dkhorn/organ/docs/CXSOMzauSu_CasavantOp3091R1983TrinitybytheCoveNaplesFL03.jpg

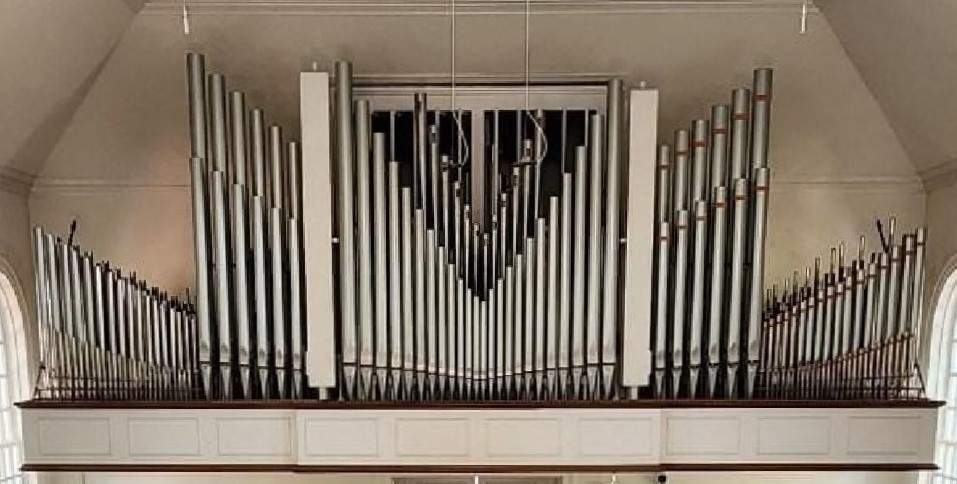
docs/CXSOMzauSu_CasavantOp3091R1983TrinitybytheCoveNaplesFL03.jpg
