dkhorn/organ/docs/TrinityCasevantPlan.png

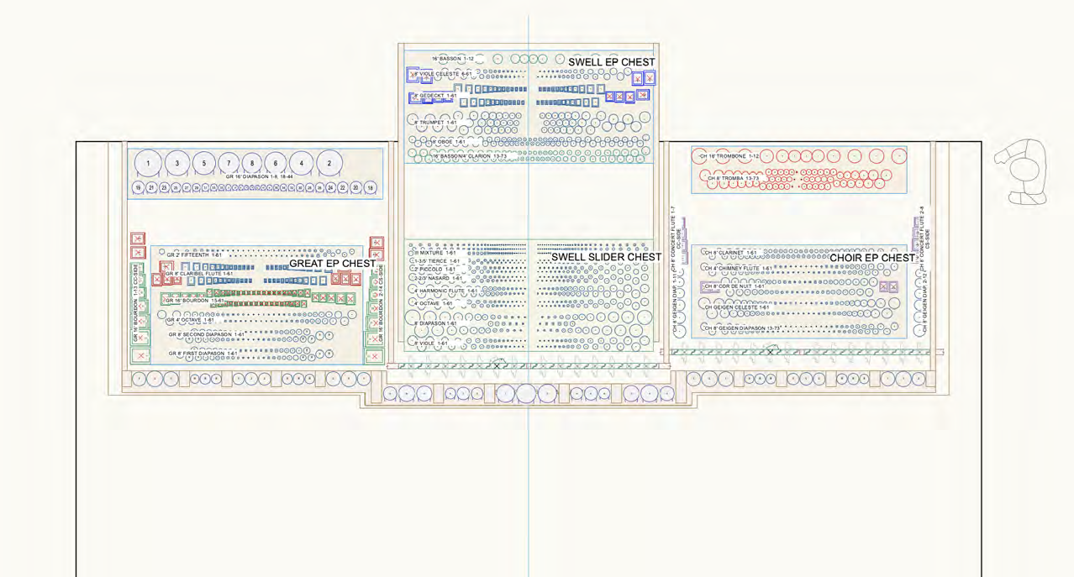
docs/TrinityCasevantPlan.png
