dkhorn/organ/docs/casavant_stoplist.md

```
Naples, Florida

Trinity-by-the-Cove Episcopal Church

Casavant Frères Ltée., Opus 3091, 1971
Casavant Frères Ltée., Opus 3091-R, 1983 - Tonal expansion
Thomas Helms, Jr., 2007 - Tonal Revision
```

## GRAND ORGUE
- 16    Bourdon
- 8     Montre
- 8     Flute à Cheminée
- 8     Viole de Gambe 8   (Réc.)  --
- 4     Prestant
- 4     Flute conique      (Réc.)  --
- 2     Petite Flute
- II    Cornet
- III   Mixture
-       Cloches

##      POSITIV
- 8     Bourdon
- 8     Viole de Gambe 8   (Réc.)  --
- 8     Voix céleste       (Réc.)  --
- 8     Flute douce        (Réc.)  --
- 4     Flute à Fuseau
- 4     Viole 4            (Réc.)  --
- 4     Flute douce 4      (Réc.)  --
- 2 2/3 Nasard 
- 2     Doublette
- 8     Cromorne
-       Tremblant

##     RÉCIT (Expressif/Swell)
- 16    Flute douce
- 8     Flute ouverte
- 8     Viole de Gambe
- 8     Voix céleste
- 8     Flute douce
- 4     Prestant
- 4     Flute conique
- 4     Viole 
- 4     Flute douce
- II    Quarte
- 16    Basson
- 8     Trompette
- 8     Hautbois
- 4     Petit Clairon
- 8     Voix humaine
-       Tremblant
-       Clochettes

##      PÉDALE
- 32    Basse acoustique           --  Soubasse
- 16    Soubasse
- 16    Bourdon            (G.O.)  --
- 16 & 8 Flutes douces     (Réc.)  --
- 8     Octave Basse
- 8     Viole              (Réc.)  --
- 8     Bourdon            (G.O.)  --
- 5 1/3 Quinte         (Soubasse)
- 4     Octave
- 4     Bourdon            (G.O.)  --
- 16    Bombarde
- 16    Basson             (Réc.)  --
- 8     Trompette          (Réc.)  --
- 8     Hautbois           (Réc.)  --
- 4     Hautbois           (Réc.)  --

      NOTES
The organ console The organ has a full complement of unison,
sub and super couplers; Positiv-Grand Orgue manual transfer;
five pistons for each division; twelve general combination
pistons; fifty memories; and transposer.

[Submitted by James R. Stettner  2023-05-01.]
