dkhorn/organ/docs/video_scripts/01_pipe_organ_intro_script.md

# Video Script Draft

## Title: So I Started Building a Pipe Organ…

---

## 0:00 — Cold Open (On Camera)

**Visuals**

- You sitting in the workshop
- large pipes and windchests visible behind you
- gesture toward the pile

**Dialogue (on camera)**

This pile of parts behind me is a pipe organ.

Or at least… part of one. Eventually.

---

## 0:10 — Montage / Voiceover

**Visuals**

- piles of pipes
- windchests
- console
- large pipes leaning on walls

**Voiceover**

But to explain how we got here… we need to go back a little.

---

## 0:15 — I Build Instruments (On Camera + Montage)

**On Camera**

I'm a musician… but I'm also an engineering‑minded tinkerer.

And for as long as I can remember I've liked building instruments.

**Cut to Montage**

- harp
- dulcimer
- whistles
- ukulele

**Voiceover**

Over the years I've made a few small ones — a harp, a dulcimer, some whistles… and most of a ukulele.

But like many engineering projects… things have a tendency to escalate.

---

## 0:50 — Why Pipe Organs (Voiceover)

**Visuals**

- pipe organs
- keyboards
- large pipe façades
- interior shots

I've played a lot of different instruments. But ever since I first encountered one in high school, the pipe organ has been my *dream* instrument.

Musically, nothing else really compares. A large organ can feel like having an entire orchestra under your hands.

To be clear, I'm not talking about this [very brief snippet of very boring organ music], but this: [very brief snippet of huge organ blast].

But what fascinated me just as much was the engineering. An organ isn't just an instrument — it's a huge machine with thousands of precision‑made moving parts.

For centuries they were among the most complicated mechanical systems people knew how to build.

And having one around to tinker with would be a sort of meta‑hobby — something that could involve woodworking, mechanics, electronics, and eventually music.

---

## 2:05 — The First Idea

So when I finished my last big project and looked at the clean workshop, I thought:

Why not finally build that pipe organ you've always wanted?

From scratch.

How hard could it be?

---

## — How a Pipe Organ Works (Quick Explanation)

**Visuals**

- keyboard being pressed
- valve / windchest diagram or footage
- air entering pipe
- pipes of different shapes
- stop knob being pulled

**Voiceover**

The basic idea is simple.

Each pipe plays one note when air flows through it.

Press a key… a valve opens… and air goes into the pipe.  Press a different key, air goes into a different pipe.

Long pipes make low notes. Short pipes make high notes.

Pipes with similar tone are grouped together into a *rank*. A keyboard needs about 61 pipes for a single rank.

The organist turns ranks on and off using *stops*, often combining many ranks at once.

Large organs may have dozens of ranks speaking together — which is what creates that huge symphonic sound.

---

## - DIY?

Pretty straightforward. They managed to build organs in the 16th century — surely I could figure it out in the 21st with modern tools and materials, right?

Well… after looking at a few DIY organ projects that others have completed, I realized that unless I invested in a lot of specialized equipment, I was going to be pretty limited in what I could realistically build.

And the result would probably be a lot of work… and a fairly feeble instrument.  It turns out that I really don't like DIY pipe organs

---

## 2:25 — A Better Plan

So instead of starting from nothing, I started looking for an instrument I could adopt as a starting point.

Here's where things got interesting. The "used organ" market is a strange place. Large organs are often very integrated with the building they're installed into, and it can be quite costly to extract them and rebuild them somewhere else.

As a result, while a good small studio or chapel organ might run tens of thousands of dollars, you can sometimes find much larger organs listed as basically *free to a good home*.

So why on earth should I start from scratch?

---

## 2:35 — Enter Paul Kruger (On Camera + Voiceover)

**On Camera**

That's when I met Paul Kruger.

**Voiceover / Visuals**

- photos of the Wicks organs
- pipes
- windchests

Paul is a lifelong organ enthusiast who had collected the remains of several similar small-to-medium-sized pipe organs, all built around 1940 by the same company - Wicks.

He had intended to restore these organs in one way or another, but currently had them in basically a "pile of parts" state.  He was ready to let it all go to someone who would attempt to continue his work.  This sounded like the perfect match for what I wanted to do - I figured I could learn a lot from picking up where he left off, and should be able to get a decent small organ out of it.

---

## 3:10 — The Arrival

**Visuals**

- unloading pipes
- workshop chaos

Which is how a truckload of organ parts ended up in my shop.

---

## 3:40 — The Work Begins - Termites

**Visuals**

- termite‑damaged boards
- cleaning parts
- inspecting wood
- photos of the big oven

Before everything was even off the truck, I hit the first surprise: termites.

Some console parts had been stored in rough conditions and picked up some very unwelcome guests. A few pieces were beyond saving and never made it into the shop — but I wanted to rescue as much as possible.

So I built a very large, very improvised oven — about eight feet long — using a space heater, fans, temperature probes, and a thermostat.

Every piece of wood went through it: slowly up to about 135°F internally, then held there for 12 hours.

After that, I didn’t see a single live termite. To be safe, everything also got treated with a borax-based wood insecticide.

The bugs were gone… but the damage remained. Most parts are salvageable with restoration; some will become templates for new ones.

---

## 4:10 — Pipe Sorting

**Visuals**

- measuring pipes
- laying pipes out
- organizing ranks

At the same time, I needed to figure out what I actually had.

Pipe organs are organized into rows called **ranks** — each one a full set of pipes covering the keyboard.

Each rank has dozens of pipes, and every pipe has a specific place.

So this meant sorting through hundreds of pipes from several different instruments… and putting them back into order.

---

## 4:20 — Electronics Work

**Visuals**

- solenoids
- old wiring
- CAD / PCB design
- electronics bench

In parallel, I started designing the organ’s new “central nervous system.”

The original organs used decades-old electrical systems.

Rather than restore all of that directly, the plan is to replace it with a modern control system — new wiring, new drivers, and eventually custom circuit boards.

So while the wood and pipes were being sorted… the electronics were being reinvented.

---

## 5:20 — The Tonal Plan

With the pipes identified, woodwork stabilized, and a path for modern electronics, I could finally step back and ask: what instrument am I actually building?

The collection had good foundations — about seven ranks — but it leaned heavily toward quieter, more expressive stops.

To get closer to a convincing organ, I needed a stronger principal chorus, real open 8′ tone, and some reeds.

---

## 5:45 — Filling the Gaps

So I started looking.

Very quickly I connected with another organ enthusiast in Naples, Jonathan Birner. His church had just remodeled and had a couple of orphaned ranks available.

They’re small but important: a four‑rank **mixture** and a 2′ **fifteenth** — exactly what I needed to build out the top of the principal chorus.

---

## 6:10 — Still Missing Voices

Even with those additions, the core was still incomplete.

I was missing the backbone of the sound:

Real **8′ principals**… and **reeds**.

---

## 6:35 — The Suggestion

A few weeks later, Jonathan sent me a message:

“Have you seen this listing? Looks like it has what you need.”

It was another church in Naples preparing to demolish and rebuild. A new organ was already planned, and the existing one needed to be removed — free to anyone willing to extract it.

It had exactly the ranks I needed to push my project into a respectable medium‑sized instrument.

---

## 7:20 — The Catch

There was one line in the listing:

“Preference will go to someone willing to take the entire instrument.”

---

## 7:35 — The Decision (On Camera recommended)

I assumed that made it impractical — someone would surely take the whole thing before I could cherry‑pick a few ranks.

Then I mentioned it off-hand to my wife, Ashley.

Her response was immediate:

“Just get the whole thing. Why not?”

I didn’t really have a good answer.  I probably should have.  But I didn't.

---

## 7:50 — Escalation

So I went down to take a look.

It’s a large organ, originally built in the 1970s and expanded in the 80's by French organ buliders Casavant — three manuals, pedal, about 23 ranks, and something like 1,800 pipes.

It had suffered from hurricane damage. The console was completely lost, and there’s some water intrusion in parts of the windchests.

But overall… it’s in remarkably good condition — honestly better than some of the Wicks components I’ve already been restoring. And the pipework is excellent.

So… why not.

I committed to rescuing the entire instrument over the next several months.

And instead of adding a few ranks to my earlier design, I'm pivoting to make the Casavant the core of the instrument, with my previous small organ thoughtfully integrated.

So at the end of this, if all goes well, instead of a completely improvised small organ with a fully-jumbled provenance, I will have "Casevant, Opus 3091, 1971; Expanded 1983; Expanded and relocated 2026" [text on screen]

---

## 8:10 — Series Teaser

In the coming videos we’ll go into some detail about things that I've already been working on, and hopefully cover new developments as they happen.:

- planning the Casavant extraction
- designing the new instrument
- restoring windchests
- building the control system
- sorting and voicing pipes
- and eventually assembling it all into a working organ

---

## 8:40 — Closing (On Camera)

So I started building a pipe organ.

Let’s see where this goes.

So I started building a pipe organ.

Let's see where this goes.
