dkhorn/organ/docs/TrinityOrganChecklist.docx

ACCESS & EXTRACTION PATH

☐ Exterior loading area documented (photos)

☐ Truck access confirmed (clearance, backing space)

☐ Path from organ to exit photographed

☐ Narrowest doorway width measured

☐ Lowest ceiling clearance measured

☐ Stair count + widths measured

☐ Tight corners / obstacles documented

☐ On-site staging area identified

OVERALL ORGAN LAYOUT

☐ Full frontal overview photo

☐ Side overview photo(s)

☐ Chamber/back overview photo

☐ Division locations identified (GO / POS / REC / PED)

☐ Quick layout sketch drawn

☐ Swell box location identified

☐ Blower location identified

PIPEWORK – INVENTORY & MASS

☐ All visible façade ranks photographed

☐ Largest flue pipe length estimated

☐ Largest flue pipe diameter estimated

☐ Confirmed no pipes > 8′ physical

☐ 8′ open bass ranks identified (count)

☐ 16′ stopped ranks identified (count)

☐ Reed resonators photographed (bass end)

☐ Wood bass pipes photographed (if present)

☐ Rank labels / markings photographed

CHESTS & ACTION

☐ Chest type identified (slider / unit / EP / other)

☐ Number of chests per division counted

☐ Chest dimensions measured (L × D × H)

☐ Pallet / slider condition visually checked

☐ Magnet/solenoid condition photographed

☐ Any visible water damage documented

☐ Chest mounting method observed (bolted / screwed / fixed)

REEDS

☐ 16′ reeds inspected (rust / condition)

☐ 8′ reeds inspected (rust / condition)

☐ Reed resonator material noted (zinc / spotted metal / other)

☐ Boots / blocks condition checked

☐ Reed tuning wires intact

WIND SYSTEM

☐ Regulators/reservoirs counted

☐ Regulator dimensions measured

☐ Pressure markings photographed

☐ Separate wind pressures identified (if any)

☐ Wind trunk routing photographed

☐ Trunk attachment method noted

ELECTRICAL

☐ Existing wiring harnesses photographed

☐ Connectors identified

☐ Relay panels located (if present)

☐ Junction boxes documented

☐ Any labeling system photographed

CONDITION SURVEY

☐ Dents in metal pipes noted

☐ Corrosion on metal pipes noted

☐ Wood pipe cracks / delamination checked

☐ Tuning slides present and functional

☐ Evidence of mold / severe humidity damage checked

☐ Structural case stability assessed

EXTRACTION PLANNING NOTES

☐ Sequence of pipe removal considered

☐ Rackboard removal method observed

☐ Chest removal constraints identified

☐ Estimated manpower required noted

☐ Estimated truck size required noted

☐ Special tools required noted

QUESTIONS ETC

☐ Documentation?

☐ Timing – don’t want to sit too long without climate control

GRAND ORGUE

16 Bourdon

8 Montre

8 Flute à Cheminée

4 Prestant

2 Petite Flute

II Cornet

III Mixture

POSITIV

8 Bourdon

4 Flute à Fuseau

2 2/3 Nasard

2 Doublette

8 Cromorne

PÉDALE

16 Soubasse

8 Octave Basse

4 Octave

16 Bombarde

RÉCIT (Expressif)

16 Flute douce

8 Flute ouverte

8 Viole de Gambe

8 Voix céleste

8 Flute douce

4 Prestant

4 Flute conique

4 Viole

4 Flute douce

II Quarte

16 Basson

8 Trompette

8 Hautbois

4 Petit Clairon

8 Voix humaine

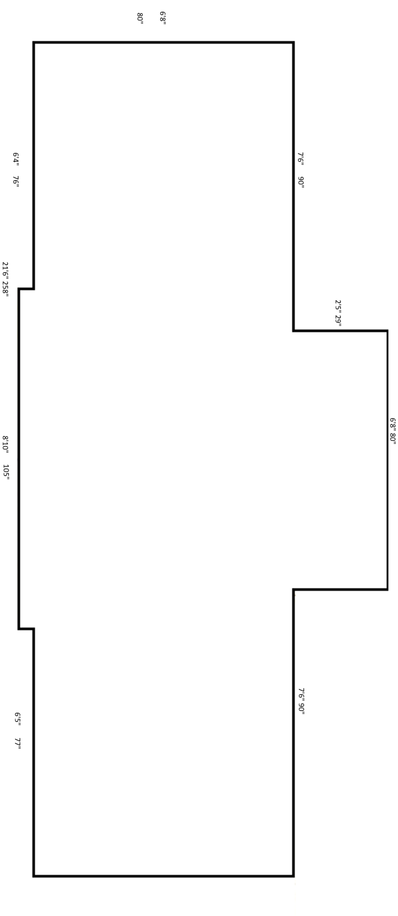
[picture p3: figure]
