dkhorn/organ/docs/ranklist.md

# Ranks - by windchest

## Casavant Great Slider
These are not individually addressable and cannot be borrowed other than via coupling
- 8' Flute a Cheminee - 61 notes - (Chimney Flute - 4' physical length)
- 4' Prestant - 61 notes
- 4' Petite Flute - 61 notes
- Cornet II - 61 notes (122 pipes)
- Mixture IV - 61 notes (244 pipes)

## Casavant Great Facade
These are all individually addressable and can be borrowed, unified, etc
- 16' Bourdon (metal, stopped, 8' physical length) - 61 notes
- 8' Montre (metal, open, 8' physical length) - 61 notes

## Casavant Positiv Slider
These are not individually adressable and cannot be borrowed other than via coupling
- 8' Bourdon (metal, stopped, 4' physical length) - 61 notes
- 4' Flute a Fuseau - 61 notes
- 2 2/3' Nasard - 61 notes
- 2' Doublette - 61 notes
- 8' Cromorne (reed - half-length, 4' physical length) - 61 notes

## Casavant Pedal facade
Individually addressable, can be borrowed, unified, etc
- 16' Soubasse (wood, 8' physical length) - 32 notes
- 8' Octave Basse (metal principal-type) - 44 notes - (also used as a "4' Octave" stop)
- 16' Bombarde (reed, metal, 8' physical length) - 32 notes

## Casavant Swell Slider
Not individually addressable
- 8' flute ourverte (metal, open, 8' length) - 61 notes
- 4' Prestant (metal, open,  4' length) - 61 notes
- Mixture II - 61 notes (122 pipes)

## Casavant Swell Unit
All individually addressable, borrowable, etc
- 8' trumpet (reed, metal, 8' length) - 61 notes - also used as 4' clarion stop
- 16' Bassoon/ 8' Oboe (reed, metal, half-length resonators (longest is 8')) - 73 notes
- 8' Viole de Gambe (flute, metal, open, 8' length) - 61 notes - also used as 4' Viole stop
- 8' Fl. Douce (flute, metal, conical, 8' length) - 73 notes - also used as 16' and 4' stops
- 8' Celeste (flute, metal, open, Tenor C (longest pipe is 4')) - 49 notes

## Casavant Swell extensions
All individually addressable, borrowable, etc
- 4' Flute conique - 61 notes
- 8' Vox Humana - 61 notes

## Wicks Unit chest
All individually addressable, borrowable, etc
- 8' Stopped Flute (wood, stopped, physical length 4') - 85 notes - can be unified 8', 4', or 2', or mutations
- 4' Salicional - (metal, open) 61 notes
- 4' Celeste - (metal, open) 49 notes (no top octave)

## Wicks/Other principal chorus chest
All individually addressable - but the mixture pipes are combined per note into a single valve
- 4' Open Diapason (Metal, open, Wicks)- 61 notes
- 2' fifteenth (Metal, open, not Wicks) - 61 notes
- Mixture IV (Metal, open, not Wicks) - 61 notes (244 pipes)

## Wicks Gedeckt
individually addressable
- 16' Gedeckt (Stopped flute, physical length 8', bass octave on extension chest) - 97 notes - can be unified 16', 8', 4', 2, or mutations

## Ancient Bourdon
- 16' large-scale bourdon (wood, stopped, 8' physical length) - 32 notes (pedal)

# Divisions
Here's how the above windchests will be physically arranged by division

Great/Pedal (unenclosed):
- Casavant Great Slider
- Casavant Great Facade
- Casavant Pedal facade
- Ancient Bourdon

Positiv (unenclosed):
- Casavant Positiv Slider
- Wicks/Other principal chorus chest

Swell/Recit (enclosed, with operable shades):
- Casavant Swell Slider
- Casavant Swell Unit
- Casavant Swell Extensions
- Wicks Gedeckt

Echo/Choir:
- Wicks Unit chest

# StopList
Great
- 16 Montre (8' Montre)
- 16 Bourdon
- 8 Montre
- 8 Bourdon (16' Bourdon)
- 8 Flûte à Cheminée
- 4 Prestant
- 4 Petite Flûte
- 2 Fifteenth (Positiv)
- Cornet II
- Mixture IV
- 8 Trompette (Swell)
- 8 Oboe (Swell)
- 4 Clarion (Swell)

Positiv
- 8 Montre (Great)
- 8 Bourdon
- 4 Principal
- 4 Flûte à Fuseau
- 2 2/3 Nasard
- 2 Fifteenth
- 2 Doublette
- Mixture IV
- 8 Cromorne

Recit/Swell (Enclosed)
- 16 Gedeckt
- 8 Viole de Gambe
- 8 Voix Céleste
- 8 Flûte Douce
- 8 Gedeckt (16' Gedeckt)
- 2 2/3 Nazard (8' Fl Douce)
- 1 3/5 Tierce (8' Fl Douce)
- 4 Viole
- 4 Flûte Conique
- 4 Flute Douce (8' Fl Douce)
- 4 Gedeckt (16' Gedeckt)
- 2 Gedeckt (16' Gedeckt)
- 2 Flute Douce (8' Fl Douce)
- Plein Jeu II
- 16 Bassoon
- 8 Vox Humana
- 8 Trompette
- 8 Hautbois (16' Bassoon)
- 4 Clarion (4' Trompette)

Choir/Echo
- 8 Stopped Flute
- 8 Salicional (4' Sal)
- 8 Celeste (4' Cel)
- 2 2/3 Nazard (8' Stopped Fl)
- 1 3/5 Tierce (8' Stopped Fl)
- 4 Stopped Flute (8' Stopped Fl)
- 4 Salicional
- 4 Celeste
- 2 Stopped Flute (8' Stopped Fl)

Pedal
- 32 Resultant (Soubasse + Quinte)
- 16 Soubasse
- 16 Bourdon
- 16 Gedeckt (Swell)
- 5 1/3 Quinte (Soubasse)
- 8 Octave
- 8 Bourdon (Great)
- 8 Gedeckt (Swell)
- 4 Choralbass (Octave)
- 4 Gedeckt (Swell)
- 16 Bombarde
- 16 Bassoon (Swell)
- 8 Trompette (Swell)
- 8 Hautbois (Swell)
- Mixture IV (Pos)
