dkhorn/organ/docs/stoplist_wicks_hybrid.md

# Hybrid Pipe Organ – Stoplist v3.2
**3 Manuals + Pedal**

This revision incorporates:
- M5 (1′ Violin / Flachflute) moved into the Swell box as a high string color
- Choir division made entirely borrowed / digital (“playground manual”)
- No borrowing out of tremmed ranks
- W2 physically split into unenclosed (A) and Swell (B) chests
- W1 extended downward to form a true open 8′ flute rank

Legend  
(P) = real pipes  
(D) = digital  
(E) = extension / unification  
(B) = borrowed  

---

## GREAT (Manual I)
_Unenclosed_

| Stop | Pitch | Source |
|-----|---|---|
| Principal | 8′ | M1 (P) |
| Octave | 4′ | M1 (P) |
| Fifteenth | 2′ | M1 (E)(P) |
| Principal | 16′ | M1 (E)(P) |
| Mixture | IV–V | (D) |
| Trumpet | 8′ | (D) |
| Clarion | 4′ | (D) |
| Flute | 8′ | W1 (P) |
| Flute | 4′ | W1 (P) |
| Bourdon | 16′ | W2-A (B)(P) |
| Bourdon | 8′ | W2-A (B)(E)(P) |

---

## SWELL (Manual II)
_Enclosed · Tremulant_

| Stop | Pitch | Source |
|-----|---|---|
| Salicional | 8′ | M4 (P) |
| Voix Celeste | 8′ | M3 (P, sharp) |
| Salicional | 4′ | M4 (E)(P) |
| Dulciana | 8′ | M2 (E)(P) |
| Gedackt | 8′ | W2-B (P) |
| Flute | 4′ | W2-B (E)(P) |
| **High String / Piccolo** | **2′** | **M5 (E)(P)** |
| Fifteenth | 2′ | (D) |
| Mixture | III | (D) |
| Oboe | 8′ | (D) |
| Trumpet | 8′ | (D) |
| Tremulant | — | — |

Notes:
- M5 resides physically in the Swell box and is affected by expression and tremulant.
- W2-B is a dedicated Swell-only chest (no borrowing out).

---

## CHOIR / SOLO (Manual III)
_Playground Manual — borrowed & digital only_

| Stop | Pitch | Source |
|-----|---|---|
| Lieblich Gedackt | 8′ | W2-A (B)(E)(P) |
| Flute | 4′ | W2-A (B)(E)(P) |
| Piccolo | 2′ | M5 (B)(E)(P, non-tremmed) |
| Nazard | 2 2⁄3′ | (D) |
| Tierce | 1 3⁄5′ | (D) |
| Larigot | 1 1⁄3′ | (D) |
| Cymbale | III | (D) |
| Clarinet | 8′ | (D) |
| Vox Humana | 8′ | (D) |
| Tremulant | — | (D only) |

Notes:
- No pipes live physically in the Choir.
- Borrowed ranks are non-tremmed and level-scaled digitally.
- Choir trem affects digital voices only.

---

## PEDAL
_Unenclosed · Hybrid_

| Stop | Pitch | Source |
|-----|---|---|
| Bourdon | 16′ | W2-A (P) |
| Tibia Bass | 16′ | W3 (P) |
| Subbass (free reed) | 16′ | R1 (P) |
| Bourdon | 8′ | W2-A (E)(P) |
| Flute | 4′ | W2-A (E)(P) |
| Open Flute | 8′ | W1 (B)(P) |
| Principal | 8′ | M1 (B)(E)(P) |
| Mixture | IV | (D) |
| Trombone | 16′ | (D) |
| Trumpet | 8′ | (D) |
| Resultant | 32′ | (D) |

---

## COUPLERS
- Swell → Great  
- Choir → Great  
- Swell → Choir  
- Great → Pedal  
- Swell → Pedal  
- Choir → Pedal  
- Sub / Super couplers as musically appropriate  

---

## PHYSICAL SUMMARY (v3.2)

### Swell Box (expressive, tremmed)
- M4 — Salicional (61 pipes)
- M3 — Voix Celeste (49 pipes)
- M5 — High string / Piccolo (49 pipes - dedicated chest)
- W2 — Swell Gedackt / Flute (85 pipes)
- Digital Swell reeds & mixture (Speakers)
- Single tremulant

### Unenclosed
- M1 — Principal chorus (61 pipes)
- W1 — Open flute 8′ / 4′ (85 pipes + 12 to-be-constructed on floor)
- W2-B — Bourdon family low (12 on floor)
- W3 — Tibia bass (24 large pipes)
- R1 — Free-reed subbass (no pipes, just a box)
- Digital pedal foundations

### Choir
- No physical pipes
- Borrowed and digital only

---

## DESIGN PRINCIPLES ENFORCED
- No borrowing out of tremmed ranks
- No rank serves contradictory wind behaviors
- Manual 16′ ≠ Pedal 16′
- Digital ranks fill brilliance and extreme ranges, not foundations
