dkhorn/organ/docs/IrjlOnneqD_CasavantOp3091R1983TrinitybytheCoveNaplesFL02.jpg

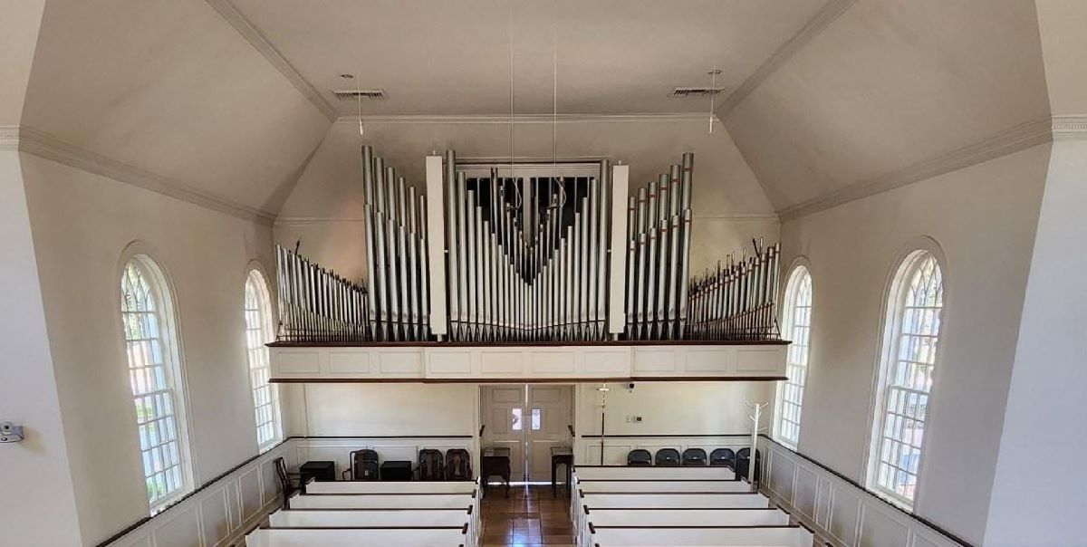
docs/IrjlOnneqD_CasavantOp3091R1983TrinitybytheCoveNaplesFL02.jpg
