dkhorn/organ/docs/TrinityCasevantElevation.png

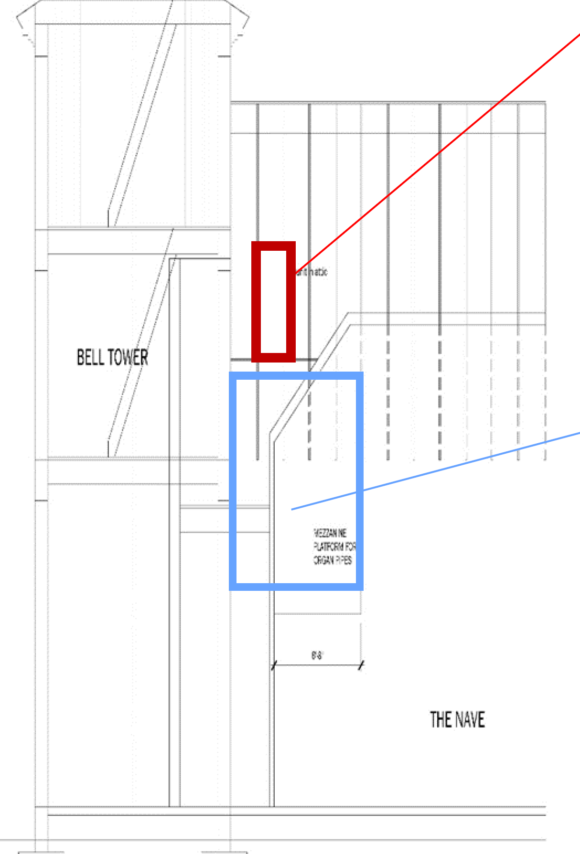
docs/TrinityCasevantElevation.png
