dkhorn/organ/docs/TrinityCasevantPlan_Blank.png

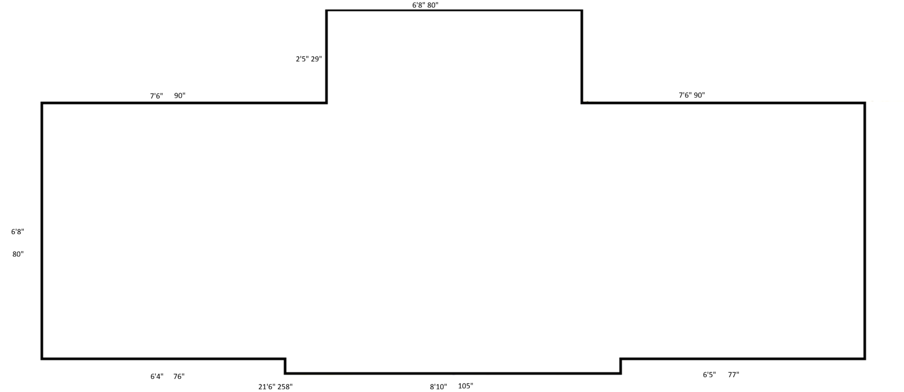
docs/TrinityCasevantPlan_Blank.png
