dkhorn/organ/docs/inventory.md

# Pipe Organ Project — Physical Inventory

_Last updated: 2025-12-22_

This document records **all physical components currently in possession**, without assuming future purchases.  
Descriptions are factual; condition notes are included where relevant.

---

## 1. Consoles & Control Furniture

### C1 — Black Console
- Manufacturer: Wicks
- Model: Fuga Deluxe
- Opus: **1471**
- Condition: structurally intact
- Notes:
  - Opus number “1471” written in multiple internal locations

### C2 — Walnut Console
- Manufacturer: Wicks
- Opus: **2107**
- Condition: intact
- Notes:
  - Brass dedication plaque present (Wilhite home installation)

### C3 — Salvaged Console Components
- Manufacturer: Wicks
- Opus: **2472**
- Salvaged components:
  - Manual stack (2 manuals)
  - Stopboard
  - Pedalboard
- Condition:
  - Original casework destroyed (termite damage)
  - Salvaged components serviceable

---

## 2. Wind Supply Components

### WND-1 — Main Blower
- Output pressure measured:
  - ~4″ w.g. nominal
  - ~5″ w.g. with increased regulator weight
- Status: operational

### WND-2 — Standalone Regulator
- Connections: 6″ OD inlet / outlet
- Status: intact

### WND-3 — Wind Distribution Box
- Input: 8″
- Outputs: 7 × ~4″
- Status: intact

---

## 3. Complete Windchests

### CH-1 — Large Black Wicks Unit Chest
- Dimensions: 59.75″ W × 19″ D × 9″ H
- Pipe seat markings:
  - A1–A32
  - B1–17
  - C1–25
  - D1–25
  - E1–11
  - F1–16
  - G1–30
  - H1–31
  - R1–4, L1–4
- Wind connections:
  - Bottom: 4″ and 6″ flanges
  - Top: centered 2″ flange
- Electrical:
  - 50-pin connectors
  - All solenoids present but rusted
- Condition:
  - Chest leaky but salvageable
  - Soundboard and rack in good condition
  - Solenoids require rebuild

### CH-2 — Hobes Sound Unit Chest
- Dimensions: 18″ L × 12″ D × 11″ H
- Material: blonde wood
- Electrical:
  - Solenoids present
  - 50-pin connector
- Status: intact

### CH-3 — 12-Note Bass Windchest (Stopped Wood Flutes)
- Function: lowest octave (8′ physical / 16′ pitch)
- Compass: 12 notes
- Valve type: electric-pneumatic
- Dimensions:
  - Chest: 69″ L × 9″ D × 4.5″ H
  - Rack: 69″ W × 60″ H
- Condition:
  - Slight leakage
  - Fully functional

---

## 4. Rack Boards

### RK-1 — Black Rack Board
- Width: 59.75″
- Depth: 16″
- Matches: CH-1
- Status: good

---

## 5. Loose Soundboards

### SB-1 — Small Irregular Soundboard
- Dimensions: 52″ × 9″ × 1.25″
- Channels: 24
- Hole sizes: ~3/8″–3/4″
- Layout: irregular
- Electrical:
  - 24 solenoids present
  - Wiring intact (nail terminals)
- Wind port: 4.25″
- Condition:
  - Solenoids rough
  - No matching rack

### SB-2 — Large Wicks-Style Soundboard
- Dimensions: 84″ × 10″ × 1″
- Channels: 85
- Hole sizes: ~3/4″ to ~1/4″
- Construction:
  - Largest 12 backed by +1″ thickness
- Electrical:
  - 24 solenoids present
- Condition:
  - Structurally sound
  - Action incomplete

### SB-3 — Termite-Damaged Soundboard
- Dimensions: 84″ × 10″ × 1″
- Channels: ~128 (30 + 31 + 33 + 34)
- Electrical:
  - ~45 solenoids present
- Condition:
  - Severe internal termite damage
  - Template/reference only

### SB-4 — Unit-Chest Soundboard (Single Rank)
- Dimensions: 65″ × 7″ × 1″
- Channels: 61
- Hole sizes: ~3/4″ to ~1/8″
- Electrical:
  - All solenoids present
  - Free-moving
  - Pads degraded
- Markings:
  - “rank3”

### SB-5 — Unit-Chest Soundboard (Double Rank)
- Dimensions: 65″ × 12.75″ × 1″
- Channels:
  - Rank A: 61
  - Rank B: 85
- Construction:
  - Largest 6 holes backed by +1″ thickness
- Electrical:
  - Solenoids present
  - ~30% require rework
  - Pads degraded

---

## 6. Pipes (High-Level Summary)

### Metal Ranks
- M1 — Open Diapason, 4′ (61 pipes)
- M2 — Dulciana, 4′ (49 pipes)
- M3 — Salicional, 4′ (49 pipes)
- M4 — Salicional, 4′ (61 pipes)
- M5 — Violin / Flachflute, 1′ (49 pipes)

### Wood Ranks
- W1 — Stopped Flute, 4′ physical  (8' pitch)
  (7 octaves: 61 wood + 24 metal treble, mitred basses)
- W2 — Stopped Flute, 8′ physical  (16' pitch)
  (8 octaves: 73 wood + 24 metal treble)
- W3 — Wide-scale "tibia"-ish Stopped Flute, 8′ physical  (16' pitch) 
  (bass only - 2 octaves: 24 wood pipes) 
### Reed
- R1 - Wicks free-reed subbass box 16' (1 octave, 12 notes)
---

## 7. Solenoids & Small Parts

- Reisner solenoids:
  - 140 blue, 90 Ω
  - 30 tan, 90 Ω
  - 260 tan, 75 Ω
  - 8 gray, 90 Ω
- Peterson solenoids:
  - 7 × 90 Ω
  - 2 × 60 Ω
  - 2 × 50 Ω
- Miscellaneous:
  - 1 Franz Heissler solenoid (12 V, 28 Ω)
  - 6 medium unmarked solenoids (~30 Ω)
- Felt:
  - ~100 × 22 mm
  - ~100 × 18 mm
  - ~100 × 16 mm

---

## 8. Notes

- Inventory reflects all parts currently owned.
- Future changes should be appended rather than rewritten.
