dkhorn/organ/kicad/OrganLEDArray/assembly/OrganLEDArrayBOM.xlsx

Comment | Designator | Footprint | JLCPCB Part #（optional）
green LED | D1,D2,D3,D4,D5,D6,D7,D8,D9,D10,D11,D12,D13,D14,D15,D16,D17,D18,D19,D20,D21,D22,D23,D24 | LED_0603_1608Metric
6.8k | R1,R2,R3,R4,R5,R6,R7,R8,R9,R10,R11,R12,R13,R14,R15,R16,R17,R18,R19,R20,R21,R22,R23,R24 | R_0603_1608Metric
0.1u | C1 | C_0603_1608Metric
