dkhorn/organ/3dmodels/keyparts/PedalKeyswitchShims-Body.stl

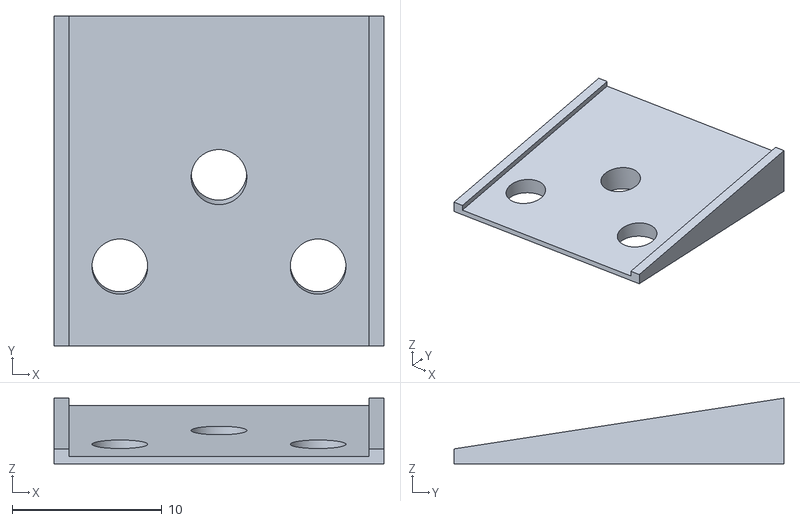
[picture p7: CAD file, 2026-04-03]
3dmodels/keyparts/PedalKeyswitchShims-Body.stl
22.0 x 22.0 x 4.39
