dkhorn/organ/3dmodels/pipes/StoppedFluteWoodBase.FCStd

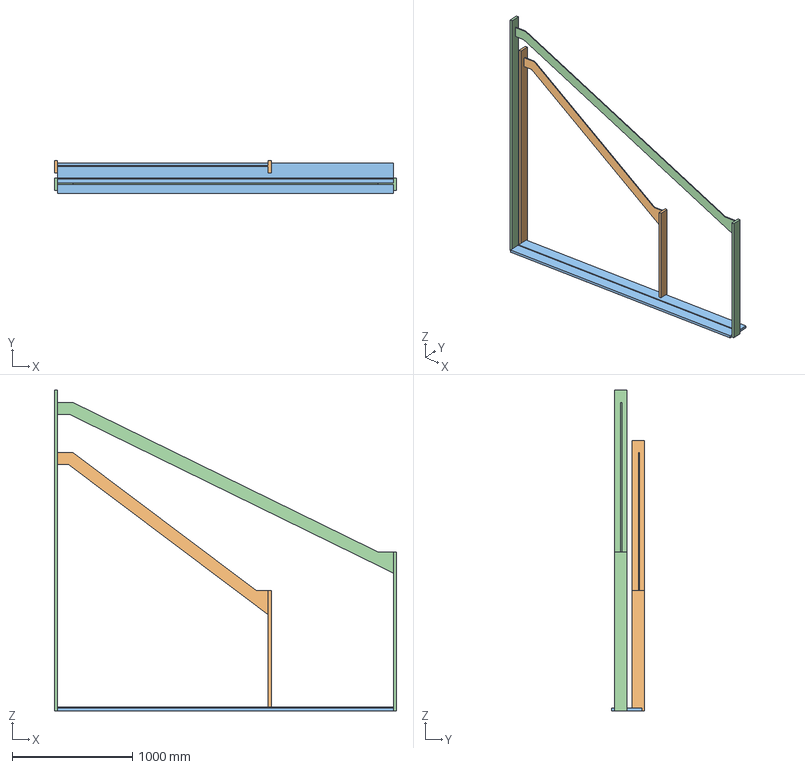
[picture p8: CAD file, 2026-03-30]
3dmodels/pipes/StoppedFluteWoodBase.FCStd
2844.8 x 273.1 x 2667.0 mm
ToeBoard
Rail
ToeBoard001
Rail001
