dkhorn/organ/3dmodels/tools/Combs/IDC26Comb.FCStd

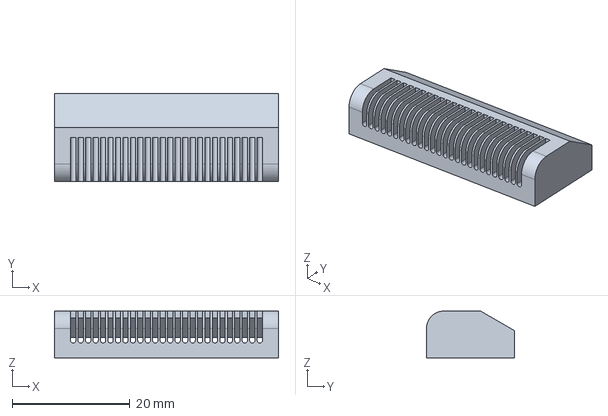
[picture p9: CAD file, 2026-02-11]
3dmodels/tools/Combs/IDC26Comb.FCStd
38.1 x 15.0 x 8.00 mm
