dkhorn/organ/3dmodels/tools/KeyBushingCauls/KeyBushingCauls_1475-Single.stl

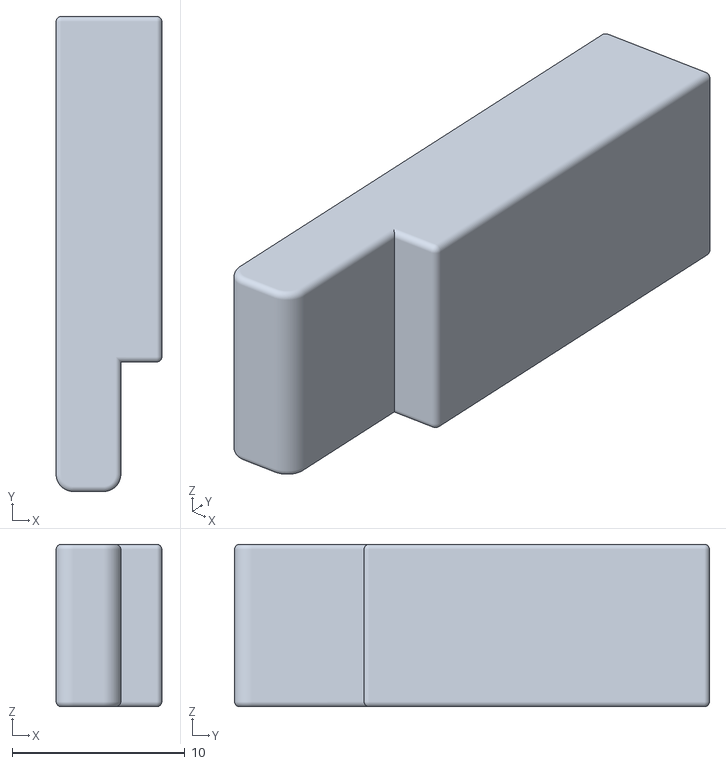
[picture p10: CAD file, 2026-02-11]
3dmodels/tools/KeyBushingCauls/KeyBushingCauls_1475-Single.stl
6.12 x 27.5 x 9.40
