dkhorn/organ/3dmodels/tools/planning/pipe_trays.FCStd

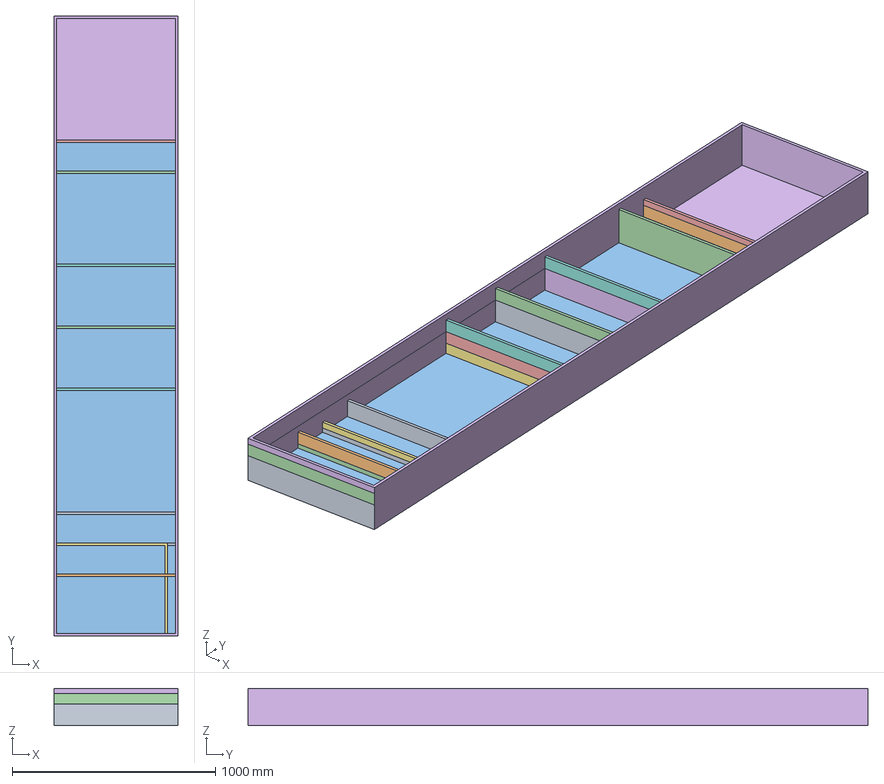
[picture p11: CAD file, 2026-03-26]
3dmodels/tools/planning/pipe_trays.FCStd
609.6 x 3048.0 x 184.2 mm
Box90x24x4
Box90x24x3
Box90x24x2
Box90x24x6
Box72x24x4
Box72x24x3
Box72x24x2
Box72x24x6
Box60x24x4
Box60x24x3
Box60x24x2
Box60x24x6
Box48x24x4
Box48x24x3
Box48x24x2
Box48x24x6
Box24x24x3
Box24x24x2
Box24x24x1
Box120x24x008
Box120x24x6
Box120x24x7
Box18x24x3
Box18x24x2
Box18x24x1
Box12x24x3
Box12x24x2
Box12x24x1
Box90x24x5
Box72x24x5
Box60x24x5
Box48x24x5
Box120x24x5
Box96x24x4
Box96x24x3
Box96x24x2
Box96x24x6
Box120x24x4
