dkhorn/organ/3dmodels/tools/UniversalTransferPunch_bases.stl

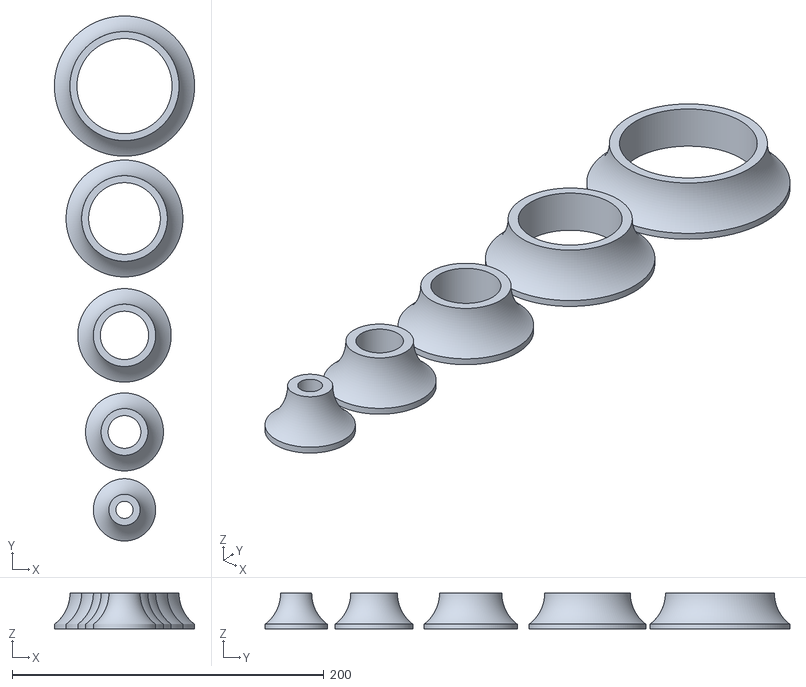
[picture p12: CAD file, 2026-03-05]
3dmodels/tools/UniversalTransferPunch_bases.stl
90.0 x 337.0 x 23.0
