dkhorn/organ/3dmodels/valveparts/double_valve_pin_guides-ValveStemGuide38.stl

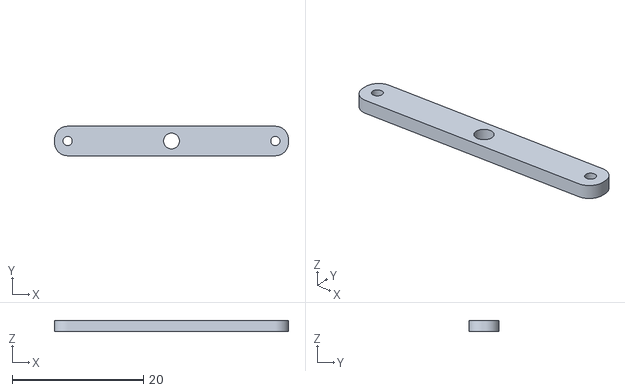
[picture p13: CAD file, 2026-03-05]
3dmodels/valveparts/double_valve_pin_guides-ValveStemGuide38.stl
35.6 x 4.50 x 1.75
