dkhorn/organ/3dmodels/planning/organ_layout.FCStd

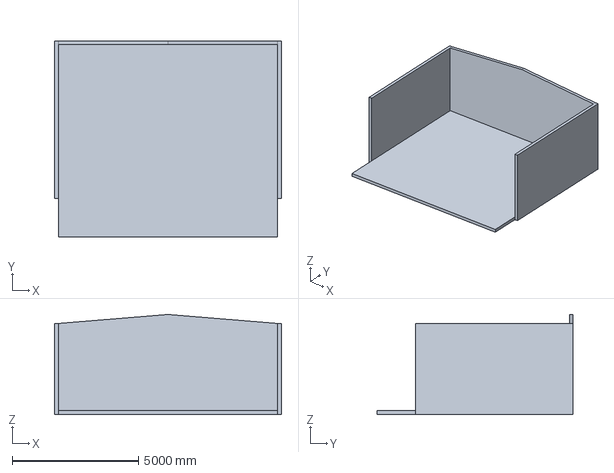
[picture p14: CAD file, 2026-03-16]
3dmodels/planning/organ_layout.FCStd
8991.6 x 7772.4 x 3962.4 mm
