dkhorn/organ/3dmodels/tools/KeyBushingCauls/KeyBushingCauls_1475.FCStd

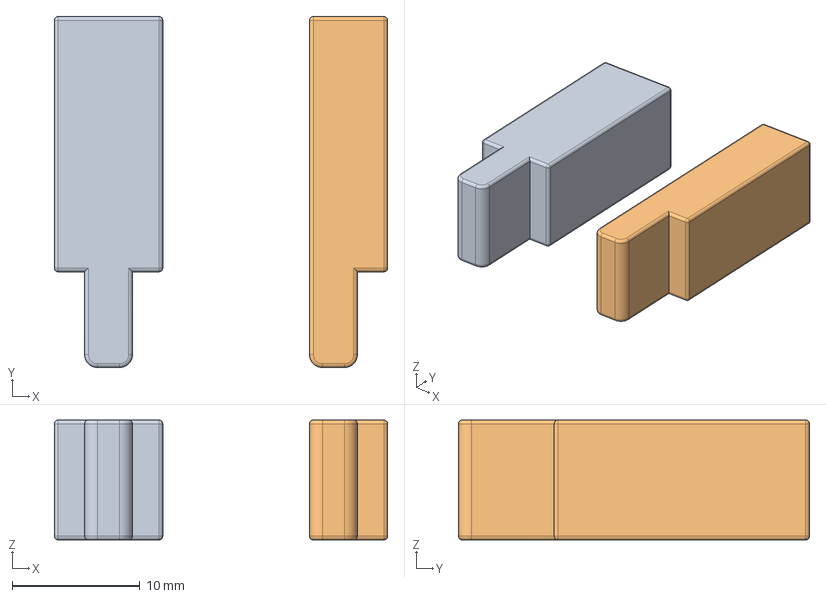
[picture p15: CAD file, 2026-02-11]
3dmodels/tools/KeyBushingCauls/KeyBushingCauls_1475.FCStd
26.1 x 27.5 x 9.40 mm
Double
Single
