dkhorn/organ/3dmodels/tools/planning/ranks_bigvan.FCStd

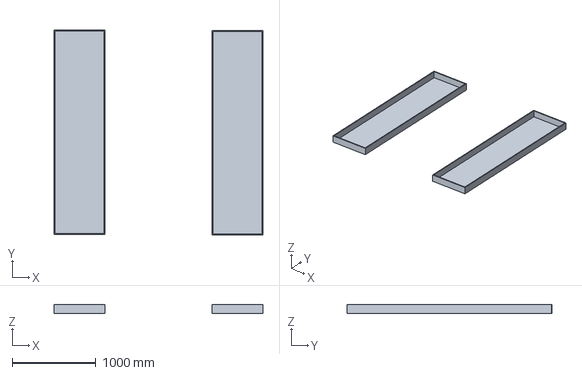
[picture p16: CAD file, 2026-03-26]
3dmodels/tools/planning/ranks_bigvan.FCStd
2492.6 x 2443.4 x 107.9 mm
Box96x24x4 x 6
