dkhorn/organ/3dmodels/tools/UniversalTransferPunch_tools.stl

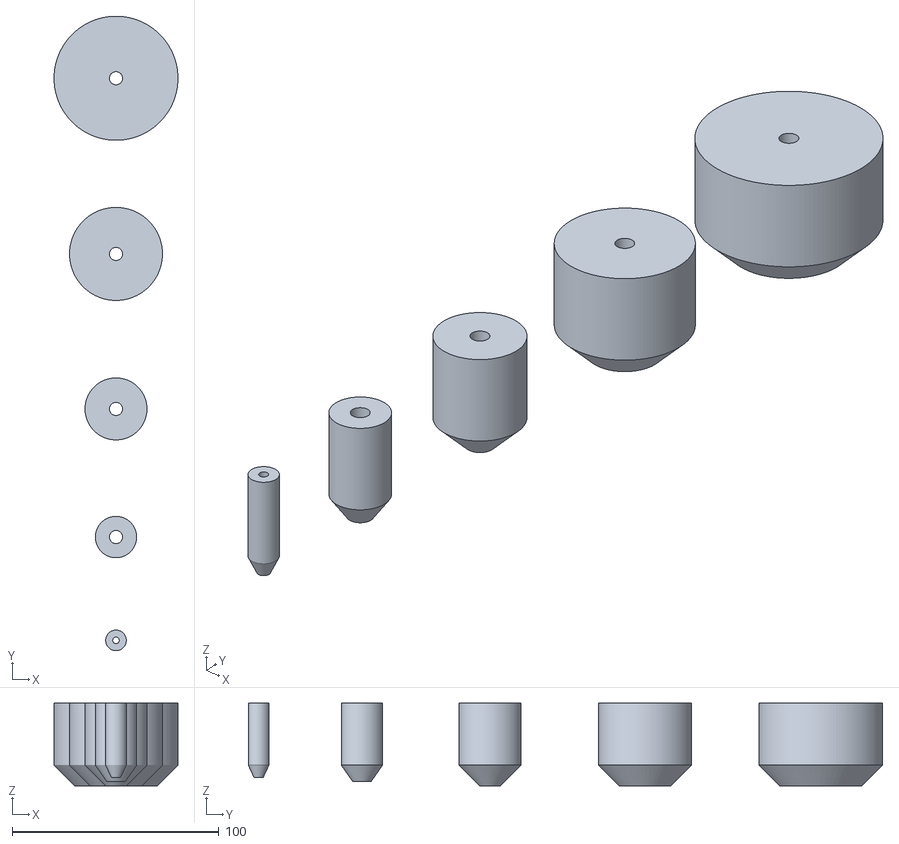
[picture p17: CAD file, 2026-03-05]
3dmodels/tools/UniversalTransferPunch_tools.stl
60.0 x 307.0 x 40.0
