dkhorn/organ/3dmodels/valveparts/double_valve_pin_guides.FCStd

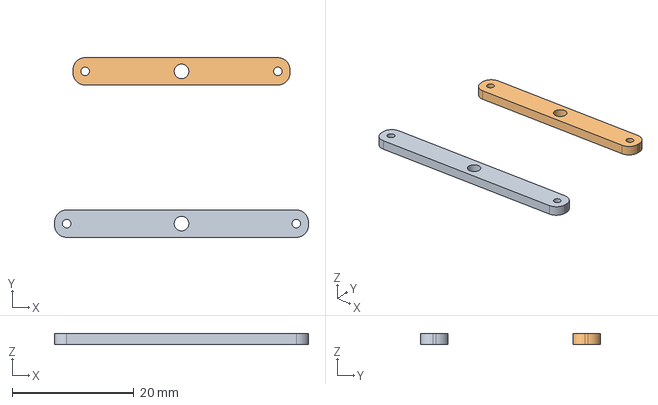
[picture p18: CAD file, 2026-03-05]
3dmodels/valveparts/double_valve_pin_guides.FCStd
41.7 x 29.5 x 1.75 mm
ValveStemGuide45
ValveStemGuide38
