dkhorn/organ/3dmodels/planning/organ_layout-printable-1.5scale.3mf

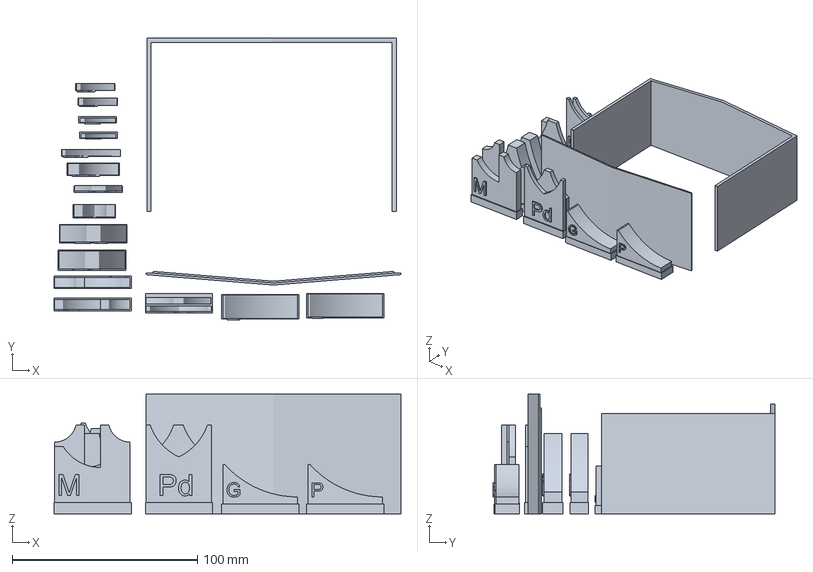
[picture p19: CAD file, 2026-03-10]
3dmodels/planning/organ_layout-printable-1.5scale.3mf
187.6 x 152.2 x 64.8 mm
