dkhorn/organ/3dmodels/tools/KeyBushingCauls/KeyBushingCauls_1475-Double.stl

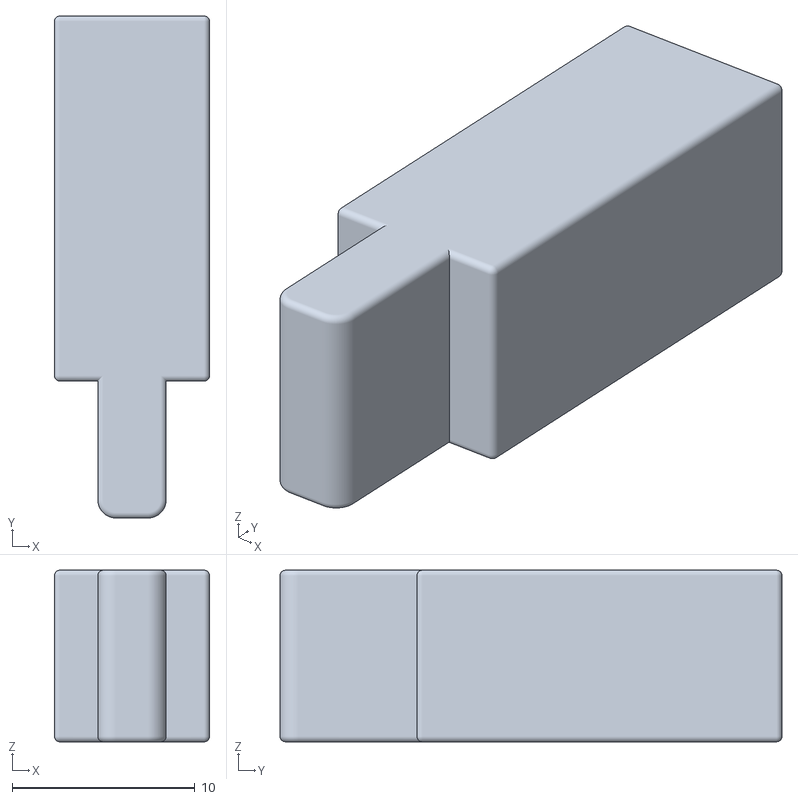
[picture p20: CAD file, 2026-02-11]
3dmodels/tools/KeyBushingCauls/KeyBushingCauls_1475-Double.stl
8.50 x 27.5 x 9.40
