dkhorn/organ/3dmodels/tools/UniversalTransferPunch.FCStd

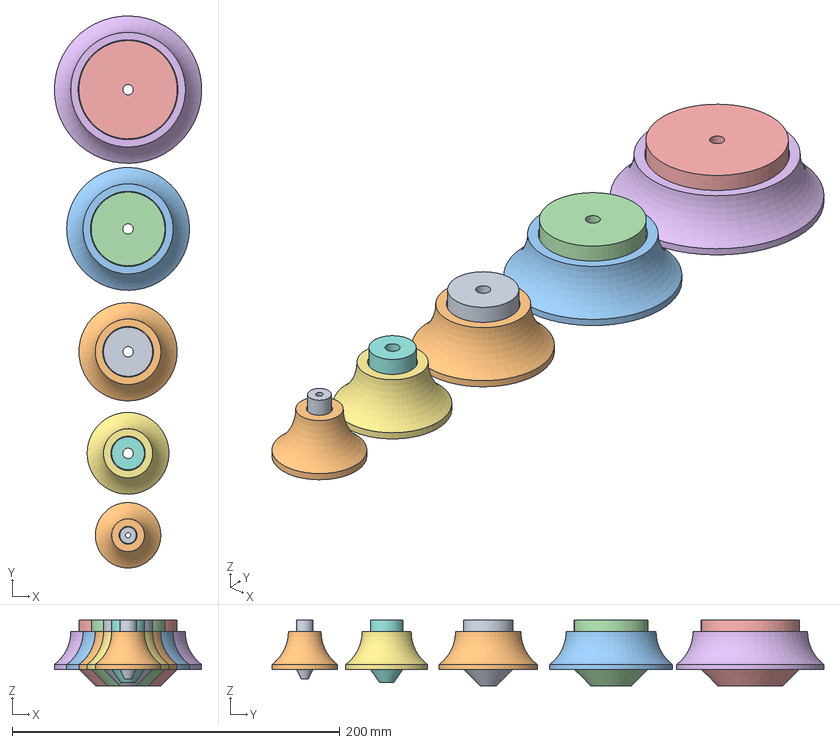
[picture p21: CAD file, 2026-03-05]
3dmodels/tools/UniversalTransferPunch.FCStd
89.9 x 337.0 x 40.0 mm
Tool30 x 2
Base30 x 2
Base45 x 2
Tool45 x 2
Tool60 x 2
Base60 x 2
Base20 x 2
Tool20 x 2
Tool10 x 2
Base10 x 2
