dkhorn/organ/3dmodels/valveparts/double_valve_pin_guides-ValveStemGuide45.stl

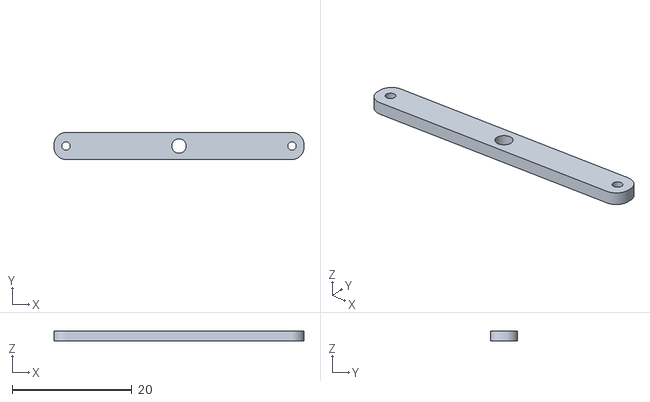
[picture p22: CAD file, 2026-03-05]
3dmodels/valveparts/double_valve_pin_guides-ValveStemGuide45.stl
41.7 x 4.50 x 1.75
