dkhorn/organ/3dmodels/planning/organ_layout-printable.stl

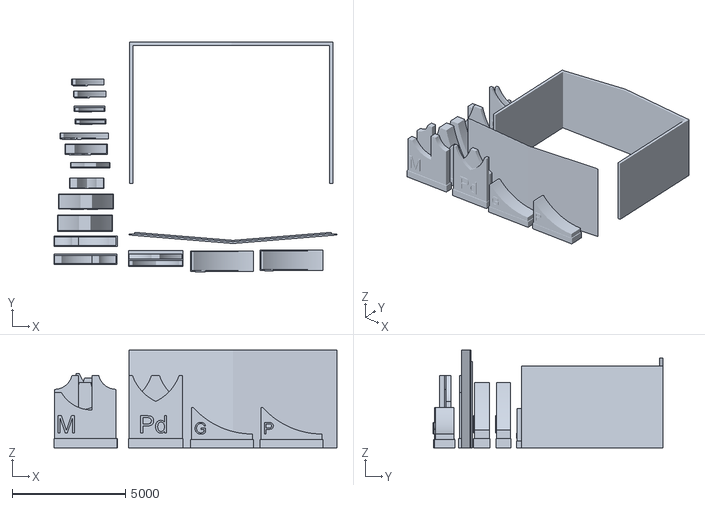
[picture p23: CAD file, 2026-03-09]
3dmodels/planning/organ_layout-printable.stl
12503.8 x 10148.8 x 4318.0
