dkhorn/organ/3dmodels/planning/pipes_prototypes.FCStd

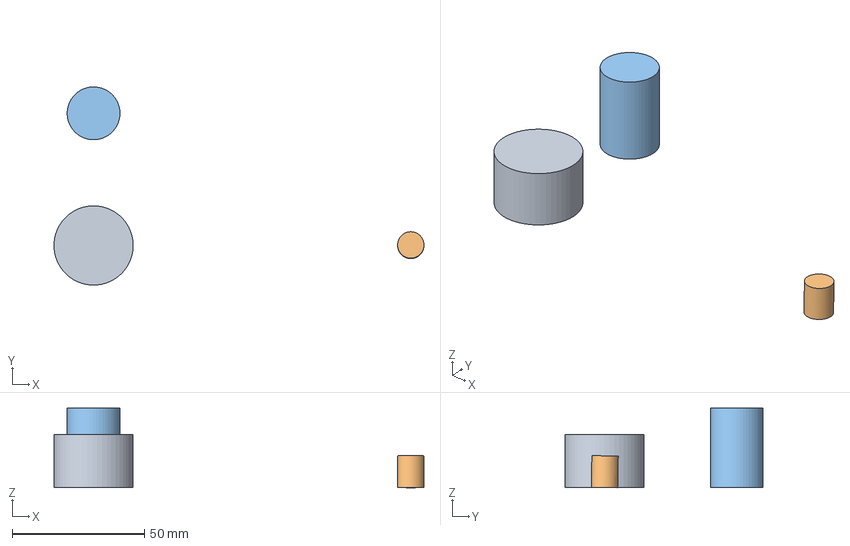
[picture p24: CAD file, 2026-03-05]
3dmodels/planning/pipes_prototypes.FCStd
140.0 x 75.0 x 30.1 mm
