dkhorn/organ/3dmodels/tools/planning/windchests.FCStd

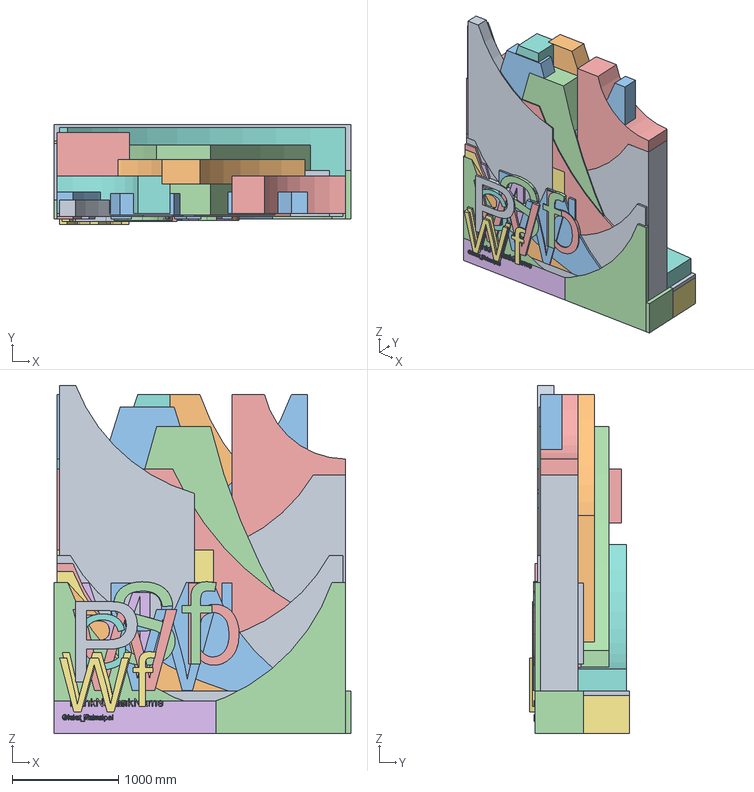
[picture p25: CAD file, 2026-03-16]
3dmodels/tools/planning/windchests.FCStd
2794.0 x 939.8 x 3276.6 mm
Chest1
Rank_Linear
Rank_MiddleHigh
Rank_MiddleLow
Positiv_Chest
Pos_Cromorne
Great_Chest
Great_Chorus
Pedal_Chest
Pedal_Bombarde
Pedal_OctaveBass
GreatFront_Chest
GreatMontre_Bass
GreatMontre_Treble
PositivFront_Chest
GreatBourdon_Bass
GreatBourdon_Treble
SwellFront_Chest
SwellBack_chest
Rank_SwellUnUnified
Rank_SwellUnified
SwellBack_chest001
Rank_MiddleLow001
SwellBack_chest002
Rank_MiddleLow002
WicksSubBass_chest
Rank_WicksSubBass_chest
WicksBourdonPedal_Chest
WicksBourdonRank
WicksFlutes_Chest
WicksFlutes_Rank
PedalSubbassC_Chest
PedalSubbassC_Rank
PedalSubbassCSharp_Chest
PedalSubbassCsharp_Rank
WicksPrincipalChorusC_Chest
WicksPrincipalChorusC_Rank
WicksPrincipalChorusCSharp_chest
WicksPrincipalChorusCSharp_rank
PassageBoard
