dkhorn/organ/3dmodels/tools/planning/pipe_blocks.FCStd

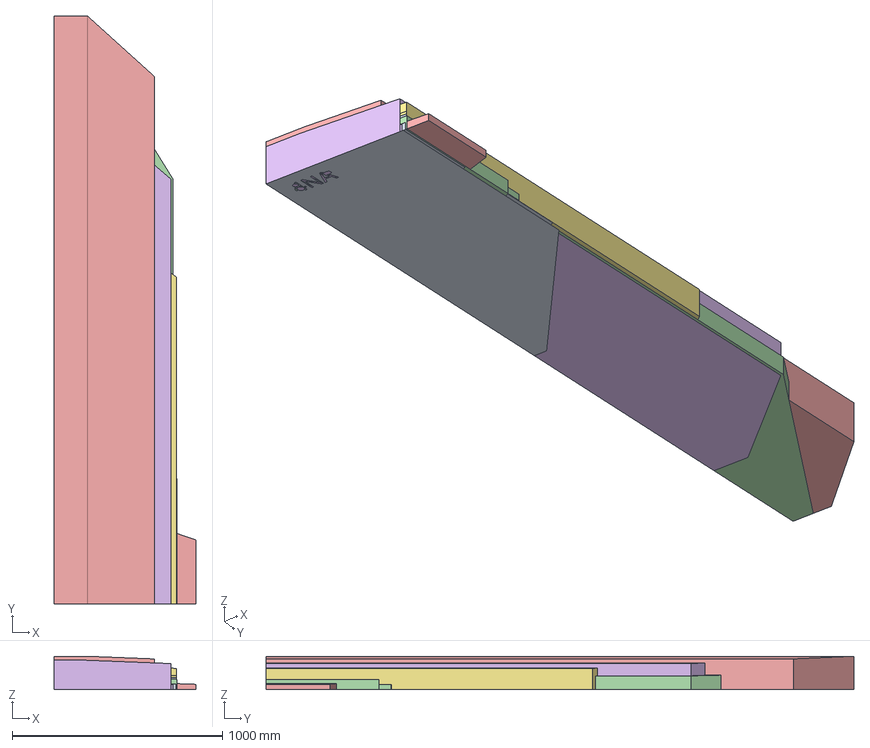
[picture p26: CAD file, 2026-03-09]
3dmodels/tools/planning/pipe_blocks.FCStd
673.9 x 2794.0 x 158.8 mm
1WA
1WB
1WS
2WA
2WB
2WS
NWA
NWB
NWC
NWS
4WA
4WB
4WC
4WD
4WE
4WS
4NA
4NB
4NS
4NES
8WA
8WB
8WC
8WD
8WE
8WF
8WS
8NA
8NB
8NC
8NS
8NES
8WPS
8WPEF
8WPES
8NPC
