dkhorn/organ/(list of files, cad)

Other CAD files:
3dmodels/planning/organ_layout_2.FCStd
3dmodels/keyparts/PedalKeyswitchShims.FCStd
3dmodels/pipes/BourdonPedalPipes.FCStd
3dmodels/pipes/BourdonPedal.FCStd
3dmodels/tools/planning/ranks.FCStd
3dmodels/tools/planning/VanPacking.FCStd
