dkhorn/organ/kicad/OrganKeyswitchBreakout/OrganKeyswitchBreakout.kicad_pcb

## KiCad design kicad/OrganKeyswitchBreakout/OrganKeyswitchBreakout.kicad_pcb (2026-02-11)

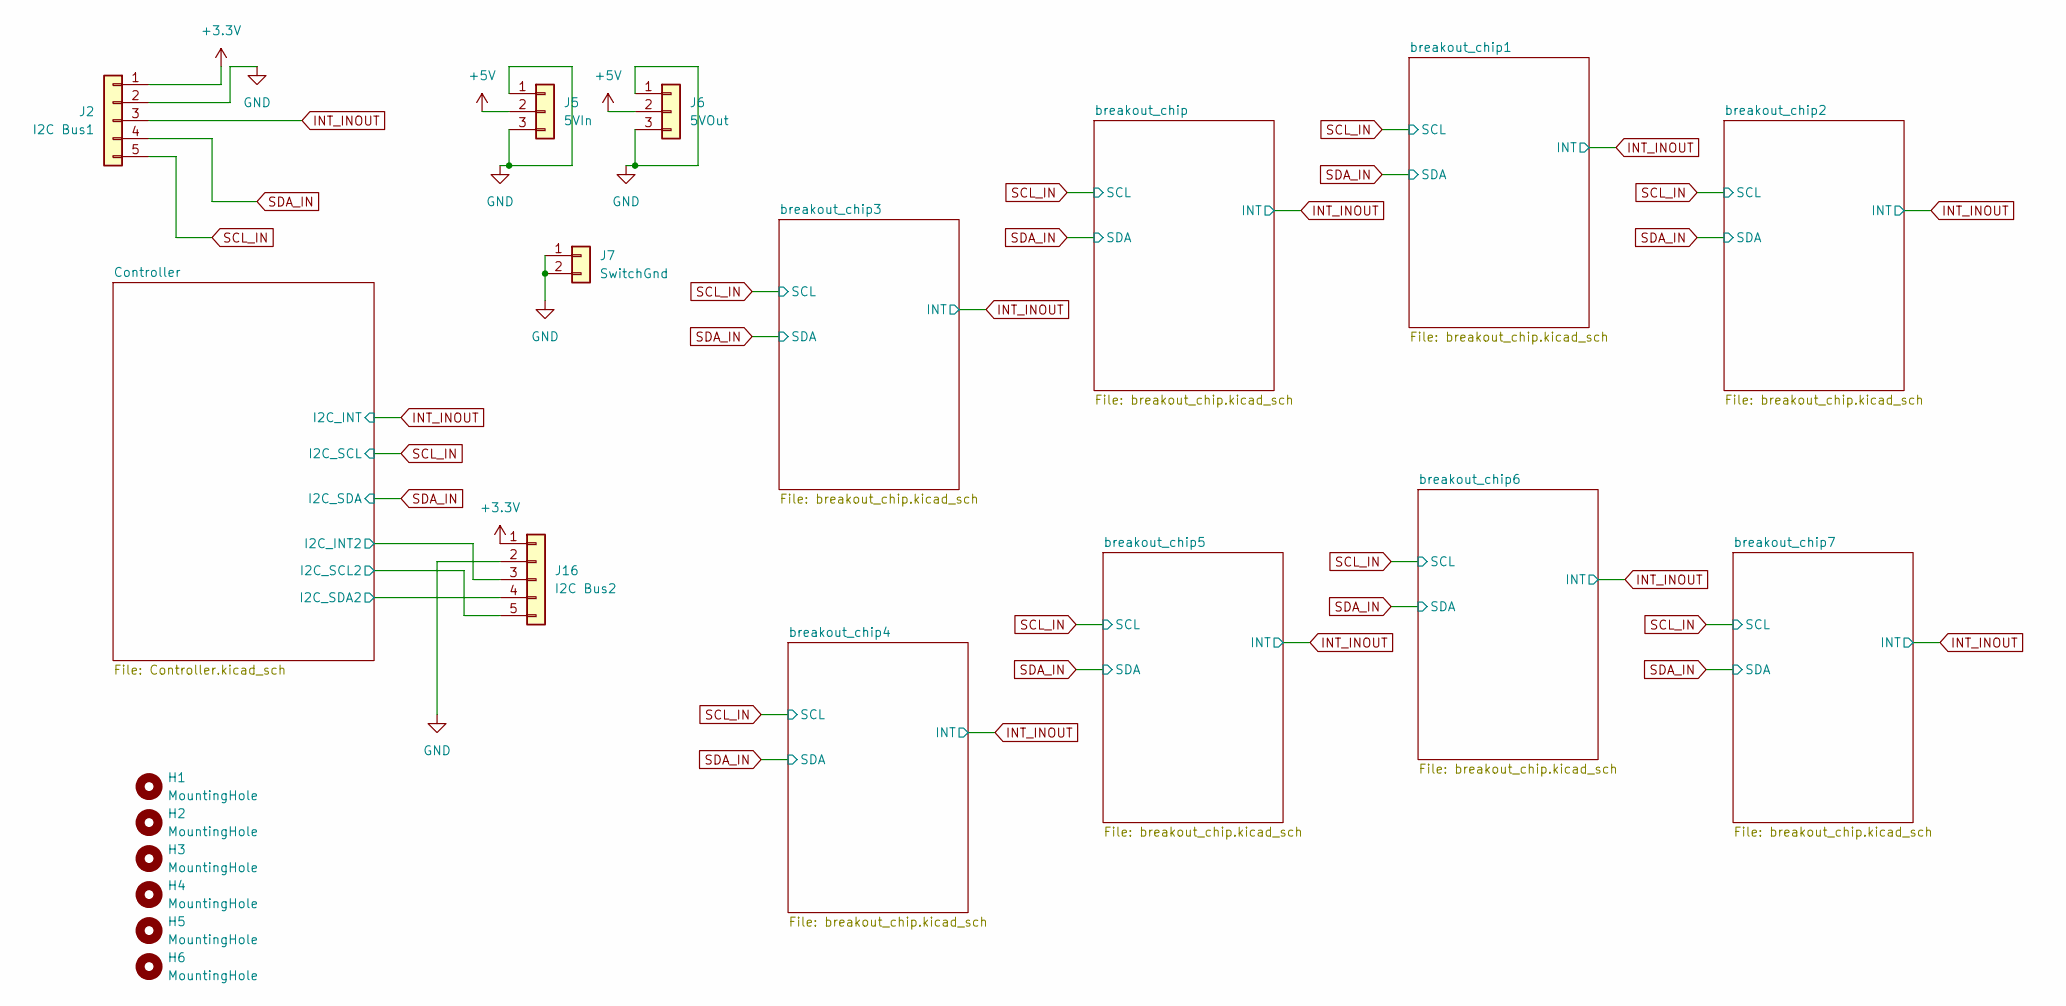
[picture p27: schematic OrganKeyswitchBreakout.kicad_sch]

Parts:
H1, H2, H3, H4, H5, H6: MountingHole; MountingHole_3.2mm_M3
J2: I2C Bus1; JST_PH_B5B-PH-K_1x05_P2.00mm_Vertical
J5: 5VIn; JST_PH_B3B-PH-K_1x03_P2.00mm_Vertical
J6: 5VOut; JST_PH_B3B-PH-K_1x03_P2.00mm_Vertical
J7: SwitchGnd; JST_PH_B2B-PH-K_1x02_P2.00mm_Vertical
J16: I2C Bus2; JST_PH_B5B-PH-K_1x05_P2.00mm_Vertical

Connections:
+3.3V: J2.1, J16.1; also elsewhere on the board
+5V: J5.2, J6.2; also elsewhere on the board
/Controller/I2C_INT2: J16.3; also elsewhere on the board
/Controller/I2C_SCL2: J16.5; also elsewhere on the board
/Controller/I2C_SDA2: J16.4; also elsewhere on the board
GND: J2.2, J5.1, J5.3, J6.1, J6.3, J7.1, J7.2, J16.2; also elsewhere on the board
INT_INOUT: J2.3; also elsewhere on the board
SCL_IN: J2.5; also elsewhere on the board
SDA_IN: J2.4; also elsewhere on the board

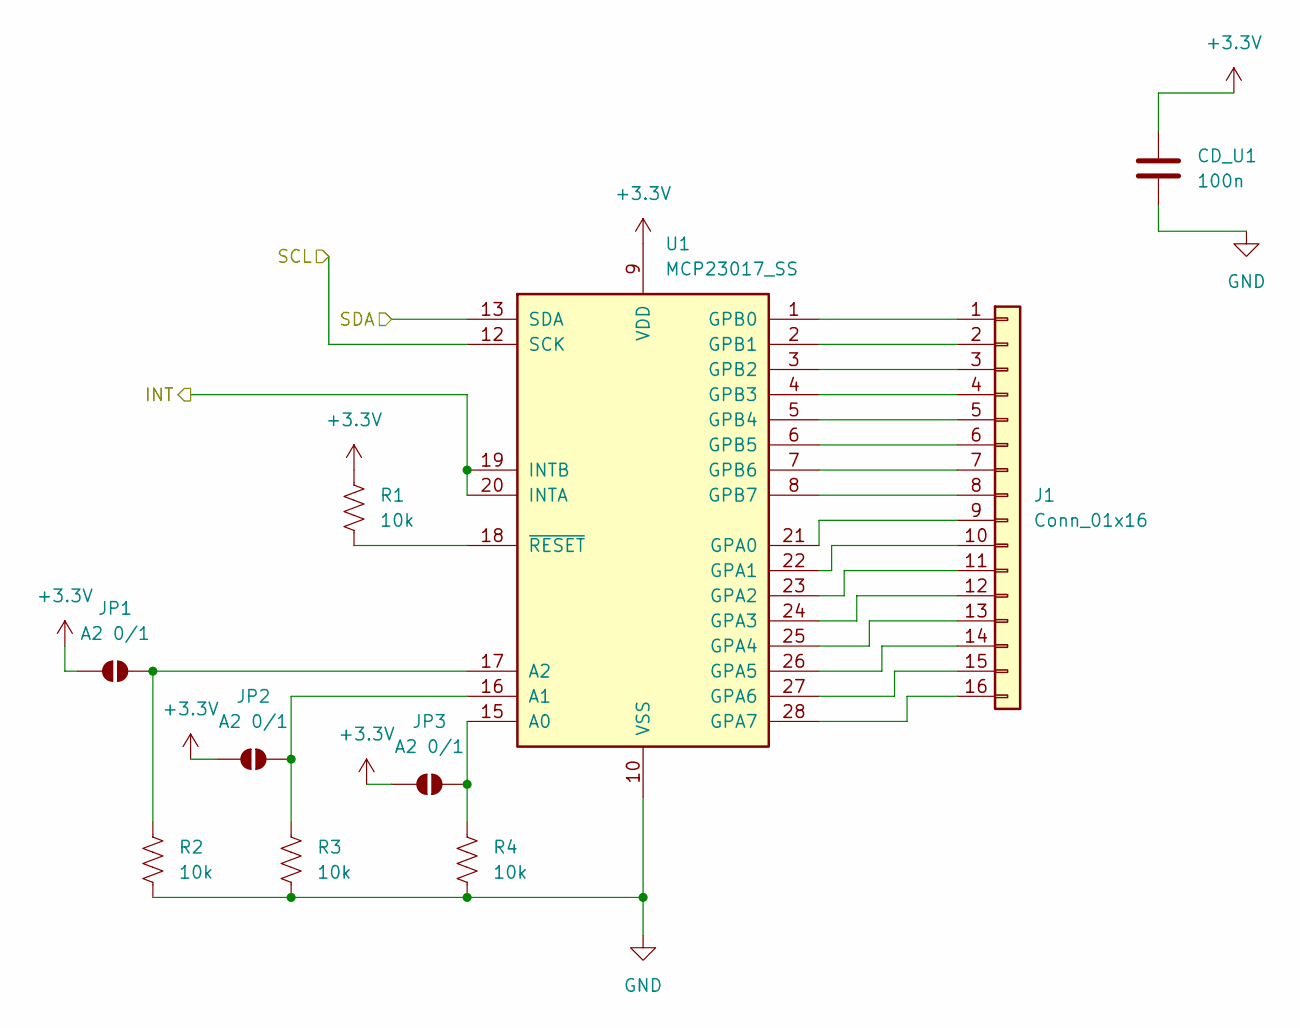
[picture p28: schematic breakout_chip.kicad_sch]

Parts:
CD_U1: 100n; C_0805_2012Metric
J1: Conn_01x16; IDC-Header_2x08_P2.54mm_Vertical
JP1, JP2, JP3: A2 0/1; SolderJumper-2_P1.3mm_Bridged_RoundedPad1.0x1.5mm
R1, R2, R3, R4: 10k; R_0805_2012Metric
U1: MCP23017_SS; SSOP-28_5.3x10.2mm_P0.65mm

Connections:
+3.3V: CD_U1.1, JP1.1 (A), JP2.1 (A), JP3.1 (A), R1.1, U1.9 (VDD); also elsewhere on the board
GND: CD_U1.2, R2.2, R3.2, R4.2, U1.10 (VSS); also elsewhere on the board
INT_INOUT: U1.19 (INTB), U1.20 (INTA); also elsewhere on the board
unnamed: J1.1, U1.1 (GPB0)
unnamed: J1.2, U1.2 (GPB1)
unnamed: J1.3, U1.3 (GPB2)
unnamed: J1.4, U1.4 (GPB3)
unnamed: J1.5, U1.5 (GPB4)
unnamed: J1.6, U1.6 (GPB5)
unnamed: J1.7, U1.7 (GPB6)
unnamed: J1.8, U1.8 (GPB7)
unnamed: J1.9, U1.21 (GPA0)
unnamed: J1.10, U1.22 (GPA1)
unnamed: J1.11, U1.23 (GPA2)
unnamed: J1.12, U1.24 (GPA3)
unnamed: J1.13, U1.25 (GPA4)
unnamed: J1.14, U1.26 (GPA5)
unnamed: J1.15, U1.27 (GPA6)
unnamed: J1.16, U1.28 (GPA7)
unnamed: JP1.2 (B), R2.1, U1.17 (A2)
unnamed: JP2.2 (B), R3.1, U1.16 (A1)
unnamed: JP3.2 (B), R4.1, U1.15 (A0)
unnamed: R1.2, U1.18 (~RESET)
SCL_IN: U1.12 (SCK); also elsewhere on the board
SDA_IN: U1.13 (SDA); also elsewhere on the board

Parts of its further copies:
CD_U3, CD_U4, CD_U5, CD_U6, CD_U7, CD_U8, CD_U9: 100n; C_0805_2012Metric
J8, J9, J10, J11, J12, J13, J14: Conn_01x16; IDC-Header_2x08_P2.54mm_Vertical
JP4, JP5, JP6, JP7, JP8, JP9, JP10, JP11, JP12, JP13, JP14, JP15, JP16, JP17, JP18, JP19, JP20, JP21, JP22, JP23, JP24: A2 0/1; SolderJumper-2_P1.3mm_Bridged_RoundedPad1.0x1.5mm
R12, R13, R14, R15, R16, R17, R18, R19, R20, R21, R22, R23, R24, R25, R26, R27, R28, R29, R30, R31, R32, R33, R34, R35, R36, R37, R38, R39: 10k; R_0805_2012Metric
U4, U5, U6, U7, U8, U9, U10: MCP23017_SS; SSOP-28_5.3x10.2mm_P0.65mm

Connections of its further copies:
+3.3V: CD_U3.1, CD_U4.1, CD_U5.1, CD_U6.1, CD_U7.1, CD_U8.1, CD_U9.1, JP4.1 (A), JP5.1 (A), JP6.1 (A), JP7.1 (A), JP8.1 (A), JP9.1 (A), JP10.1 (A), JP11.1 (A), JP12.1 (A), JP13.1 (A), JP14.1 (A), JP15.1 (A), JP16.1 (A), JP17.1 (A), JP18.1 (A), JP19.1 (A), JP20.1 (A), JP21.1 (A), JP22.1 (A), JP23.1 (A), JP24.1 (A), R12.1, R16.1, R20.1, R24.1, R28.1, R32.1, R36.1, U4.9 (VDD), U5.9 (VDD), U6.9 (VDD), U7.9 (VDD), U8.9 (VDD), U9.9 (VDD), U10.9 (VDD); also elsewhere on the board
GND: CD_U3.2, CD_U4.2, CD_U5.2, CD_U6.2, CD_U7.2, CD_U8.2, CD_U9.2, R13.2, R14.2, R15.2, R17.2, R18.2, R19.2, R21.2, R22.2, R23.2, R25.2, R26.2, R27.2, R29.2, R30.2, R31.2, R33.2, R34.2, R35.2, R37.2, R38.2, R39.2, U4.10 (VSS), U5.10 (VSS), U6.10 (VSS), U7.10 (VSS), U8.10 (VSS), U9.10 (VSS), U10.10 (VSS); also elsewhere on the board
INT_INOUT: U4.19 (INTB), U4.20 (INTA), U5.19 (INTB), U5.20 (INTA), U6.19 (INTB), U6.20 (INTA), U7.19 (INTB), U7.20 (INTA), U8.19 (INTB), U8.20 (INTA), U9.19 (INTB), U9.20 (INTA), U10.19 (INTB), U10.20 (INTA); also elsewhere on the board
unnamed: J8.1, U4.1 (GPB0)
unnamed: J8.2, U4.2 (GPB1)
unnamed: J8.3, U4.3 (GPB2)
unnamed: J8.4, U4.4 (GPB3)
unnamed: J8.5, U4.5 (GPB4)
unnamed: J8.6, U4.6 (GPB5)
unnamed: J8.7, U4.7 (GPB6)
unnamed: J8.8, U4.8 (GPB7)
unnamed: J8.9, U4.21 (GPA0)
unnamed: J8.10, U4.22 (GPA1)
unnamed: J8.11, U4.23 (GPA2)
unnamed: J8.12, U4.24 (GPA3)
unnamed: J8.13, U4.25 (GPA4)
unnamed: J8.14, U4.26 (GPA5)
unnamed: J8.15, U4.27 (GPA6)
unnamed: J8.16, U4.28 (GPA7)
unnamed: J9.1, U5.1 (GPB0)
unnamed: J9.2, U5.2 (GPB1)
unnamed: J9.3, U5.3 (GPB2)
unnamed: J9.4, U5.4 (GPB3)
unnamed: J9.5, U5.5 (GPB4)
unnamed: J9.6, U5.6 (GPB5)
unnamed: J9.7, U5.7 (GPB6)
unnamed: J9.8, U5.8 (GPB7)
unnamed: J9.9, U5.21 (GPA0)
unnamed: J9.10, U5.22 (GPA1)
unnamed: J9.11, U5.23 (GPA2)
unnamed: J9.12, U5.24 (GPA3)
unnamed: J9.13, U5.25 (GPA4)
unnamed: J9.14, U5.26 (GPA5)
unnamed: J9.15, U5.27 (GPA6)
unnamed: J9.16, U5.28 (GPA7)
unnamed: J10.1, U6.1 (GPB0)
unnamed: J10.2, U6.2 (GPB1)
unnamed: J10.3, U6.3 (GPB2)
unnamed: J10.4, U6.4 (GPB3)
unnamed: J10.5, U6.5 (GPB4)
unnamed: J10.6, U6.6 (GPB5)
unnamed: J10.7, U6.7 (GPB6)
unnamed: J10.8, U6.8 (GPB7)
unnamed: J10.9, U6.21 (GPA0)
unnamed: J10.10, U6.22 (GPA1)
unnamed: J10.11, U6.23 (GPA2)
unnamed: J10.12, U6.24 (GPA3)
unnamed: J10.13, U6.25 (GPA4)
unnamed: J10.14, U6.26 (GPA5)
unnamed: J10.15, U6.27 (GPA6)
unnamed: J10.16, U6.28 (GPA7)
unnamed: J11.1, U7.1 (GPB0)
unnamed: J11.2, U7.2 (GPB1)
unnamed: J11.3, U7.3 (GPB2)
unnamed: J11.4, U7.4 (GPB3)
unnamed: J11.5, U7.5 (GPB4)
unnamed: J11.6, U7.6 (GPB5)
unnamed: J11.7, U7.7 (GPB6)
unnamed: J11.8, U7.8 (GPB7)
unnamed: J11.9, U7.21 (GPA0)
unnamed: J11.10, U7.22 (GPA1)
unnamed: J11.11, U7.23 (GPA2)
unnamed: J11.12, U7.24 (GPA3)
unnamed: J11.13, U7.25 (GPA4)
unnamed: J11.14, U7.26 (GPA5)
unnamed: J11.15, U7.27 (GPA6)
unnamed: J11.16, U7.28 (GPA7)
unnamed: J12.1, U8.1 (GPB0)
unnamed: J12.2, U8.2 (GPB1)
unnamed: J12.3, U8.3 (GPB2)
unnamed: J12.4, U8.4 (GPB3)
unnamed: J12.5, U8.5 (GPB4)
unnamed: J12.6, U8.6 (GPB5)
unnamed: J12.7, U8.7 (GPB6)
unnamed: J12.8, U8.8 (GPB7)
unnamed: J12.9, U8.21 (GPA0)
unnamed: J12.10, U8.22 (GPA1)
unnamed: J12.11, U8.23 (GPA2)
unnamed: J12.12, U8.24 (GPA3)
unnamed: J12.13, U8.25 (GPA4)
unnamed: J12.14, U8.26 (GPA5)
unnamed: J12.15, U8.27 (GPA6)
unnamed: J12.16, U8.28 (GPA7)
unnamed: J13.1, U9.1 (GPB0)
unnamed: J13.2, U9.2 (GPB1)
unnamed: J13.3, U9.3 (GPB2)
unnamed: J13.4, U9.4 (GPB3)
unnamed: J13.5, U9.5 (GPB4)
unnamed: J13.6, U9.6 (GPB5)
unnamed: J13.7, U9.7 (GPB6)
unnamed: J13.8, U9.8 (GPB7)
unnamed: J13.9, U9.21 (GPA0)
unnamed: J13.10, U9.22 (GPA1)
unnamed: J13.11, U9.23 (GPA2)
unnamed: J13.12, U9.24 (GPA3)
unnamed: J13.13, U9.25 (GPA4)
unnamed: J13.14, U9.26 (GPA5)
unnamed: J13.15, U9.27 (GPA6)
unnamed: J13.16, U9.28 (GPA7)
unnamed: J14.1, U10.1 (GPB0)
unnamed: J14.2, U10.2 (GPB1)
unnamed: J14.3, U10.3 (GPB2)
unnamed: J14.4, U10.4 (GPB3)
unnamed: J14.5, U10.5 (GPB4)
unnamed: J14.6, U10.6 (GPB5)
unnamed: J14.7, U10.7 (GPB6)
unnamed: J14.8, U10.8 (GPB7)
unnamed: J14.9, U10.21 (GPA0)
unnamed: J14.10, U10.22 (GPA1)
unnamed: J14.11, U10.23 (GPA2)
unnamed: J14.12, U10.24 (GPA3)
unnamed: J14.13, U10.25 (GPA4)
unnamed: J14.14, U10.26 (GPA5)
unnamed: J14.15, U10.27 (GPA6)
unnamed: J14.16, U10.28 (GPA7)
unnamed: JP4.2 (B), R13.1, U4.17 (A2)
unnamed: JP5.2 (B), R14.1, U4.16 (A1)
unnamed: JP6.2 (B), R15.1, U4.15 (A0)
unnamed: JP7.2 (B), R17.1, U5.17 (A2)
unnamed: JP8.2 (B), R18.1, U5.16 (A1)
unnamed: JP9.2 (B), R19.1, U5.15 (A0)
unnamed: JP10.2 (B), R21.1, U6.17 (A2)
unnamed: JP11.2 (B), R22.1, U6.16 (A1)
unnamed: JP12.2 (B), R23.1, U6.15 (A0)
unnamed: JP13.2 (B), R25.1, U7.17 (A2)
unnamed: JP14.2 (B), R26.1, U7.16 (A1)
unnamed: JP15.2 (B), R27.1, U7.15 (A0)
unnamed: JP16.2 (B), R29.1, U8.17 (A2)
unnamed: JP17.2 (B), R30.1, U8.16 (A1)
unnamed: JP18.2 (B), R31.1, U8.15 (A0)
unnamed: JP19.2 (B), R33.1, U9.17 (A2)
unnamed: JP20.2 (B), R34.1, U9.16 (A1)
unnamed: JP21.2 (B), R35.1, U9.15 (A0)
unnamed: JP22.2 (B), R37.1, U10.17 (A2)
unnamed: JP23.2 (B), R38.1, U10.16 (A1)
unnamed: JP24.2 (B), R39.1, U10.15 (A0)
unnamed: R12.2, U4.18 (~RESET)
unnamed: R16.2, U5.18 (~RESET)
unnamed: R20.2, U6.18 (~RESET)
unnamed: R24.2, U7.18 (~RESET)
unnamed: R28.2, U8.18 (~RESET)
unnamed: R32.2, U9.18 (~RESET)
unnamed: R36.2, U10.18 (~RESET)
SCL_IN: U4.12 (SCK), U5.12 (SCK), U6.12 (SCK), U7.12 (SCK), U8.12 (SCK), U9.12 (SCK), U10.12 (SCK); also elsewhere on the board
SDA_IN: U4.13 (SDA), U5.13 (SDA), U6.13 (SDA), U7.13 (SDA), U8.13 (SDA), U9.13 (SDA), U10.13 (SDA); also elsewhere on the board

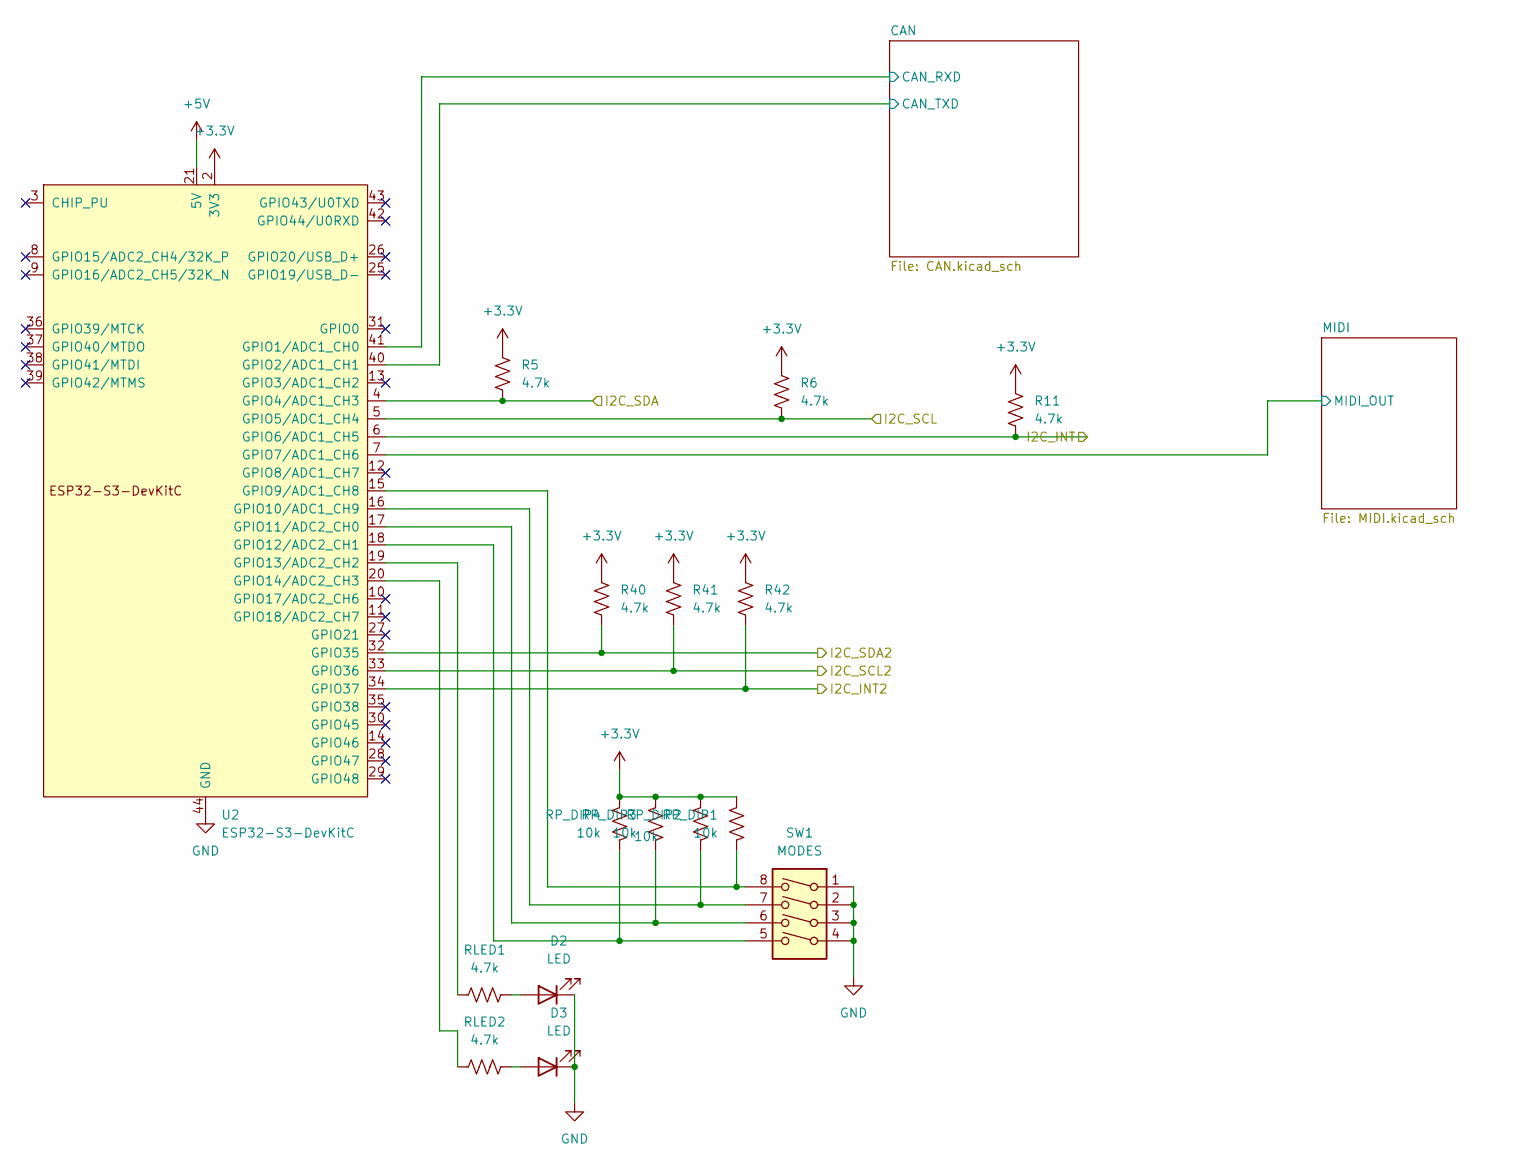
[picture p29: schematic Controller.kicad_sch]

Parts:
D2, D3: LED; LED_0603_1608Metric
R5, R6, R11, R40, R41, R42: 4.7k; R_0805_2012Metric
RLED1, RLED2: 4.7k; R_0805_2012Metric
RP_DIP1, RP_DIP2, RP_DIP3, RP_DIP4: 10k; R_0603_1608Metric
SW1: MODES; SW_DIP_SPSTx04_Slide_6.7x11.72mm_W7.62mm_P2.54mm_LowProfile
U2: ESP32-S3-DevKitC

Connections:
+3.3V: R5.1, R6.1, R11.1, R40.1, R41.1, R42.1, RP_DIP1.1, RP_DIP2.1, RP_DIP3.1, RP_DIP4.1, U2.1 (3V3), U2.2 (3V3); also elsewhere on the board
+5V: U2.21 (5V); also elsewhere on the board
/Controller/CAN/CAN_RXD: U2.41 (GPIO1/ADC1_CH0); also elsewhere on the board
/Controller/CAN/CAN_TXD: U2.40 (GPIO2/ADC1_CH1); also elsewhere on the board
/Controller/I2C_INT2: R42.2, U2.34 (GPIO37); also elsewhere on the board
/Controller/I2C_SCL2: R41.2, U2.33 (GPIO36); also elsewhere on the board
/Controller/I2C_SDA2: R40.2, U2.32 (GPIO35); also elsewhere on the board
/Controller/MIDI/MIDI_OUT: U2.7 (GPIO7/ADC1_CH6); also elsewhere on the board
GND: D2.1 (K), D3.1 (K), SW1.1, SW1.2, SW1.3, SW1.4, U2.22 (GND), U2.23 (GND), U2.24 (GND), U2.44 (GND); also elsewhere on the board
INT_INOUT: R11.2, U2.6 (GPIO6/ADC1_CH5); also elsewhere on the board
unnamed: D2.2 (A), RLED1.2
unnamed: D3.2 (A), RLED2.2
unnamed: RP_DIP1.2, SW1.8, U2.15 (GPIO9/ADC1_CH8)
unnamed: RP_DIP2.2, SW1.7, U2.16 (GPIO10/ADC1_CH9)
unnamed: RP_DIP3.2, SW1.6, U2.17 (GPIO11/ADC2_CH0)
unnamed: RP_DIP4.2, SW1.5, U2.18 (GPIO12/ADC2_CH1)
unnamed: RLED1.1, U2.19 (GPIO13/ADC2_CH2)
unnamed: RLED2.1, U2.20 (GPIO14/ADC2_CH3)
SCL_IN: R6.2, U2.5 (GPIO5/ADC1_CH4); also elsewhere on the board
SDA_IN: R5.2, U2.4 (GPIO4/ADC1_CH3); also elsewhere on the board

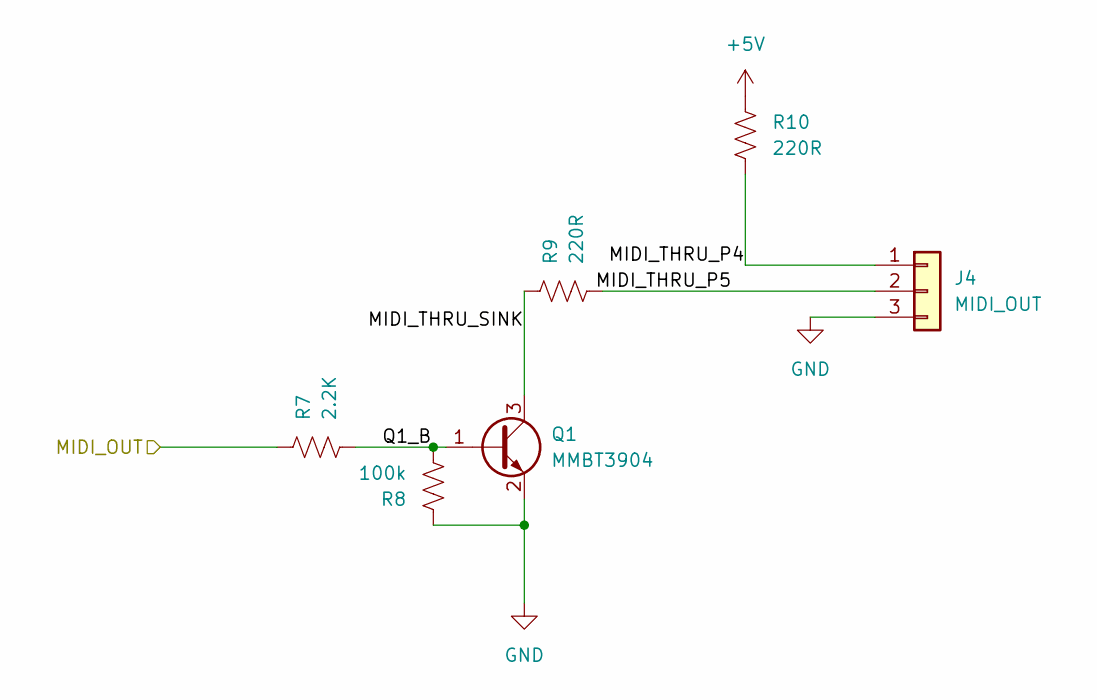
[picture p30: schematic MIDI.kicad_sch]

Parts:
J4: MIDI_OUT; JST_PH_B3B-PH-K_1x03_P2.00mm_Vertical
Q1: MMBT3904; SOT-23
R7: 2.2K; R_0603_1608Metric
R8: 100k; R_0603_1608Metric
R9, R10: 220R; R_0603_1608Metric

Connections:
+5V: R10.1; also elsewhere on the board
/Controller/MIDI/MIDI_OUT: R7.1; also elsewhere on the board
/Controller/MIDI/MIDI_THRU_P4: J4.1, R10.2
/Controller/MIDI/MIDI_THRU_P5: J4.2, R9.2
/Controller/MIDI/MIDI_THRU_SINK: Q1.3 (C), R9.1
/Controller/MIDI/Q1_B: Q1.1 (B), R7.2, R8.2
GND: J4.3, Q1.2 (E), R8.1; also elsewhere on the board

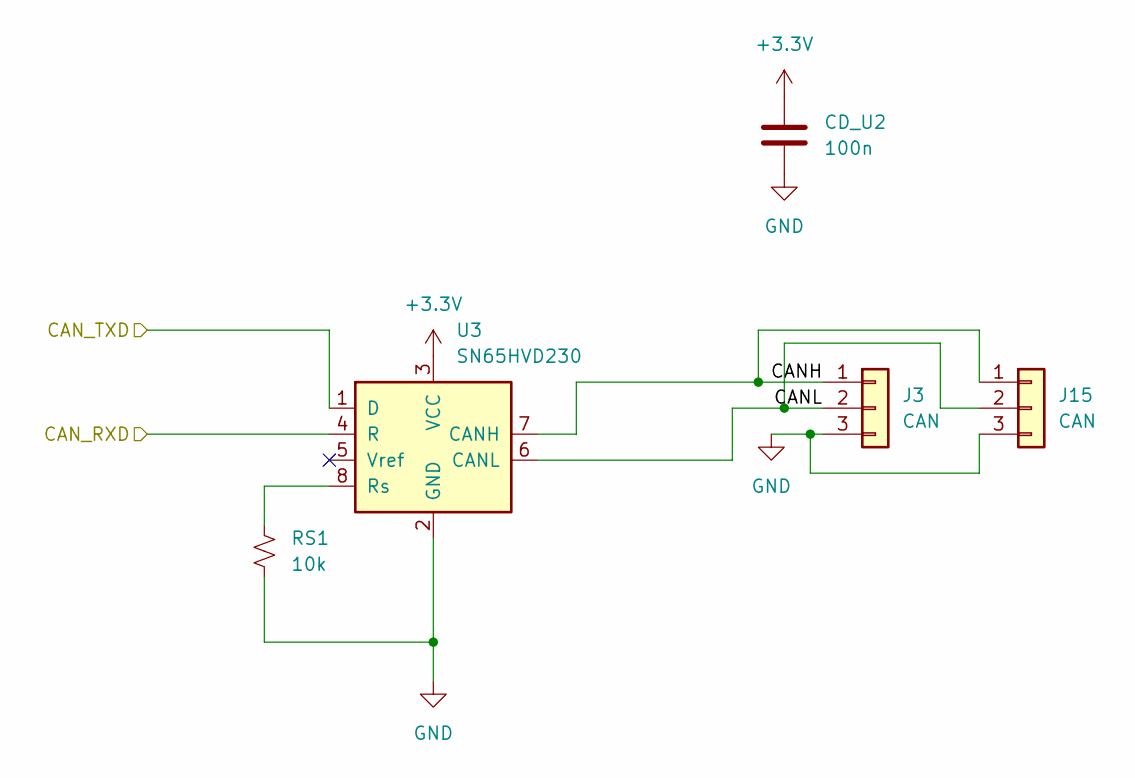
[picture p31: schematic CAN.kicad_sch]

Parts:
CD_U2: 100n; C_0603_1608Metric
J3, J15: CAN; JST_PH_B3B-PH-K_1x03_P2.00mm_Vertical
RS1: 10k; R_0603_1608Metric
U3: SN65HVD230; SOIC-8_3.9x4.9mm_P1.27mm

Connections:
+3.3V: CD_U2.1, U3.3 (VCC); also elsewhere on the board
/Controller/CAN/CANH: J3.1, J15.1, U3.7 (CANH)
/Controller/CAN/CANL: J3.2, J15.2, U3.6 (CANL)
/Controller/CAN/CAN_RXD: U3.4 (R); also elsewhere on the board
/Controller/CAN/CAN_TXD: U3.1 (D); also elsewhere on the board
GND: CD_U2.2, J3.3, J15.3, RS1.2, U3.2 (GND); also elsewhere on the board
unnamed: RS1.1, U3.8 (Rs)

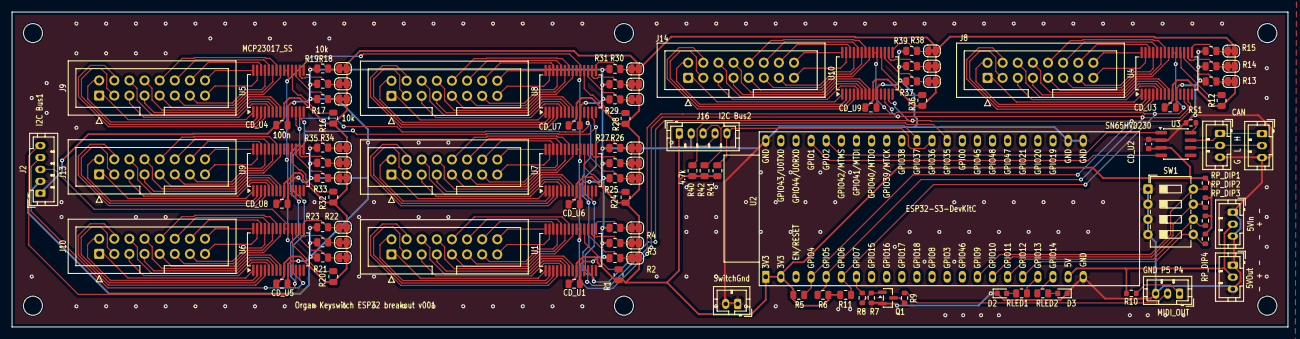
[picture p32: board OrganKeyswitchBreakout.kicad_pcb from above]

Board: 2 copper layers, 214.4 x 52.9 mm, 118 parts (0 on the bottom side), 187 nets.
