dkhorn/organ/kicad/OrganUniversalMCUboard/OrganUniversalMCUboard.kicad_pcb

## KiCad design kicad/OrganUniversalMCUboard/OrganUniversalMCUboard.kicad_pcb (2026-02-11)

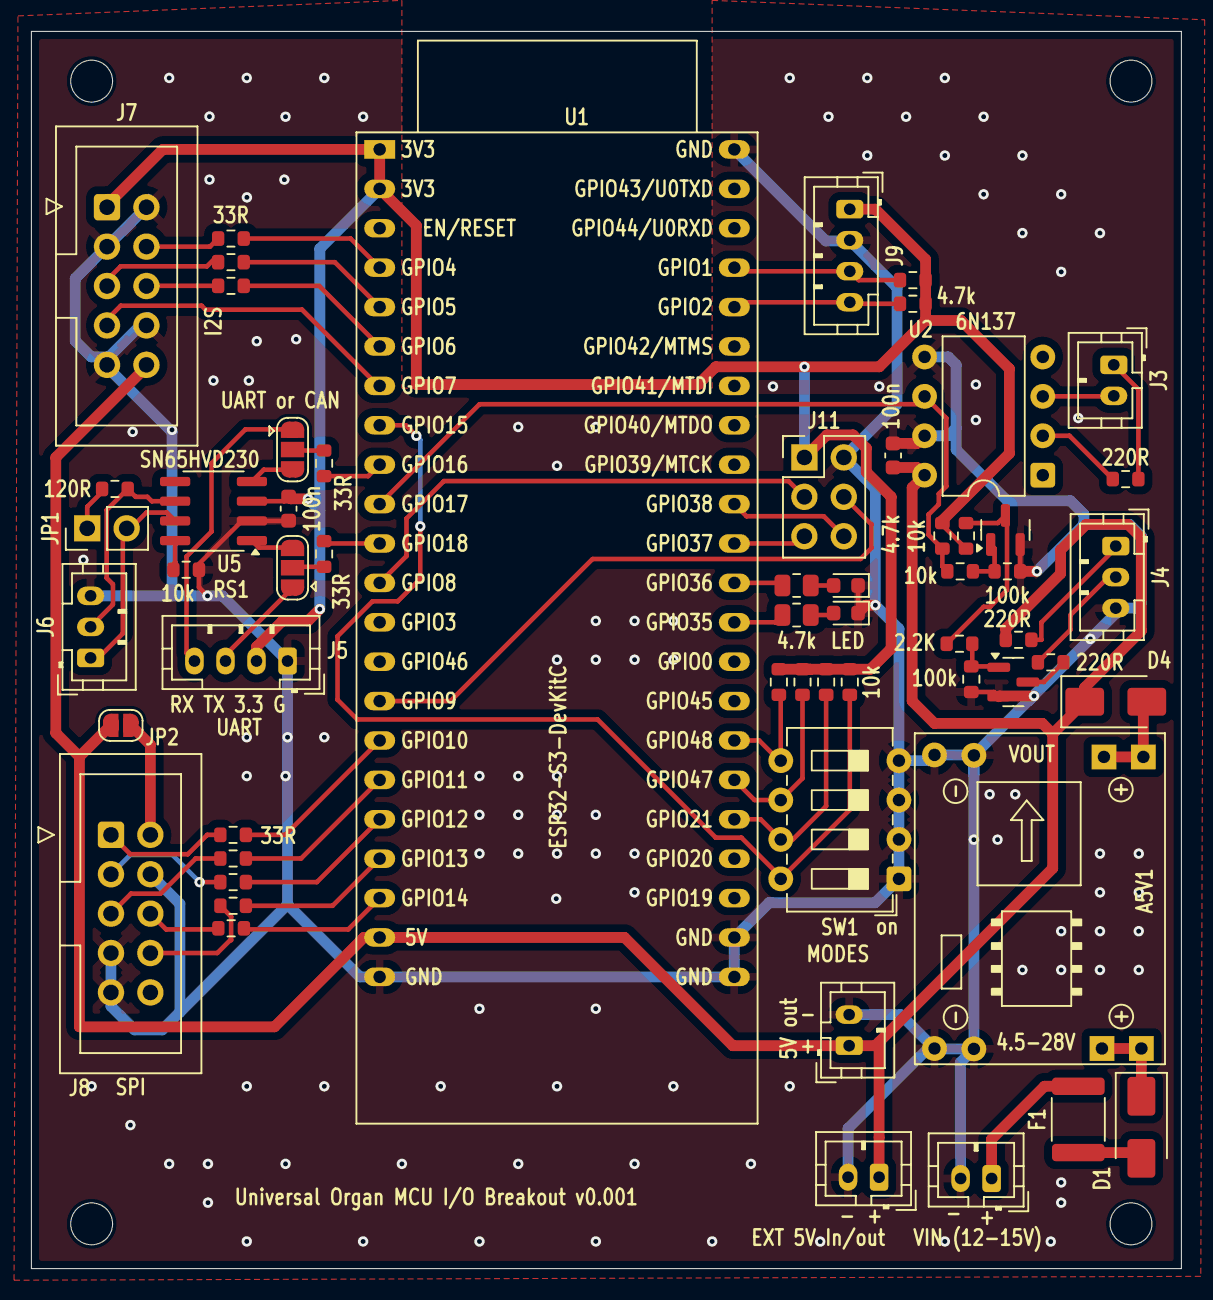
[picture p33: board OrganUniversalMCUboard.kicad_pcb from above]

Board: 2 copper layers, 74.1 x 79.8 mm, 58 parts (0 on the bottom side), 61 nets.

Parts:
A5V1: 4.7; MP1584EN_Module
CD_U2, CD_U5: 100n; C_0603_1608Metric
D1: SS34; D_SMA
D2, D3: LED; LED_0603_1608Metric
D4: SS14; D_SMA
F1: MF-MSMF050; Fuse_1812_4532Metric
J1: VIN (12-15V); JST_PH_B2B-PH-K_1x02_P2.00mm_Vertical
J2: EXT 5V In/out; JST_PH_B2B-PH-K_1x02_P2.00mm_Vertical
J3: MIDI IN; JST_PH_B2B-PH-K_1x02_P2.00mm_Vertical
J4: MIDI_THRU; JST_PH_B3B-PH-K_1x03_P2.00mm_Vertical
J5: UART; JST_PH_B4B-PH-K_1x04_P2.00mm_Vertical
J6: CAN; JST_PH_B3B-PH-K_1x03_P2.00mm_Vertical
J7: I2S; IDC-Header_2x05_P2.54mm_Vertical
J8: SPI; IDC-Header_2x05_P2.54mm_Vertical
J9: I2C; JST_PH_B4B-PH-K_1x04_P2.00mm_Vertical
J10: 5V out; JST_PH_B2B-PH-K_1x02_P2.00mm_Vertical
J11: GPIO; PinHeader_2x03_P2.54mm_Vertical
JP1: CAN Terminator; PinHeader_1x02_P2.54mm_Vertical
JP2: SolderJumper_2_Open; SolderJumper-2_P1.3mm_Open_RoundedPad1.0x1.5mm
Q1, Q2: MMBT3904; SOT-23
R1, R8: 10k; R_0603_1608Metric
R2, R5, R7: 220R; R_0603_1608Metric
R3: 2.2K; R_0603_1608Metric
R4, R9: 100k; R_0603_1608Metric
R6: 4.7k; R_0603_1608Metric
RLED1, RLED2: 4.7k; R_0805_2012Metric
RP_DIP1, RP_DIP2, RP_DIP3, RP_DIP4: 10k; R_0603_1608Metric
RP_SCL1: 4.7k; R_0603_1608Metric
RP_SDA1: 4.7k; R_0603_1608Metric
RS1: 10k; R_0603_1608Metric
RS_BCLK1: 33R; R_0603_1608Metric
RS_CLR1: 33R; R_0603_1608Metric
RS_DIN1: 33R; R_0603_1608Metric
RS_LATCH1: 33R; R_0603_1608Metric
RS_LRCLK1: 33R; R_0603_1608Metric
RS_MOSI1: 33R; R_0603_1608Metric
RS_OE_N1: 33R; R_0603_1608Metric
RS_SCK1: 33R; R_0603_1608Metric
RS_UART_RX1: 33R; R_0603_1608Metric
RS_UART_TX1: 33R; R_0603_1608Metric
R_TERM1: 120R; R_0603_1608Metric
SJ_COMM_RX1: UART or CAN; SolderJumper-3_P1.3mm_Open_RoundedPad1.0x1.5mm
SJ_COMM_TX1: UART or CAN; SolderJumper-3_P1.3mm_Open_RoundedPad1.0x1.5mm
SW1: MODES; SW_DIP_SPSTx04_Slide_6.7x11.72mm_W7.62mm_P2.54mm_LowProfile
U1: ESP32-S3-DevKitC
U2: 6N137; DIP-8_W7.62mm
U5: SN65HVD230; SOIC-8_3.9x4.9mm_P1.27mm

Connections:
+3.3V: CD_U5.1, J5.2, J7.1, J9.1, J11.1, R6.1, R8.1, RP_DIP1.1, RP_DIP2.1, RP_DIP3.1, RP_DIP4.1, RP_SCL1.1, RP_SDA1.1, U1.1 (3V3), U1.2 (3V3), U5.3 (VCC)
/BoardToBoardComms/CANH: J6.1, JP1.2 (B), U5.7 (CANH)
/BoardToBoardComms/CANL: J6.2, R_TERM1.2, U5.6 (CANL)
/BoardToBoardComms/CAN_RXD: SJ_COMM_RX1.3 (B), U5.4 (R)
/BoardToBoardComms/CAN_TXD: SJ_COMM_TX1.3 (B), U5.1 (D)
/BoardToBoardComms/UART_RX_HDR: J5.4, SJ_COMM_RX1.1 (A)
/BoardToBoardComms/UART_TX_HDR: J5.3, SJ_COMM_TX1.1 (A)
/COMM_RX: RS_UART_RX1.1, U1.9 (GPIO16/ADC2_CH5/32K_N)
/COMM_TX: RS_UART_TX1.1, U1.11 (GPIO18/ADC2_CH7)
/DIP1: RP_DIP1.2, SW1.8, U1.8 (GPIO15/ADC2_CH4/32K_P)
/DIP2: RP_DIP2.2, SW1.7, U1.27 (GPIO21)
/DIP3: RP_DIP3.2, SW1.6, U1.28 (GPIO47)
/DIP4: RP_DIP4.2, SW1.5, U1.29 (GPIO48)
/GPIO8: J11.3, U1.12 (GPIO8/ADC1_CH7)
/GPIO9: J11.4, U1.15 (GPIO9/ADC1_CH8)
/GPIO37: J11.5, U1.34 (GPIO37)
/GPIO38: J11.6, U1.35 (GPIO38)
/I2C_SCL: J9.4, RP_SCL1.2, U1.40 (GPIO2/ADC1_CH1)
/I2C_SDA: J9.3, RP_SDA1.2, U1.41 (GPIO1/ADC1_CH0)
/I2S_BLCK: RS_BCLK1.2, U1.4 (GPIO4/ADC1_CH3)
/I2S_DIN: RS_DIN1.2, U1.6 (GPIO6/ADC1_CH5)
/I2S_LRCLK: RS_LRCLK1.2, U1.5 (GPIO5/ADC1_CH4)
/I2S_MCLK: J7.7, U1.7 (GPIO7/ADC1_CH6)
/LED1: RLED1.1, U1.32 (GPIO35)
/LED2: RLED2.1, U1.33 (GPIO36)
/MIDI/MIDI_IN_P4: J3.1, R5.1
/MIDI/MIDI_IN_P5: J3.2, U2.3 (C)
/MIDI/MIDI_THRU_DRV: Q2.3 (C), R3.1, R8.2
/MIDI/MIDI_THRU_P4: J4.1, R7.2
/MIDI/MIDI_THRU_P5: J4.2, R2.2
/MIDI/MIDI_THRU_SINK: Q1.3 (C), R2.1
/MIDI/Q1_B: Q1.1 (B), R3.2, R4.2
/MIDI_GPIO: R1.1, R6.2, U1.10 (GPIO17/ADC2_CH6), U2.6 (VO)
/Power/BUCK_5V: A5V1.3 (OUT+), D4.2 (A)
/Power/VIN_12V: F1.2, J1.1
/Power/VIN_FUSED: D1.2 (A), F1.1
/Power/VIN_PROT: A5V1.1 (IN+), D1.1 (K)
/SPI_CLR: RS_CLR1.2, U1.16 (GPIO10/ADC1_CH9)
/SPI_LATCH: RS_LATCH1.2, U1.20 (GPIO14/ADC2_CH3)
/SPI_MOSI: RS_MOSI1.2, U1.19 (GPIO13/ADC2_CH2)
/SPI_OE_N: RS_OE_N1.2, U1.17 (GPIO11/ADC2_CH0)
/SPI_SCK: RS_SCK1.2, U1.18 (GPIO12/ADC2_CH1)
GND: A5V1.2 (IN-), A5V1.4 (OUT-), CD_U2.2, CD_U5.2, D2.1 (K), D3.1 (K), J1.2, J2.2, J4.3, J5.1, J6.3, J7.2, J7.3, J7.8, J7.9, J8.4, J8.7, J8.9, J9.2, J10.2, J11.2, Q1.2 (E), Q2.2 (E), R4.1, R9.1, RS1.2, SW1.1, SW1.2, SW1.3, SW1.4, U1.22 (GND), U1.23 (GND), U1.24 (GND), U1.44 (GND), U2.5 (GND), U2.7 (EN), U5.2 (GND)
unnamed: D2.2 (A), RLED1.2
unnamed: D3.2 (A), RLED2.2
unnamed: J7.4, RS_BCLK1.1
unnamed: J7.5, RS_LRCLK1.1
unnamed: J7.6, RS_DIN1.1
unnamed: J8.1, RS_CLR1.1
unnamed: J8.2, JP2.1 (A)
unnamed: J8.3, RS_SCK1.1
unnamed: J8.5, RS_OE_N1.1
unnamed: J8.6, RS_LATCH1.1
unnamed: J8.8, RS_MOSI1.1
unnamed: JP1.1 (A), R_TERM1.1
unnamed: Q2.1 (B), R1.2, R9.2
unnamed: RS_UART_RX1.2, SJ_COMM_RX1.2 (C)
unnamed: RS_UART_TX1.2, SJ_COMM_TX1.2 (C)
unnamed: R5.2, U2.2 (A)
unnamed: RS1.1, U5.8 (Rs)
SYS_5V: CD_U2.1, D4.1 (K), J2.1, J7.10, J10.1, JP2.2 (B), R7.1, U1.21 (5V), U2.8 (VCC)
