dkhorn/organ/kicad/OrganUnifiedSoundboard/OrganUnifiedSoundboard.kicad_pcb

## KiCad design kicad/OrganUnifiedSoundboard/OrganUnifiedSoundboard.kicad_pcb (2026-02-11)

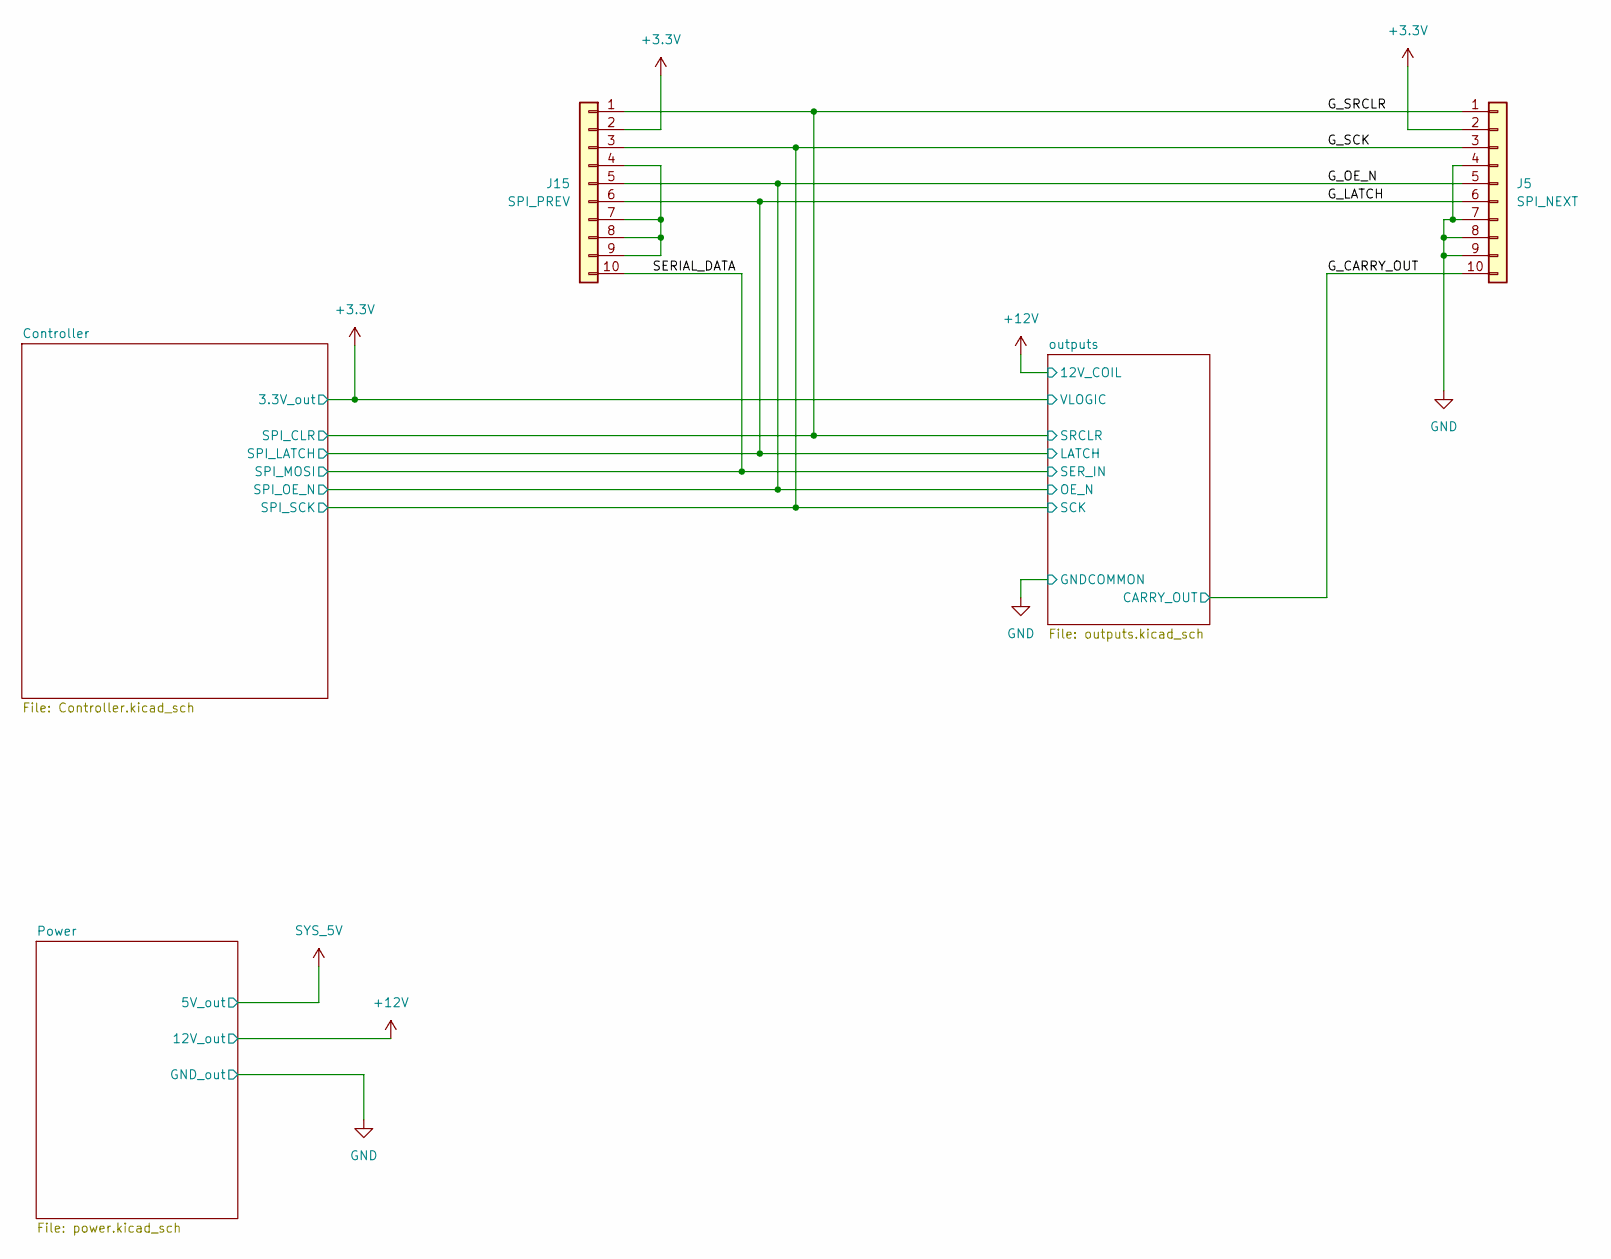
[picture p34: schematic OrganUnifiedSoundboard.kicad_sch]

Parts:
J5: SPI_NEXT; IDC-Header_2x05_P2.54mm_Vertical
J15: SPI_PREV; IDC-Header_2x05_P2.54mm_Vertical

Connections:
+3.3V: J5.2, J15.2; also elsewhere on the board
/G_CARRY_OUT: J5.10; also elsewhere on the board
/G_LATCH: J5.6, J15.6; also elsewhere on the board
/G_OE_N: J5.5, J15.5; also elsewhere on the board
/G_SCK: J5.3, J15.3; also elsewhere on the board
/G_SRCLR: J5.1, J15.1; also elsewhere on the board
/SERIAL_DATA: J15.10; also elsewhere on the board
GND: J5.4, J5.7, J5.8, J5.9; also elsewhere on the board
unnamed: J15.4, J15.7, J15.8, J15.9

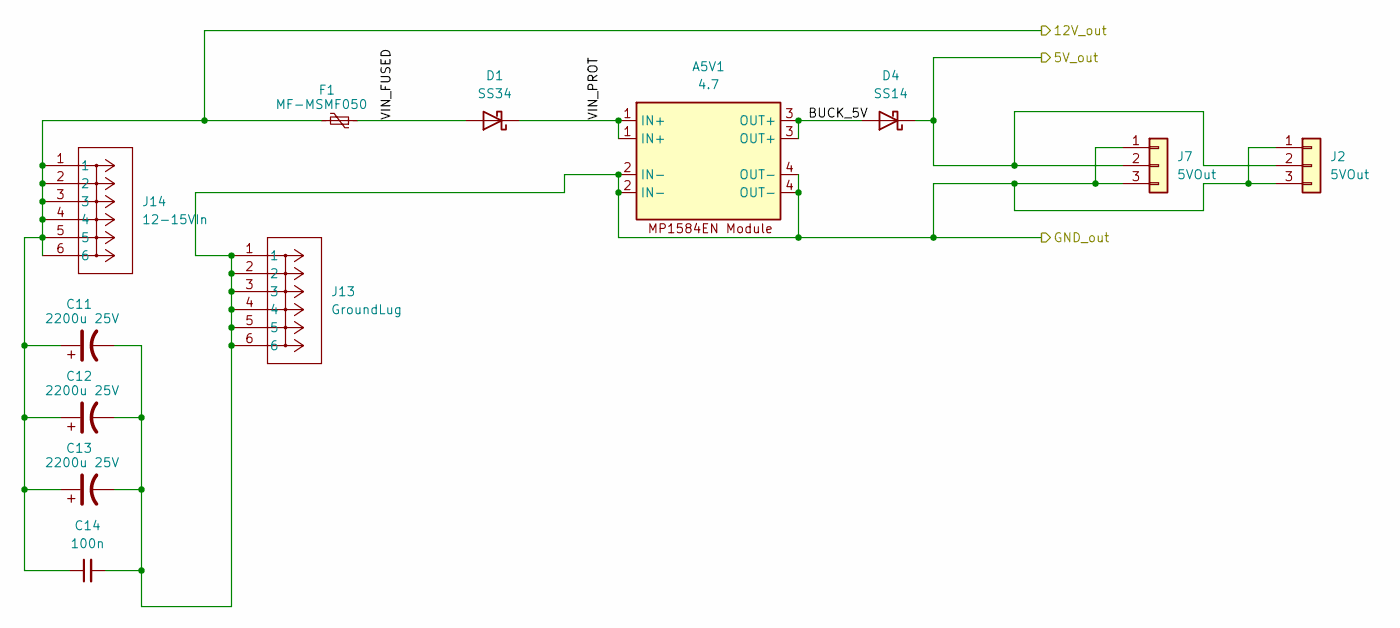
[picture p35: schematic power.kicad_sch]

Parts:
A5V1: 4.7; MP1584EN_Module
C11, C12, C13: 2200u 25V; CP_Radial_D10.0mm_P5.00mm
C14: 100n; C_0603_1608Metric
D1: SS34; D_SMA
D4: SS14; D_SMA
F1: MF-MSMF050; Fuse_1812_4532Metric
J2, J7: 5VOut; JST_PH_B3B-PH-K_1x03_P2.00mm_Vertical
J13: GroundLug; CONN_8199_KEY
J14: 12-15VIn; CONN_8199_KEY

Connections:
+12V: C11.1, C12.1, C13.1, C14.1, F1.2, J14.1, J14.2, J14.3, J14.4, J14.5, J14.6; also elsewhere on the board
/Power/BUCK_5V: A5V1.3 (OUT+), D4.2 (A)
/Power/VIN_FUSED: D1.2 (A), F1.1
/Power/VIN_PROT: A5V1.1 (IN+), D1.1 (K)
GND: A5V1.2 (IN-), A5V1.4 (OUT-), C11.2, C12.2, C13.2, C14.2, J2.1, J2.3, J7.1, J7.3, J13.1, J13.2, J13.3, J13.4, J13.5, J13.6; also elsewhere on the board
SYS_5V: D4.1 (K), J2.2, J7.2; also elsewhere on the board
