dkhorn/organ/kicad/OrganUnifiedSoundboard/OrganUnifiedSoundboard.kicad_pcb

## KiCad design kicad/OrganUnifiedSoundboard/OrganUnifiedSoundboard.kicad_pcb (continued)

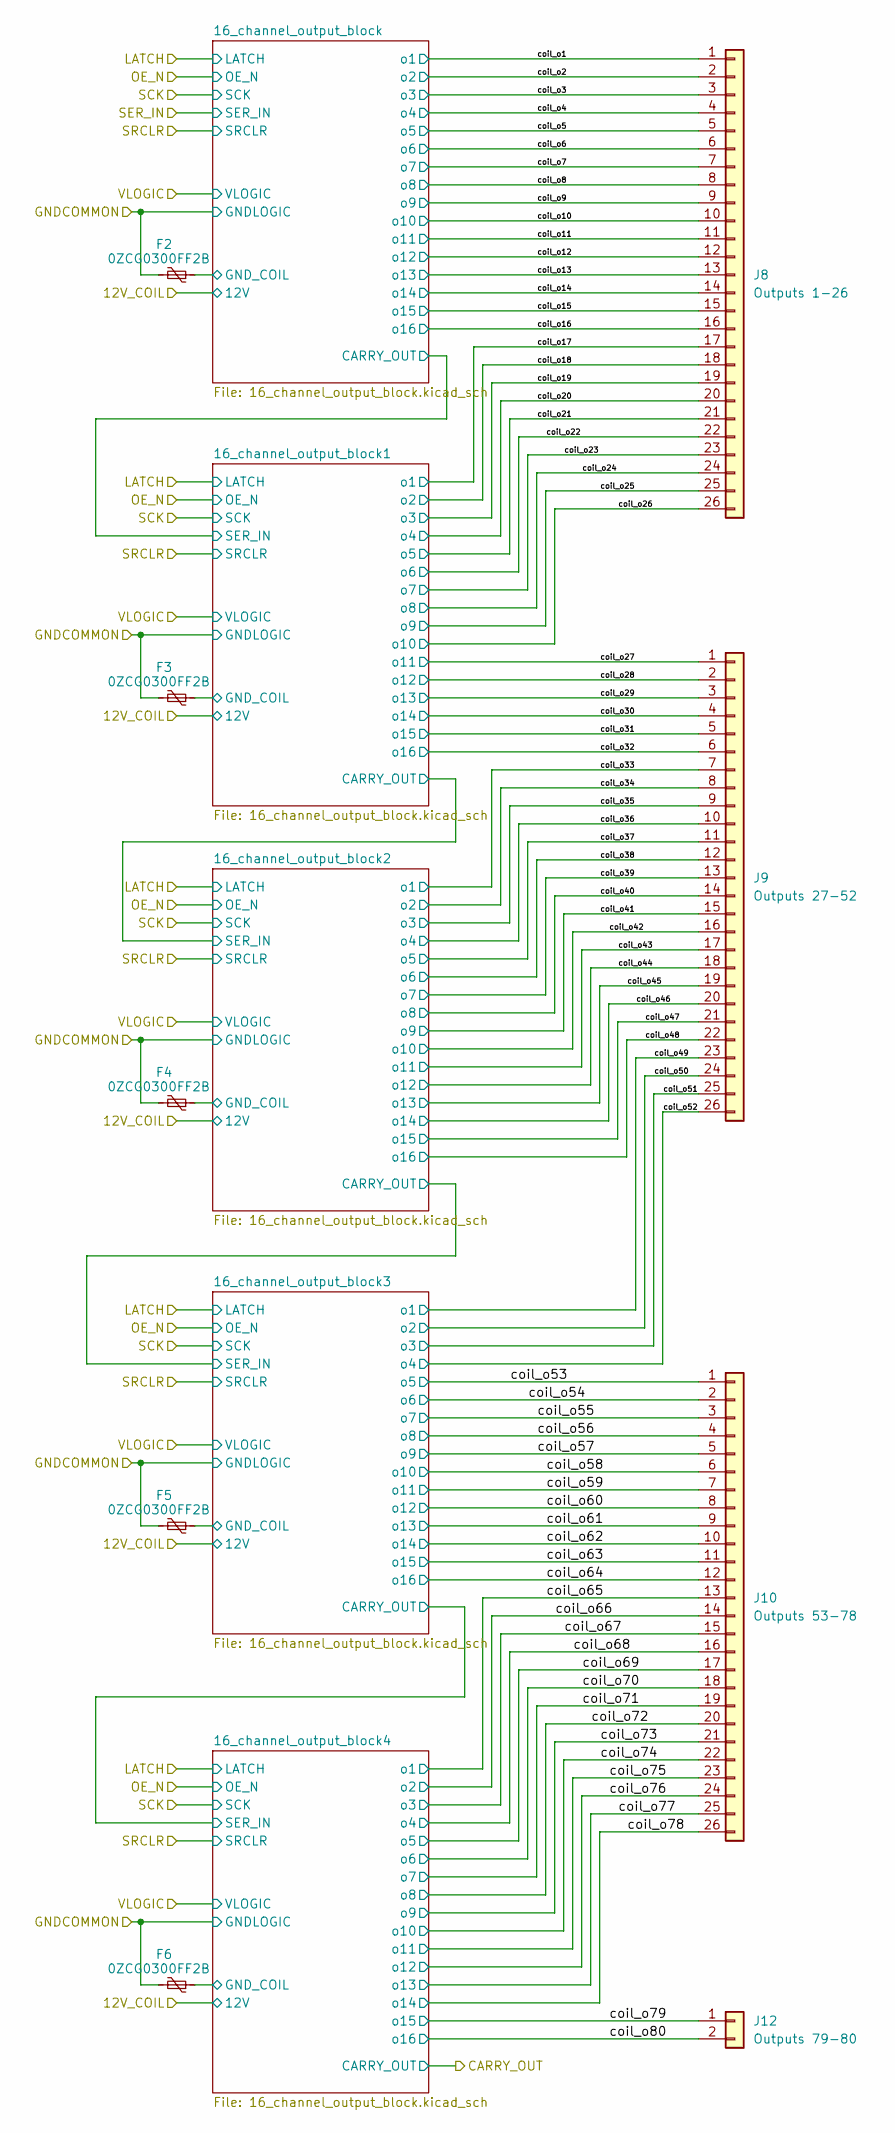
[picture p36: schematic outputs.kicad_sch]

Parts:
F2, F3, F4, F5, F6: 0ZCG0300FF2B; Fuse_1812_4532Metric
J8: Outputs 1-26; IDC-Header_2x13_P2.54mm_Vertical
J9: Outputs 27-52; IDC-Header_2x13_P2.54mm_Vertical
J10: Outputs 53-78; IDC-Header_2x13_P2.54mm_Vertical
J12: Outputs 79-80; JST_PH_B2B-PH-K_1x02_P2.00mm_Vertical

Connections:
/outputs/16_channel_output_block1/GND_COIL: F3.1; also elsewhere on the board
/outputs/16_channel_output_block2/GND_COIL: F4.1; also elsewhere on the board
/outputs/16_channel_output_block3/GND_COIL: F5.1; also elsewhere on the board
/outputs/16_channel_output_block4/GND_COIL: F6.1; also elsewhere on the board
/outputs/16_channel_output_block/GND_COIL: F2.1; also elsewhere on the board
/outputs/coil_o1: J8.1; also elsewhere on the board
/outputs/coil_o2: J8.2; also elsewhere on the board
/outputs/coil_o3: J8.3; also elsewhere on the board
/outputs/coil_o4: J8.4; also elsewhere on the board
/outputs/coil_o5: J8.5; also elsewhere on the board
/outputs/coil_o6: J8.6; also elsewhere on the board
/outputs/coil_o7: J8.7; also elsewhere on the board
/outputs/coil_o8: J8.8; also elsewhere on the board
/outputs/coil_o9: J8.9; also elsewhere on the board
/outputs/coil_o10: J8.10; also elsewhere on the board
/outputs/coil_o11: J8.11; also elsewhere on the board
/outputs/coil_o12: J8.12; also elsewhere on the board
/outputs/coil_o13: J8.13; also elsewhere on the board
/outputs/coil_o14: J8.14; also elsewhere on the board
/outputs/coil_o15: J8.15; also elsewhere on the board
/outputs/coil_o16: J8.16; also elsewhere on the board
/outputs/coil_o17: J8.17; also elsewhere on the board
/outputs/coil_o18: J8.18; also elsewhere on the board
/outputs/coil_o19: J8.19; also elsewhere on the board
/outputs/coil_o20: J8.20; also elsewhere on the board
/outputs/coil_o21: J8.21; also elsewhere on the board
/outputs/coil_o22: J8.22; also elsewhere on the board
/outputs/coil_o23: J8.23; also elsewhere on the board
/outputs/coil_o24: J8.24; also elsewhere on the board
/outputs/coil_o25: J8.25; also elsewhere on the board
/outputs/coil_o26: J8.26; also elsewhere on the board
/outputs/coil_o27: J9.1; also elsewhere on the board
/outputs/coil_o28: J9.2; also elsewhere on the board
/outputs/coil_o29: J9.3; also elsewhere on the board
/outputs/coil_o30: J9.4; also elsewhere on the board
/outputs/coil_o31: J9.5; also elsewhere on the board
/outputs/coil_o32: J9.6; also elsewhere on the board
/outputs/coil_o33: J9.7; also elsewhere on the board
/outputs/coil_o34: J9.8; also elsewhere on the board
/outputs/coil_o35: J9.9; also elsewhere on the board
/outputs/coil_o36: J9.10; also elsewhere on the board
/outputs/coil_o37: J9.11; also elsewhere on the board
/outputs/coil_o38: J9.12; also elsewhere on the board
/outputs/coil_o39: J9.13; also elsewhere on the board
/outputs/coil_o40: J9.14; also elsewhere on the board
/outputs/coil_o41: J9.15; also elsewhere on the board
/outputs/coil_o42: J9.16; also elsewhere on the board
/outputs/coil_o43: J9.17; also elsewhere on the board
/outputs/coil_o44: J9.18; also elsewhere on the board
/outputs/coil_o45: J9.19; also elsewhere on the board
/outputs/coil_o46: J9.20; also elsewhere on the board
/outputs/coil_o47: J9.21; also elsewhere on the board
/outputs/coil_o48: J9.22; also elsewhere on the board
/outputs/coil_o49: J9.23; also elsewhere on the board
/outputs/coil_o50: J9.24; also elsewhere on the board
/outputs/coil_o51: J9.25; also elsewhere on the board
/outputs/coil_o52: J9.26; also elsewhere on the board
/outputs/coil_o53: J10.1; also elsewhere on the board
/outputs/coil_o54: J10.2; also elsewhere on the board
/outputs/coil_o55: J10.3; also elsewhere on the board
/outputs/coil_o56: J10.4; also elsewhere on the board
/outputs/coil_o57: J10.5; also elsewhere on the board
/outputs/coil_o58: J10.6; also elsewhere on the board
/outputs/coil_o59: J10.7; also elsewhere on the board
/outputs/coil_o60: J10.8; also elsewhere on the board
/outputs/coil_o61: J10.9; also elsewhere on the board
/outputs/coil_o62: J10.10; also elsewhere on the board
/outputs/coil_o63: J10.11; also elsewhere on the board
/outputs/coil_o64: J10.12; also elsewhere on the board
/outputs/coil_o65: J10.13; also elsewhere on the board
/outputs/coil_o66: J10.14; also elsewhere on the board
/outputs/coil_o67: J10.15; also elsewhere on the board
/outputs/coil_o68: J10.16; also elsewhere on the board
/outputs/coil_o69: J10.17; also elsewhere on the board
/outputs/coil_o70: J10.18; also elsewhere on the board
/outputs/coil_o71: J10.19; also elsewhere on the board
/outputs/coil_o72: J10.20; also elsewhere on the board
/outputs/coil_o73: J10.21; also elsewhere on the board
/outputs/coil_o74: J10.22; also elsewhere on the board
/outputs/coil_o75: J10.23; also elsewhere on the board
/outputs/coil_o76: J10.24; also elsewhere on the board
/outputs/coil_o77: J10.25; also elsewhere on the board
/outputs/coil_o78: J10.26; also elsewhere on the board
/outputs/coil_o79: J12.1; also elsewhere on the board
/outputs/coil_o80: J12.2; also elsewhere on the board
GND: F2.2, F3.2, F4.2, F5.2, F6.2; also elsewhere on the board

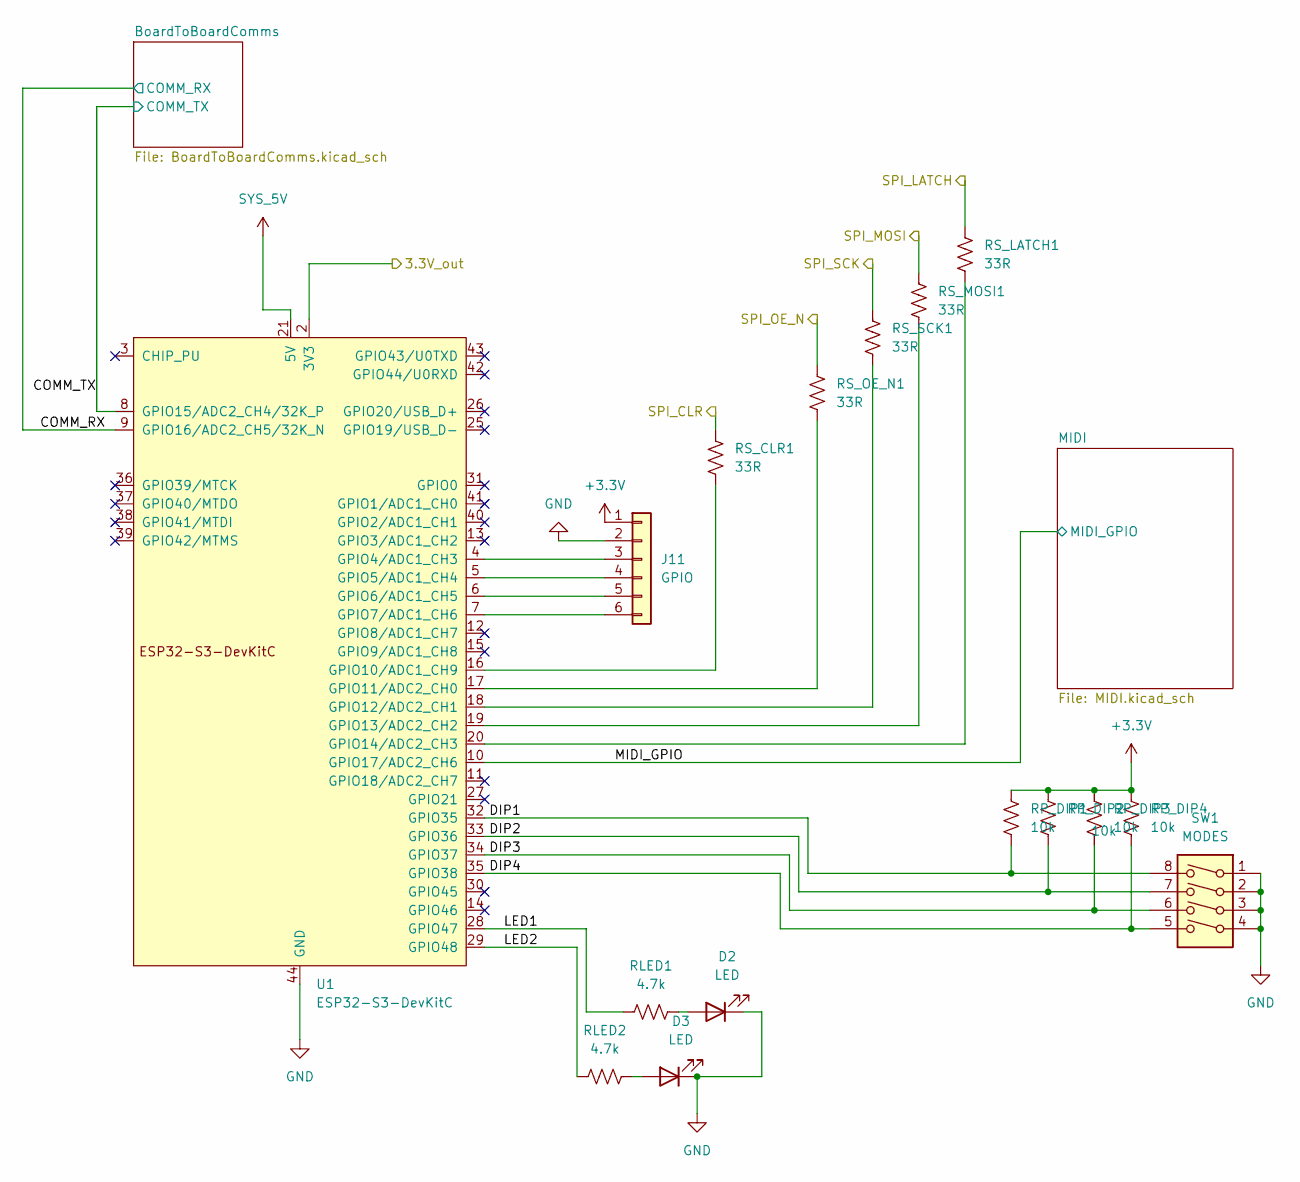
[picture p37: schematic Controller.kicad_sch]

Parts:
D2, D3: LED; LED_0603_1608Metric
J11: GPIO; PinHeader_2x03_P2.54mm_Vertical
RLED1, RLED2: 4.7k; R_0805_2012Metric
RP_DIP1, RP_DIP2, RP_DIP3, RP_DIP4: 10k; R_0603_1608Metric
RS_CLR1: 33R; R_0603_1608Metric
RS_LATCH1: 33R; R_0603_1608Metric
RS_MOSI1: 33R; R_0603_1608Metric
RS_OE_N1: 33R; R_0603_1608Metric
RS_SCK1: 33R; R_0603_1608Metric
SW1: MODES; SW_DIP_SPSTx04_Slide_6.7x11.72mm_W7.62mm_P2.54mm_LowProfile
U1: ESP32-S3-DevKitC

Connections:
+3.3V: J11.1, RP_DIP1.1, RP_DIP2.1, RP_DIP3.1, RP_DIP4.1, U1.1 (3V3), U1.2 (3V3); also elsewhere on the board
/Controller/COMM_RX: U1.9 (GPIO16/ADC2_CH5/32K_N); also elsewhere on the board
/Controller/COMM_TX: U1.8 (GPIO15/ADC2_CH4/32K_P); also elsewhere on the board
/Controller/DIP1: RP_DIP1.2, SW1.8, U1.32 (GPIO35)
/Controller/DIP2: RP_DIP2.2, SW1.7, U1.33 (GPIO36)
/Controller/DIP3: RP_DIP3.2, SW1.6, U1.34 (GPIO37)
/Controller/DIP4: RP_DIP4.2, SW1.5, U1.35 (GPIO38)
/Controller/LED1: RLED1.1, U1.28 (GPIO47)
/Controller/LED2: RLED2.1, U1.29 (GPIO48)
/Controller/MIDI_GPIO: U1.10 (GPIO17/ADC2_CH6); also elsewhere on the board
/G_LATCH: RS_LATCH1.1; also elsewhere on the board
/G_OE_N: RS_OE_N1.1; also elsewhere on the board
/G_SCK: RS_SCK1.1; also elsewhere on the board
/G_SRCLR: RS_CLR1.1; also elsewhere on the board
/SERIAL_DATA: RS_MOSI1.1; also elsewhere on the board
GND: D2.1 (K), D3.1 (K), J11.2, SW1.1, SW1.2, SW1.3, SW1.4, U1.22 (GND), U1.23 (GND), U1.24 (GND), U1.44 (GND); also elsewhere on the board
unnamed: D2.2 (A), RLED1.2
unnamed: D3.2 (A), RLED2.2
unnamed: J11.3, U1.4 (GPIO4/ADC1_CH3)
unnamed: J11.4, U1.5 (GPIO5/ADC1_CH4)
unnamed: J11.5, U1.6 (GPIO6/ADC1_CH5)
unnamed: J11.6, U1.7 (GPIO7/ADC1_CH6)
unnamed: RS_CLR1.2, U1.16 (GPIO10/ADC1_CH9)
unnamed: RS_OE_N1.2, U1.17 (GPIO11/ADC2_CH0)
unnamed: RS_SCK1.2, U1.18 (GPIO12/ADC2_CH1)
unnamed: RS_MOSI1.2, U1.19 (GPIO13/ADC2_CH2)
unnamed: RS_LATCH1.2, U1.20 (GPIO14/ADC2_CH3)
SYS_5V: U1.21 (5V); also elsewhere on the board

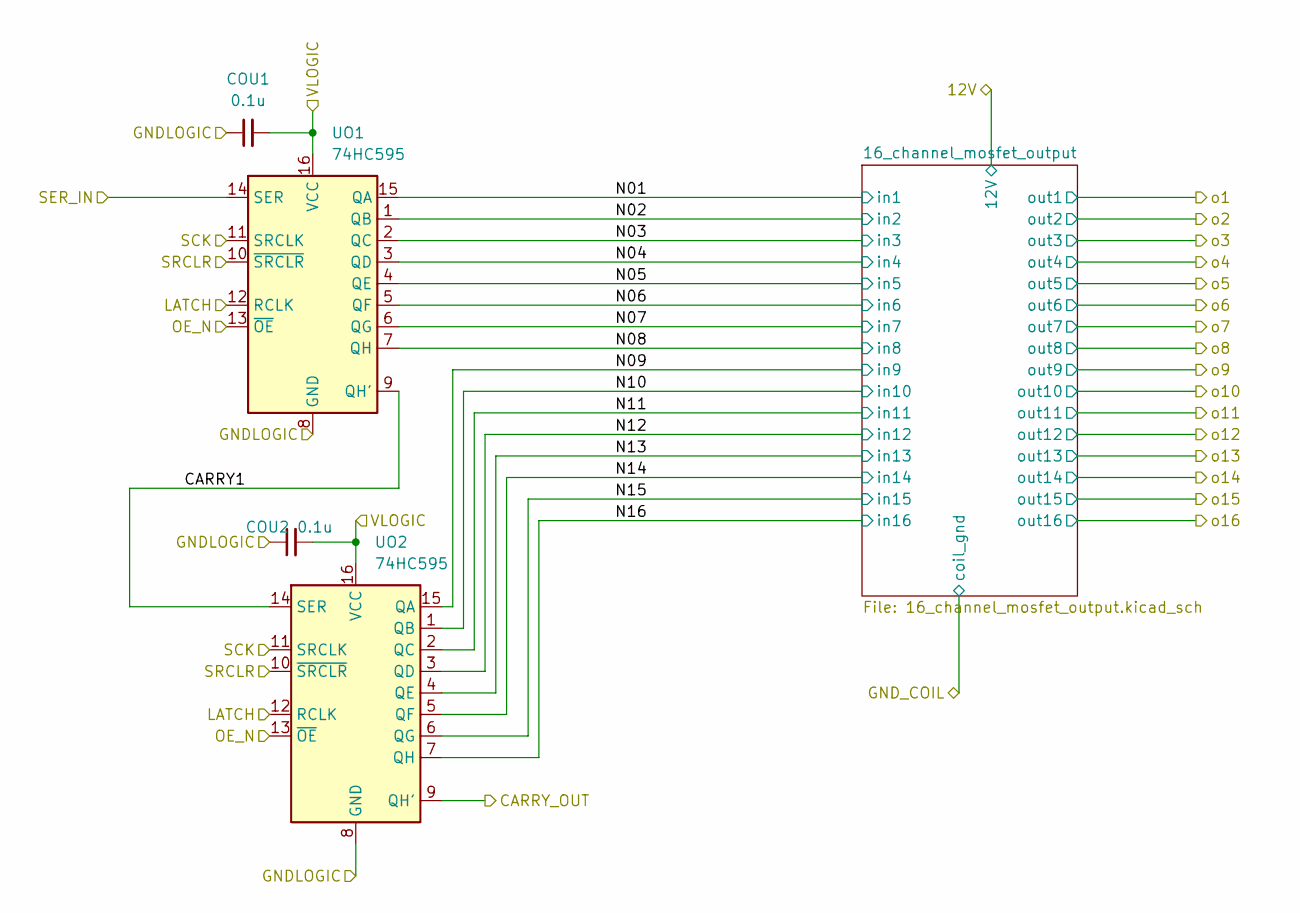
[picture p38: schematic 16_channel_output_block.kicad_sch]

Parts:
COU1, COU2: 0.1u; C_0805_2012Metric
UO1, UO2: 74HC595; SOP-16_3.9x9.9mm_P1.27mm

Connections:
+3.3V: COU1.2, COU2.2, UO1.16 (VCC), UO2.16 (VCC); also elsewhere on the board
/G_LATCH: UO1.12 (RCLK), UO2.12 (RCLK); also elsewhere on the board
/G_OE_N: UO1.13 (~OE), UO2.13 (~OE); also elsewhere on the board
/G_SCK: UO1.11 (SRCLK), UO2.11 (SRCLK); also elsewhere on the board
/G_SRCLR: UO1.10 (~SRCLR), UO2.10 (~SRCLR); also elsewhere on the board
/SERIAL_DATA: UO1.14 (SER); also elsewhere on the board
/outputs/16_channel_output_block/CARRY1: UO1.9 (QH'), UO2.14 (SER)
/outputs/16_channel_output_block/CARRY_OUT: UO2.9 (QH'); also elsewhere on the board
/outputs/16_channel_output_block/N01: UO1.15 (QA); also elsewhere on the board
/outputs/16_channel_output_block/N02: UO1.1 (QB); also elsewhere on the board
/outputs/16_channel_output_block/N03: UO1.2 (QC); also elsewhere on the board
/outputs/16_channel_output_block/N04: UO1.3 (QD); also elsewhere on the board
/outputs/16_channel_output_block/N05: UO1.4 (QE); also elsewhere on the board
/outputs/16_channel_output_block/N06: UO1.5 (QF); also elsewhere on the board
/outputs/16_channel_output_block/N07: UO1.6 (QG); also elsewhere on the board
/outputs/16_channel_output_block/N08: UO1.7 (QH); also elsewhere on the board
/outputs/16_channel_output_block/N09: UO2.15 (QA); also elsewhere on the board
/outputs/16_channel_output_block/N10: UO2.1 (QB); also elsewhere on the board
/outputs/16_channel_output_block/N11: UO2.2 (QC); also elsewhere on the board
/outputs/16_channel_output_block/N12: UO2.3 (QD); also elsewhere on the board
/outputs/16_channel_output_block/N13: UO2.4 (QE); also elsewhere on the board
/outputs/16_channel_output_block/N14: UO2.5 (QF); also elsewhere on the board
/outputs/16_channel_output_block/N15: UO2.6 (QG); also elsewhere on the board
/outputs/16_channel_output_block/N16: UO2.7 (QH); also elsewhere on the board
GND: COU1.1, COU2.1, UO1.8 (GND), UO2.8 (GND); also elsewhere on the board

Parts of its further copies:
COU3, COU4, COU5, COU6, COU7, COU8, COU9, COU10: 0.1u; C_0805_2012Metric
UO3, UO4, UO5, UO6, UO7, UO8, UO9, UO10: 74HC595; SOP-16_3.9x9.9mm_P1.27mm

Connections of its further copies:
+3.3V: COU3.2, COU4.2, COU5.2, COU6.2, COU7.2, COU8.2, COU9.2, COU10.2, UO3.16 (VCC), UO4.16 (VCC), UO5.16 (VCC), UO6.16 (VCC), UO7.16 (VCC), UO8.16 (VCC), UO9.16 (VCC), UO10.16 (VCC); also elsewhere on the board
/G_CARRY_OUT: UO10.9 (QH'); also elsewhere on the board
/G_LATCH: UO3.12 (RCLK), UO4.12 (RCLK), UO5.12 (RCLK), UO6.12 (RCLK), UO7.12 (RCLK), UO8.12 (RCLK), UO9.12 (RCLK), UO10.12 (RCLK); also elsewhere on the board
/G_OE_N: UO3.13 (~OE), UO4.13 (~OE), UO5.13 (~OE), UO6.13 (~OE), UO7.13 (~OE), UO8.13 (~OE), UO9.13 (~OE), UO10.13 (~OE); also elsewhere on the board
/G_SCK: UO3.11 (SRCLK), UO4.11 (SRCLK), UO5.11 (SRCLK), UO6.11 (SRCLK), UO7.11 (SRCLK), UO8.11 (SRCLK), UO9.11 (SRCLK), UO10.11 (SRCLK); also elsewhere on the board
/G_SRCLR: UO3.10 (~SRCLR), UO4.10 (~SRCLR), UO5.10 (~SRCLR), UO6.10 (~SRCLR), UO7.10 (~SRCLR), UO8.10 (~SRCLR), UO9.10 (~SRCLR), UO10.10 (~SRCLR); also elsewhere on the board
/outputs/16_channel_output_block1/CARRY1: UO3.9 (QH'), UO4.14 (SER)
/outputs/16_channel_output_block1/CARRY_OUT: UO4.9 (QH'), UO5.14 (SER)
/outputs/16_channel_output_block1/N01: UO3.15 (QA); also elsewhere on the board
/outputs/16_channel_output_block1/N02: UO3.1 (QB); also elsewhere on the board
/outputs/16_channel_output_block1/N03: UO3.2 (QC); also elsewhere on the board
/outputs/16_channel_output_block1/N04: UO3.3 (QD); also elsewhere on the board
/outputs/16_channel_output_block1/N05: UO3.4 (QE); also elsewhere on the board
/outputs/16_channel_output_block1/N06: UO3.5 (QF); also elsewhere on the board
/outputs/16_channel_output_block1/N07: UO3.6 (QG); also elsewhere on the board
/outputs/16_channel_output_block1/N08: UO3.7 (QH); also elsewhere on the board
/outputs/16_channel_output_block1/N09: UO4.15 (QA); also elsewhere on the board
/outputs/16_channel_output_block1/N10: UO4.1 (QB); also elsewhere on the board
/outputs/16_channel_output_block1/N11: UO4.2 (QC); also elsewhere on the board
/outputs/16_channel_output_block1/N12: UO4.3 (QD); also elsewhere on the board
/outputs/16_channel_output_block1/N13: UO4.4 (QE); also elsewhere on the board
/outputs/16_channel_output_block1/N14: UO4.5 (QF); also elsewhere on the board
/outputs/16_channel_output_block1/N15: UO4.6 (QG); also elsewhere on the board
/outputs/16_channel_output_block1/N16: UO4.7 (QH); also elsewhere on the board
/outputs/16_channel_output_block2/CARRY1: UO5.9 (QH'), UO6.14 (SER)
/outputs/16_channel_output_block2/CARRY_OUT: UO6.9 (QH'), UO7.14 (SER)
/outputs/16_channel_output_block2/N01: UO5.15 (QA); also elsewhere on the board
/outputs/16_channel_output_block2/N02: UO5.1 (QB); also elsewhere on the board
/outputs/16_channel_output_block2/N03: UO5.2 (QC); also elsewhere on the board
/outputs/16_channel_output_block2/N04: UO5.3 (QD); also elsewhere on the board
/outputs/16_channel_output_block2/N05: UO5.4 (QE); also elsewhere on the board
/outputs/16_channel_output_block2/N06: UO5.5 (QF); also elsewhere on the board
/outputs/16_channel_output_block2/N07: UO5.6 (QG); also elsewhere on the board
/outputs/16_channel_output_block2/N08: UO5.7 (QH); also elsewhere on the board
/outputs/16_channel_output_block2/N09: UO6.15 (QA); also elsewhere on the board
/outputs/16_channel_output_block2/N10: UO6.1 (QB); also elsewhere on the board
/outputs/16_channel_output_block2/N11: UO6.2 (QC); also elsewhere on the board
/outputs/16_channel_output_block2/N12: UO6.3 (QD); also elsewhere on the board
/outputs/16_channel_output_block2/N13: UO6.4 (QE); also elsewhere on the board
/outputs/16_channel_output_block2/N14: UO6.5 (QF); also elsewhere on the board
/outputs/16_channel_output_block2/N15: UO6.6 (QG); also elsewhere on the board
/outputs/16_channel_output_block2/N16: UO6.7 (QH); also elsewhere on the board
/outputs/16_channel_output_block3/CARRY1: UO7.9 (QH'), UO8.14 (SER)
/outputs/16_channel_output_block3/CARRY_OUT: UO8.9 (QH'), UO9.14 (SER)
/outputs/16_channel_output_block3/N01: UO7.15 (QA); also elsewhere on the board
/outputs/16_channel_output_block3/N02: UO7.1 (QB); also elsewhere on the board
/outputs/16_channel_output_block3/N03: UO7.2 (QC); also elsewhere on the board
/outputs/16_channel_output_block3/N04: UO7.3 (QD); also elsewhere on the board
/outputs/16_channel_output_block3/N05: UO7.4 (QE); also elsewhere on the board
/outputs/16_channel_output_block3/N06: UO7.5 (QF); also elsewhere on the board
/outputs/16_channel_output_block3/N07: UO7.6 (QG); also elsewhere on the board
/outputs/16_channel_output_block3/N08: UO7.7 (QH); also elsewhere on the board
/outputs/16_channel_output_block3/N09: UO8.15 (QA); also elsewhere on the board
/outputs/16_channel_output_block3/N10: UO8.1 (QB); also elsewhere on the board
/outputs/16_channel_output_block3/N11: UO8.2 (QC); also elsewhere on the board
/outputs/16_channel_output_block3/N12: UO8.3 (QD); also elsewhere on the board
/outputs/16_channel_output_block3/N13: UO8.4 (QE); also elsewhere on the board
/outputs/16_channel_output_block3/N14: UO8.5 (QF); also elsewhere on the board
/outputs/16_channel_output_block3/N15: UO8.6 (QG); also elsewhere on the board
/outputs/16_channel_output_block3/N16: UO8.7 (QH); also elsewhere on the board
/outputs/16_channel_output_block4/CARRY1: UO9.9 (QH'), UO10.14 (SER)
/outputs/16_channel_output_block4/N01: UO9.15 (QA); also elsewhere on the board
/outputs/16_channel_output_block4/N02: UO9.1 (QB); also elsewhere on the board
/outputs/16_channel_output_block4/N03: UO9.2 (QC); also elsewhere on the board
/outputs/16_channel_output_block4/N04: UO9.3 (QD); also elsewhere on the board
/outputs/16_channel_output_block4/N05: UO9.4 (QE); also elsewhere on the board
/outputs/16_channel_output_block4/N06: UO9.5 (QF); also elsewhere on the board
/outputs/16_channel_output_block4/N07: UO9.6 (QG); also elsewhere on the board
/outputs/16_channel_output_block4/N08: UO9.7 (QH); also elsewhere on the board
/outputs/16_channel_output_block4/N09: UO10.15 (QA); also elsewhere on the board
/outputs/16_channel_output_block4/N10: UO10.1 (QB); also elsewhere on the board
/outputs/16_channel_output_block4/N11: UO10.2 (QC); also elsewhere on the board
/outputs/16_channel_output_block4/N12: UO10.3 (QD); also elsewhere on the board
/outputs/16_channel_output_block4/N13: UO10.4 (QE); also elsewhere on the board
/outputs/16_channel_output_block4/N14: UO10.5 (QF); also elsewhere on the board
/outputs/16_channel_output_block4/N15: UO10.6 (QG); also elsewhere on the board
/outputs/16_channel_output_block4/N16: UO10.7 (QH); also elsewhere on the board
/outputs/16_channel_output_block/CARRY_OUT: UO3.14 (SER); also elsewhere on the board
GND: COU3.1, COU4.1, COU5.1, COU6.1, COU7.1, COU8.1, COU9.1, COU10.1, UO3.8 (GND), UO4.8 (GND), UO5.8 (GND), UO6.8 (GND), UO7.8 (GND), UO8.8 (GND), UO9.8 (GND), UO10.8 (GND); also elsewhere on the board

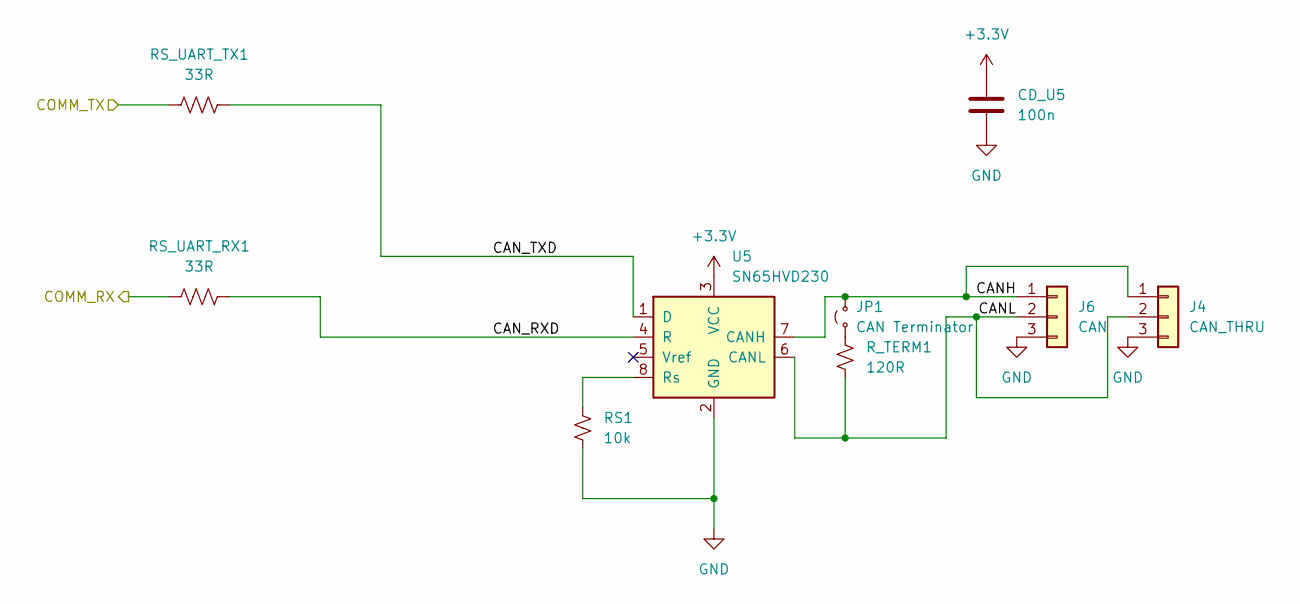
[picture p39: schematic BoardToBoardComms.kicad_sch]

Parts:
CD_U5: 100n; C_0603_1608Metric
J4: CAN_THRU; JST_PH_B3B-PH-K_1x03_P2.00mm_Vertical
J6: CAN; JST_PH_B3B-PH-K_1x03_P2.00mm_Vertical
JP1: CAN Terminator; PinHeader_1x02_P2.54mm_Vertical
RS1: 10k; R_0603_1608Metric
RS_UART_RX1: 33R; R_0603_1608Metric
RS_UART_TX1: 33R; R_0603_1608Metric
R_TERM1: 120R; R_0603_1608Metric
U5: SN65HVD230; SOIC-8_3.9x4.9mm_P1.27mm

Connections:
+3.3V: CD_U5.1, U5.3 (VCC); also elsewhere on the board
/Controller/BoardToBoardComms/CANH: J4.1, J6.1, JP1.2 (B), U5.7 (CANH)
/Controller/BoardToBoardComms/CANL: J4.2, J6.2, R_TERM1.2, U5.6 (CANL)
/Controller/BoardToBoardComms/CAN_RXD: RS_UART_RX1.2, U5.4 (R)
/Controller/BoardToBoardComms/CAN_TXD: RS_UART_TX1.2, U5.1 (D)
/Controller/COMM_RX: RS_UART_RX1.1; also elsewhere on the board
/Controller/COMM_TX: RS_UART_TX1.1; also elsewhere on the board
GND: CD_U5.2, J4.3, J6.3, RS1.2, U5.2 (GND); also elsewhere on the board
unnamed: JP1.1 (A), R_TERM1.1
unnamed: RS1.1, U5.8 (Rs)

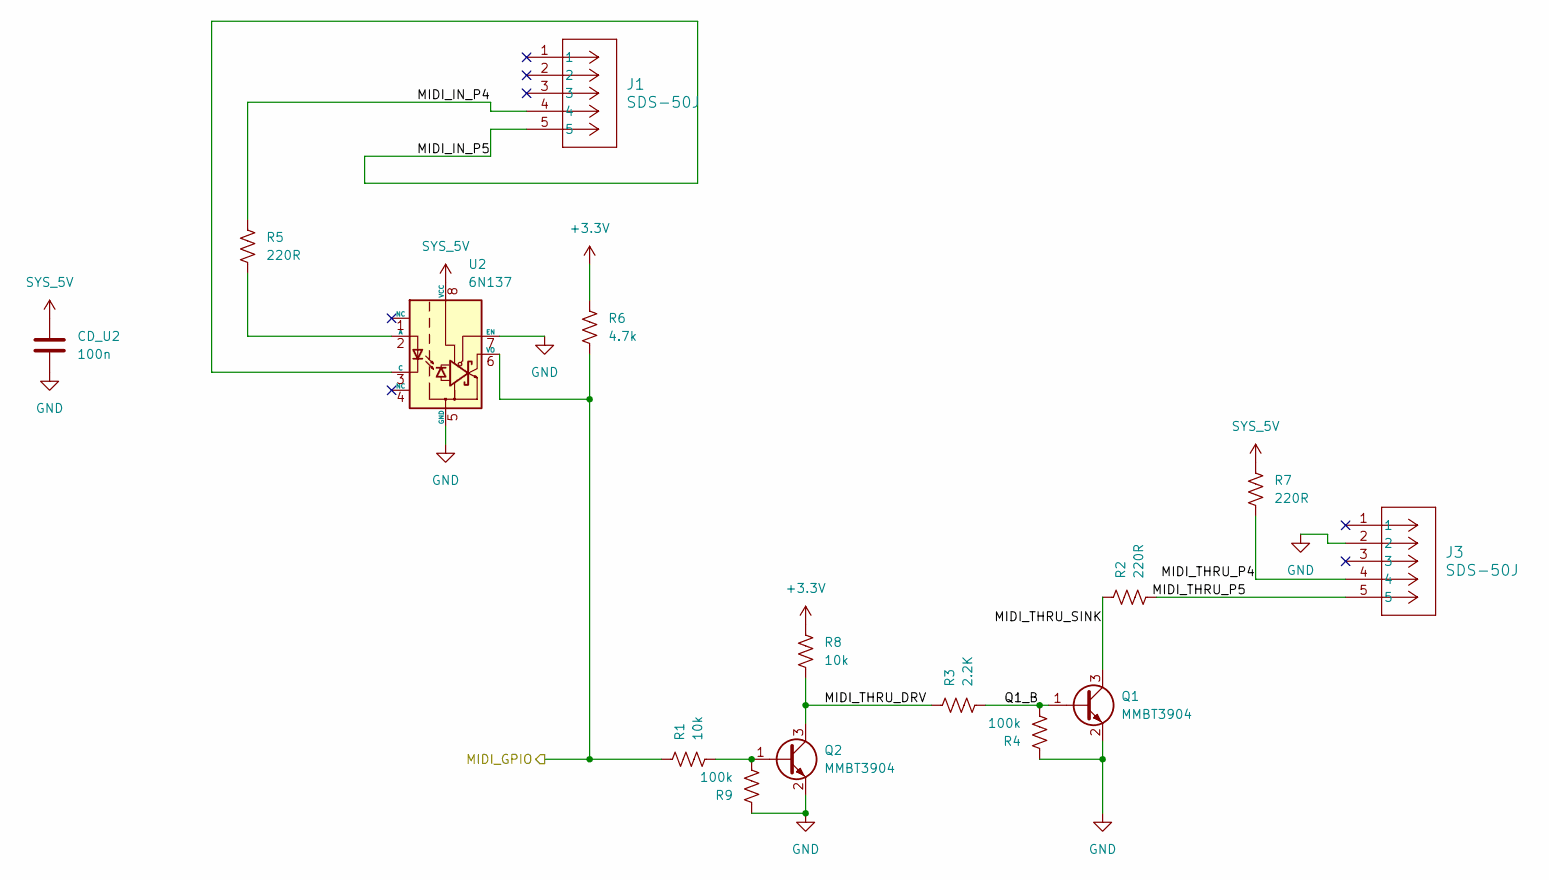
[picture p40: schematic MIDI.kicad_sch]

Parts:
CD_U2: 100n; C_0603_1608Metric
J1, J3: SDS-50J; Custom_CONN5_SDS-50J_CUD
Q1, Q2: MMBT3904; SOT-23
R1, R8: 10k; R_0603_1608Metric
R2, R5, R7: 220R; R_0603_1608Metric
R3: 2.2K; R_0603_1608Metric
R4, R9: 100k; R_0603_1608Metric
R6: 4.7k; R_0603_1608Metric
U2: 6N137; DIP-8_W7.62mm

Connections:
+3.3V: R6.1, R8.1; also elsewhere on the board
/Controller/MIDI/MIDI_IN_P4: J1.4, R5.1
/Controller/MIDI/MIDI_IN_P5: J1.5, U2.3 (C)
/Controller/MIDI/MIDI_THRU_DRV: Q2.3 (C), R3.1, R8.2
/Controller/MIDI/MIDI_THRU_P4: J3.4, R7.2
/Controller/MIDI/MIDI_THRU_P5: J3.5, R2.2
/Controller/MIDI/MIDI_THRU_SINK: Q1.3 (C), R2.1
/Controller/MIDI/Q1_B: Q1.1 (B), R3.2, R4.2
/Controller/MIDI_GPIO: R1.1, R6.2, U2.6 (VO); also elsewhere on the board
GND: CD_U2.2, J3.2, Q1.2 (E), Q2.2 (E), R4.1, R9.1, U2.5 (GND), U2.7 (EN); also elsewhere on the board
unnamed: Q2.1 (B), R1.2, R9.2
unnamed: R5.2, U2.2 (A)
SYS_5V: CD_U2.1, R7.1, U2.8 (VCC); also elsewhere on the board
