dkhorn/organ/kicad/OrganUnifiedSoundboard/OrganUnifiedSoundboard.kicad_pcb

## KiCad design kicad/OrganUnifiedSoundboard/OrganUnifiedSoundboard.kicad_pcb (continued)

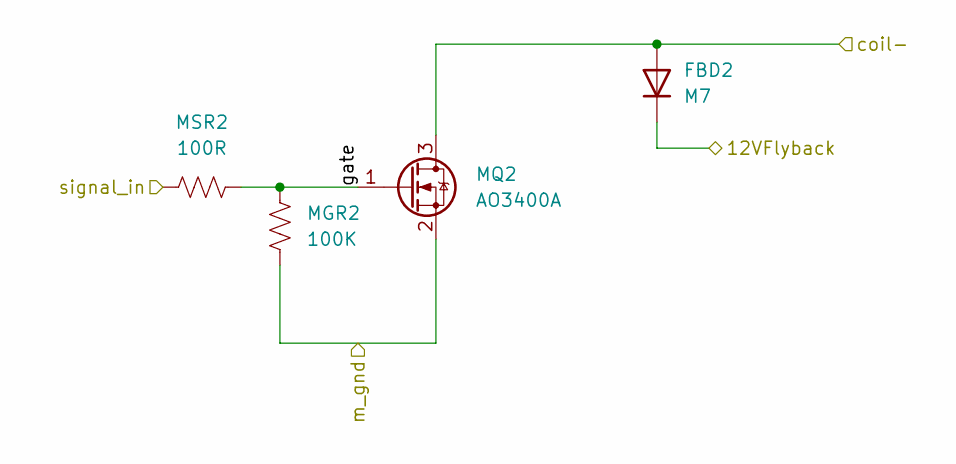
[picture p41: schematic mosfet_channel.kicad_sch]

Parts:
FBD2: M7; D_SMA
MGR2: 100K; R_0603_1608Metric
MQ2: AO3400A; SOT-23
MSR2: 100R; R_0603_1608Metric

Connections:
+12V: FBD2.1 (K); also elsewhere on the board
/outputs/16_channel_output_block/16_channel_mosfet_output/mosfet_channel1/gate: MGR2.1, MQ2.1 (G), MSR2.2
/outputs/16_channel_output_block/GND_COIL: MGR2.2, MQ2.2 (S); also elsewhere on the board
/outputs/16_channel_output_block/N01: MSR2.1; also elsewhere on the board
/outputs/coil_o1: FBD2.2 (A), MQ2.3 (D); also elsewhere on the board

Parts of its further copies:
FBD1, FBD3, FBD4, FBD5, FBD6, FBD7, FBD8, FBD9, FBD10, FBD11, FBD12, FBD13, FBD14, FBD15, FBD16, FBD17, FBD18, FBD19, FBD20, FBD21, FBD22, FBD23, FBD24, FBD25, FBD26, FBD27, FBD28, FBD29, FBD30, FBD31, FBD32, FBD33, FBD34, FBD35, FBD36, FBD37, FBD38, FBD39, FBD40, FBD41, FBD42, FBD43, FBD44, FBD45, FBD46, FBD47, FBD48, FBD49, FBD50, FBD51, FBD52, FBD53, FBD54, FBD55, FBD56, FBD57, FBD58, FBD59, FBD60, FBD61, FBD62, FBD63, FBD64, FBD65, FBD66, FBD67, FBD68, FBD69, FBD70, FBD71, FBD72, FBD73, FBD74, FBD75, FBD76, FBD77, FBD78, FBD79, FBD80: M7; D_SMA
MGR1, MGR3, MGR4, MGR5, MGR6, MGR7, MGR8, MGR9, MGR10, MGR11, MGR12, MGR13, MGR14, MGR15, MGR16, MGR17, MGR18, MGR19, MGR20, MGR21, MGR22, MGR23, MGR24, MGR25, MGR26, MGR27, MGR28, MGR29, MGR30, MGR31, MGR32, MGR33, MGR34, MGR35, MGR36, MGR37, MGR38, MGR39, MGR40, MGR41, MGR42, MGR43, MGR44, MGR45, MGR46, MGR47, MGR48, MGR49, MGR50, MGR51, MGR52, MGR53, MGR54, MGR55, MGR56, MGR57, MGR58, MGR59, MGR60, MGR61, MGR62, MGR63, MGR64, MGR65, MGR66, MGR67, MGR68, MGR69, MGR70, MGR71, MGR72, MGR73, MGR74, MGR75, MGR76, MGR77, MGR78, MGR79, MGR80: 100K; R_0603_1608Metric
MQ1, MQ3, MQ4, MQ5, MQ6, MQ7, MQ8, MQ9, MQ10, MQ11, MQ12, MQ13, MQ14, MQ15, MQ16, MQ17, MQ18, MQ19, MQ20, MQ21, MQ22, MQ23, MQ24, MQ25, MQ26, MQ27, MQ28, MQ29, MQ30, MQ31, MQ32, MQ33, MQ34, MQ35, MQ36, MQ37, MQ38, MQ39, MQ40, MQ41, MQ42, MQ43, MQ44, MQ45, MQ46, MQ47, MQ48, MQ49, MQ50, MQ51, MQ52, MQ53, MQ54, MQ55, MQ56, MQ57, MQ58, MQ59, MQ60, MQ61, MQ62, MQ63, MQ64, MQ65, MQ66, MQ67, MQ68, MQ69, MQ70, MQ71, MQ72, MQ73, MQ74, MQ75, MQ76, MQ77, MQ78, MQ79, MQ80: AO3400A; SOT-23
MSR1, MSR3, MSR4, MSR5, MSR6, MSR7, MSR8, MSR9, MSR10, MSR11, MSR12, MSR13, MSR14, MSR15, MSR16, MSR17, MSR18, MSR19, MSR20, MSR21, MSR22, MSR23, MSR24, MSR25, MSR26, MSR27, MSR28, MSR29, MSR30, MSR31, MSR32, MSR33, MSR34, MSR35, MSR36, MSR37, MSR38, MSR39, MSR40, MSR41, MSR42, MSR43, MSR44, MSR45, MSR46, MSR47, MSR48, MSR49, MSR50, MSR51, MSR52, MSR53, MSR54, MSR55, MSR56, MSR57, MSR58, MSR59, MSR60, MSR61, MSR62, MSR63, MSR64, MSR65, MSR66, MSR67, MSR68, MSR69, MSR70, MSR71, MSR72, MSR73, MSR74, MSR75, MSR76, MSR77, MSR78, MSR79, MSR80: 100R; R_0603_1608Metric

Connections of its further copies:
+12V: FBD1.1 (K), FBD3.1 (K), FBD4.1 (K), FBD5.1 (K), FBD6.1 (K), FBD7.1 (K), FBD8.1 (K), FBD9.1 (K), FBD10.1 (K), FBD11.1 (K), FBD12.1 (K), FBD13.1 (K), FBD14.1 (K), FBD15.1 (K), FBD16.1 (K), FBD17.1 (K), FBD18.1 (K), FBD19.1 (K), FBD20.1 (K), FBD21.1 (K), FBD22.1 (K), FBD23.1 (K), FBD24.1 (K), FBD25.1 (K), FBD26.1 (K), FBD27.1 (K), FBD28.1 (K), FBD29.1 (K), FBD30.1 (K), FBD31.1 (K), FBD32.1 (K), FBD33.1 (K), FBD34.1 (K), FBD35.1 (K), FBD36.1 (K), FBD37.1 (K), FBD38.1 (K), FBD39.1 (K), FBD40.1 (K), FBD41.1 (K), FBD42.1 (K), FBD43.1 (K), FBD44.1 (K), FBD45.1 (K), FBD46.1 (K), FBD47.1 (K), FBD48.1 (K), FBD49.1 (K), FBD50.1 (K), FBD51.1 (K), FBD52.1 (K), FBD53.1 (K), FBD54.1 (K), FBD55.1 (K), FBD56.1 (K), FBD57.1 (K), FBD58.1 (K), FBD59.1 (K), FBD60.1 (K), FBD61.1 (K), FBD62.1 (K), FBD63.1 (K), FBD64.1 (K), FBD65.1 (K), FBD66.1 (K), FBD67.1 (K), FBD68.1 (K), FBD69.1 (K), FBD70.1 (K), FBD71.1 (K), FBD72.1 (K), FBD73.1 (K), FBD74.1 (K), FBD75.1 (K), FBD76.1 (K), FBD77.1 (K), FBD78.1 (K), FBD79.1 (K), FBD80.1 (K); also elsewhere on the board
/outputs/16_channel_output_block1/16_channel_mosfet_output/mosfet_channel1/gate: MGR17.1, MQ17.1 (G), MSR17.2
/outputs/16_channel_output_block1/16_channel_mosfet_output/mosfet_channel2/gate: MGR18.1, MQ18.1 (G), MSR18.2
/outputs/16_channel_output_block1/16_channel_mosfet_output/mosfet_channel3/gate: MGR20.1, MQ20.1 (G), MSR20.2
/outputs/16_channel_output_block1/16_channel_mosfet_output/mosfet_channel4/gate: MGR19.1, MQ19.1 (G), MSR19.2
/outputs/16_channel_output_block1/16_channel_mosfet_output/mosfet_channel5/gate: MGR29.1, MQ29.1 (G), MSR29.2
/outputs/16_channel_output_block1/16_channel_mosfet_output/mosfet_channel6/gate: MGR30.1, MQ30.1 (G), MSR30.2
/outputs/16_channel_output_block1/16_channel_mosfet_output/mosfet_channel7/gate: MGR31.1, MQ31.1 (G), MSR31.2
/outputs/16_channel_output_block1/16_channel_mosfet_output/mosfet_channel8/gate: MGR32.1, MQ32.1 (G), MSR32.2
/outputs/16_channel_output_block1/16_channel_mosfet_output/mosfet_channel9/gate: MGR22.1, MQ22.1 (G), MSR22.2
/outputs/16_channel_output_block1/16_channel_mosfet_output/mosfet_channel10/gate: MGR21.1, MQ21.1 (G), MSR21.2
/outputs/16_channel_output_block1/16_channel_mosfet_output/mosfet_channel11/gate: MGR23.1, MQ23.1 (G), MSR23.2
/outputs/16_channel_output_block1/16_channel_mosfet_output/mosfet_channel12/gate: MGR24.1, MQ24.1 (G), MSR24.2
/outputs/16_channel_output_block1/16_channel_mosfet_output/mosfet_channel13/gate: MGR27.1, MQ27.1 (G), MSR27.2
/outputs/16_channel_output_block1/16_channel_mosfet_output/mosfet_channel14/gate: MGR26.1, MQ26.1 (G), MSR26.2
/outputs/16_channel_output_block1/16_channel_mosfet_output/mosfet_channel15/gate: MGR28.1, MQ28.1 (G), MSR28.2
/outputs/16_channel_output_block1/16_channel_mosfet_output/mosfet_channel16/gate: MGR25.1, MQ25.1 (G), MSR25.2
/outputs/16_channel_output_block1/GND_COIL: MGR17.2, MGR18.2, MGR19.2, MGR20.2, MGR21.2, MGR22.2, MGR23.2, MGR24.2, MGR25.2, MGR26.2, MGR27.2, MGR28.2, MGR29.2, MGR30.2, MGR31.2, MGR32.2, MQ17.2 (S), MQ18.2 (S), MQ19.2 (S), MQ20.2 (S), MQ21.2 (S), MQ22.2 (S), MQ23.2 (S), MQ24.2 (S), MQ25.2 (S), MQ26.2 (S), MQ27.2 (S), MQ28.2 (S), MQ29.2 (S), MQ30.2 (S), MQ31.2 (S), MQ32.2 (S); also elsewhere on the board
/outputs/16_channel_output_block1/N01: MSR17.1; also elsewhere on the board
/outputs/16_channel_output_block1/N02: MSR18.1; also elsewhere on the board
/outputs/16_channel_output_block1/N03: MSR20.1; also elsewhere on the board
/outputs/16_channel_output_block1/N04: MSR19.1; also elsewhere on the board
/outputs/16_channel_output_block1/N05: MSR29.1; also elsewhere on the board
/outputs/16_channel_output_block1/N06: MSR30.1; also elsewhere on the board
/outputs/16_channel_output_block1/N07: MSR31.1; also elsewhere on the board
/outputs/16_channel_output_block1/N08: MSR32.1; also elsewhere on the board
/outputs/16_channel_output_block1/N09: MSR22.1; also elsewhere on the board
/outputs/16_channel_output_block1/N10: MSR21.1; also elsewhere on the board
/outputs/16_channel_output_block1/N11: MSR23.1; also elsewhere on the board
/outputs/16_channel_output_block1/N12: MSR24.1; also elsewhere on the board
/outputs/16_channel_output_block1/N13: MSR27.1; also elsewhere on the board
/outputs/16_channel_output_block1/N14: MSR26.1; also elsewhere on the board
/outputs/16_channel_output_block1/N15: MSR28.1; also elsewhere on the board
/outputs/16_channel_output_block1/N16: MSR25.1; also elsewhere on the board
/outputs/16_channel_output_block2/16_channel_mosfet_output/mosfet_channel1/gate: MGR33.1, MQ33.1 (G), MSR33.2
/outputs/16_channel_output_block2/16_channel_mosfet_output/mosfet_channel2/gate: MGR34.1, MQ34.1 (G), MSR34.2
/outputs/16_channel_output_block2/16_channel_mosfet_output/mosfet_channel3/gate: MGR36.1, MQ36.1 (G), MSR36.2
/outputs/16_channel_output_block2/16_channel_mosfet_output/mosfet_channel4/gate: MGR35.1, MQ35.1 (G), MSR35.2
/outputs/16_channel_output_block2/16_channel_mosfet_output/mosfet_channel5/gate: MGR45.1, MQ45.1 (G), MSR45.2
/outputs/16_channel_output_block2/16_channel_mosfet_output/mosfet_channel6/gate: MGR46.1, MQ46.1 (G), MSR46.2
/outputs/16_channel_output_block2/16_channel_mosfet_output/mosfet_channel7/gate: MGR47.1, MQ47.1 (G), MSR47.2
/outputs/16_channel_output_block2/16_channel_mosfet_output/mosfet_channel8/gate: MGR48.1, MQ48.1 (G), MSR48.2
/outputs/16_channel_output_block2/16_channel_mosfet_output/mosfet_channel9/gate: MGR38.1, MQ38.1 (G), MSR38.2
/outputs/16_channel_output_block2/16_channel_mosfet_output/mosfet_channel10/gate: MGR37.1, MQ37.1 (G), MSR37.2
/outputs/16_channel_output_block2/16_channel_mosfet_output/mosfet_channel11/gate: MGR39.1, MQ39.1 (G), MSR39.2
/outputs/16_channel_output_block2/16_channel_mosfet_output/mosfet_channel12/gate: MGR40.1, MQ40.1 (G), MSR40.2
/outputs/16_channel_output_block2/16_channel_mosfet_output/mosfet_channel13/gate: MGR43.1, MQ43.1 (G), MSR43.2
/outputs/16_channel_output_block2/16_channel_mosfet_output/mosfet_channel14/gate: MGR42.1, MQ42.1 (G), MSR42.2
/outputs/16_channel_output_block2/16_channel_mosfet_output/mosfet_channel15/gate: MGR44.1, MQ44.1 (G), MSR44.2
/outputs/16_channel_output_block2/16_channel_mosfet_output/mosfet_channel16/gate: MGR41.1, MQ41.1 (G), MSR41.2
/outputs/16_channel_output_block2/GND_COIL: MGR33.2, MGR34.2, MGR35.2, MGR36.2, MGR37.2, MGR38.2, MGR39.2, MGR40.2, MGR41.2, MGR42.2, MGR43.2, MGR44.2, MGR45.2, MGR46.2, MGR47.2, MGR48.2, MQ33.2 (S), MQ34.2 (S), MQ35.2 (S), MQ36.2 (S), MQ37.2 (S), MQ38.2 (S), MQ39.2 (S), MQ40.2 (S), MQ41.2 (S), MQ42.2 (S), MQ43.2 (S), MQ44.2 (S), MQ45.2 (S), MQ46.2 (S), MQ47.2 (S), MQ48.2 (S); also elsewhere on the board
/outputs/16_channel_output_block2/N01: MSR33.1; also elsewhere on the board
/outputs/16_channel_output_block2/N02: MSR34.1; also elsewhere on the board
/outputs/16_channel_output_block2/N03: MSR36.1; also elsewhere on the board
/outputs/16_channel_output_block2/N04: MSR35.1; also elsewhere on the board
/outputs/16_channel_output_block2/N05: MSR45.1; also elsewhere on the board
/outputs/16_channel_output_block2/N06: MSR46.1; also elsewhere on the board
/outputs/16_channel_output_block2/N07: MSR47.1; also elsewhere on the board
/outputs/16_channel_output_block2/N08: MSR48.1; also elsewhere on the board
/outputs/16_channel_output_block2/N09: MSR38.1; also elsewhere on the board
/outputs/16_channel_output_block2/N10: MSR37.1; also elsewhere on the board
/outputs/16_channel_output_block2/N11: MSR39.1; also elsewhere on the board
/outputs/16_channel_output_block2/N12: MSR40.1; also elsewhere on the board
/outputs/16_channel_output_block2/N13: MSR43.1; also elsewhere on the board
/outputs/16_channel_output_block2/N14: MSR42.1; also elsewhere on the board
/outputs/16_channel_output_block2/N15: MSR44.1; also elsewhere on the board
/outputs/16_channel_output_block2/N16: MSR41.1; also elsewhere on the board
/outputs/16_channel_output_block3/16_channel_mosfet_output/mosfet_channel1/gate: MGR49.1, MQ49.1 (G), MSR49.2
/outputs/16_channel_output_block3/16_channel_mosfet_output/mosfet_channel2/gate: MGR50.1, MQ50.1 (G), MSR50.2
/outputs/16_channel_output_block3/16_channel_mosfet_output/mosfet_channel3/gate: MGR52.1, MQ52.1 (G), MSR52.2
/outputs/16_channel_output_block3/16_channel_mosfet_output/mosfet_channel4/gate: MGR51.1, MQ51.1 (G), MSR51.2
/outputs/16_channel_output_block3/16_channel_mosfet_output/mosfet_channel5/gate: MGR61.1, MQ61.1 (G), MSR61.2
/outputs/16_channel_output_block3/16_channel_mosfet_output/mosfet_channel6/gate: MGR62.1, MQ62.1 (G), MSR62.2
/outputs/16_channel_output_block3/16_channel_mosfet_output/mosfet_channel7/gate: MGR63.1, MQ63.1 (G), MSR63.2
/outputs/16_channel_output_block3/16_channel_mosfet_output/mosfet_channel8/gate: MGR64.1, MQ64.1 (G), MSR64.2
/outputs/16_channel_output_block3/16_channel_mosfet_output/mosfet_channel9/gate: MGR54.1, MQ54.1 (G), MSR54.2
/outputs/16_channel_output_block3/16_channel_mosfet_output/mosfet_channel10/gate: MGR53.1, MQ53.1 (G), MSR53.2
/outputs/16_channel_output_block3/16_channel_mosfet_output/mosfet_channel11/gate: MGR55.1, MQ55.1 (G), MSR55.2
/outputs/16_channel_output_block3/16_channel_mosfet_output/mosfet_channel12/gate: MGR56.1, MQ56.1 (G), MSR56.2
/outputs/16_channel_output_block3/16_channel_mosfet_output/mosfet_channel13/gate: MGR59.1, MQ59.1 (G), MSR59.2
/outputs/16_channel_output_block3/16_channel_mosfet_output/mosfet_channel14/gate: MGR58.1, MQ58.1 (G), MSR58.2
/outputs/16_channel_output_block3/16_channel_mosfet_output/mosfet_channel15/gate: MGR60.1, MQ60.1 (G), MSR60.2
/outputs/16_channel_output_block3/16_channel_mosfet_output/mosfet_channel16/gate: MGR57.1, MQ57.1 (G), MSR57.2
/outputs/16_channel_output_block3/GND_COIL: MGR49.2, MGR50.2, MGR51.2, MGR52.2, MGR53.2, MGR54.2, MGR55.2, MGR56.2, MGR57.2, MGR58.2, MGR59.2, MGR60.2, MGR61.2, MGR62.2, MGR63.2, MGR64.2, MQ49.2 (S), MQ50.2 (S), MQ51.2 (S), MQ52.2 (S), MQ53.2 (S), MQ54.2 (S), MQ55.2 (S), MQ56.2 (S), MQ57.2 (S), MQ58.2 (S), MQ59.2 (S), MQ60.2 (S), MQ61.2 (S), MQ62.2 (S), MQ63.2 (S), MQ64.2 (S); also elsewhere on the board
/outputs/16_channel_output_block3/N01: MSR49.1; also elsewhere on the board
/outputs/16_channel_output_block3/N02: MSR50.1; also elsewhere on the board
/outputs/16_channel_output_block3/N03: MSR52.1; also elsewhere on the board
/outputs/16_channel_output_block3/N04: MSR51.1; also elsewhere on the board
/outputs/16_channel_output_block3/N05: MSR61.1; also elsewhere on the board
/outputs/16_channel_output_block3/N06: MSR62.1; also elsewhere on the board
/outputs/16_channel_output_block3/N07: MSR63.1; also elsewhere on the board
/outputs/16_channel_output_block3/N08: MSR64.1; also elsewhere on the board
/outputs/16_channel_output_block3/N09: MSR54.1; also elsewhere on the board
/outputs/16_channel_output_block3/N10: MSR53.1; also elsewhere on the board
/outputs/16_channel_output_block3/N11: MSR55.1; also elsewhere on the board
/outputs/16_channel_output_block3/N12: MSR56.1; also elsewhere on the board
/outputs/16_channel_output_block3/N13: MSR59.1; also elsewhere on the board
/outputs/16_channel_output_block3/N14: MSR58.1; also elsewhere on the board
/outputs/16_channel_output_block3/N15: MSR60.1; also elsewhere on the board
/outputs/16_channel_output_block3/N16: MSR57.1; also elsewhere on the board
/outputs/16_channel_output_block4/16_channel_mosfet_output/mosfet_channel1/gate: MGR65.1, MQ65.1 (G), MSR65.2
/outputs/16_channel_output_block4/16_channel_mosfet_output/mosfet_channel2/gate: MGR66.1, MQ66.1 (G), MSR66.2
/outputs/16_channel_output_block4/16_channel_mosfet_output/mosfet_channel3/gate: MGR68.1, MQ68.1 (G), MSR68.2
/outputs/16_channel_output_block4/16_channel_mosfet_output/mosfet_channel4/gate: MGR67.1, MQ67.1 (G), MSR67.2
/outputs/16_channel_output_block4/16_channel_mosfet_output/mosfet_channel5/gate: MGR77.1, MQ77.1 (G), MSR77.2
/outputs/16_channel_output_block4/16_channel_mosfet_output/mosfet_channel6/gate: MGR78.1, MQ78.1 (G), MSR78.2
/outputs/16_channel_output_block4/16_channel_mosfet_output/mosfet_channel7/gate: MGR79.1, MQ79.1 (G), MSR79.2
/outputs/16_channel_output_block4/16_channel_mosfet_output/mosfet_channel8/gate: MGR80.1, MQ80.1 (G), MSR80.2
/outputs/16_channel_output_block4/16_channel_mosfet_output/mosfet_channel9/gate: MGR70.1, MQ70.1 (G), MSR70.2
/outputs/16_channel_output_block4/16_channel_mosfet_output/mosfet_channel10/gate: MGR69.1, MQ69.1 (G), MSR69.2
/outputs/16_channel_output_block4/16_channel_mosfet_output/mosfet_channel11/gate: MGR71.1, MQ71.1 (G), MSR71.2
/outputs/16_channel_output_block4/16_channel_mosfet_output/mosfet_channel12/gate: MGR72.1, MQ72.1 (G), MSR72.2
/outputs/16_channel_output_block4/16_channel_mosfet_output/mosfet_channel13/gate: MGR75.1, MQ75.1 (G), MSR75.2
/outputs/16_channel_output_block4/16_channel_mosfet_output/mosfet_channel14/gate: MGR74.1, MQ74.1 (G), MSR74.2
/outputs/16_channel_output_block4/16_channel_mosfet_output/mosfet_channel15/gate: MGR76.1, MQ76.1 (G), MSR76.2
/outputs/16_channel_output_block4/16_channel_mosfet_output/mosfet_channel16/gate: MGR73.1, MQ73.1 (G), MSR73.2
/outputs/16_channel_output_block4/GND_COIL: MGR65.2, MGR66.2, MGR67.2, MGR68.2, MGR69.2, MGR70.2, MGR71.2, MGR72.2, MGR73.2, MGR74.2, MGR75.2, MGR76.2, MGR77.2, MGR78.2, MGR79.2, MGR80.2, MQ65.2 (S), MQ66.2 (S), MQ67.2 (S), MQ68.2 (S), MQ69.2 (S), MQ70.2 (S), MQ71.2 (S), MQ72.2 (S), MQ73.2 (S), MQ74.2 (S), MQ75.2 (S), MQ76.2 (S), MQ77.2 (S), MQ78.2 (S), MQ79.2 (S), MQ80.2 (S); also elsewhere on the board
/outputs/16_channel_output_block4/N01: MSR65.1; also elsewhere on the board
/outputs/16_channel_output_block4/N02: MSR66.1; also elsewhere on the board
/outputs/16_channel_output_block4/N03: MSR68.1; also elsewhere on the board
/outputs/16_channel_output_block4/N04: MSR67.1; also elsewhere on the board
/outputs/16_channel_output_block4/N05: MSR77.1; also elsewhere on the board
/outputs/16_channel_output_block4/N06: MSR78.1; also elsewhere on the board
/outputs/16_channel_output_block4/N07: MSR79.1; also elsewhere on the board
/outputs/16_channel_output_block4/N08: MSR80.1; also elsewhere on the board
/outputs/16_channel_output_block4/N09: MSR70.1; also elsewhere on the board
/outputs/16_channel_output_block4/N10: MSR69.1; also elsewhere on the board
/outputs/16_channel_output_block4/N11: MSR71.1; also elsewhere on the board
/outputs/16_channel_output_block4/N12: MSR72.1; also elsewhere on the board
/outputs/16_channel_output_block4/N13: MSR75.1; also elsewhere on the board
/outputs/16_channel_output_block4/N14: MSR74.1; also elsewhere on the board
/outputs/16_channel_output_block4/N15: MSR76.1; also elsewhere on the board
/outputs/16_channel_output_block4/N16: MSR73.1; also elsewhere on the board
/outputs/16_channel_output_block/16_channel_mosfet_output/mosfet_channel2/gate: MGR3.1, MQ3.1 (G), MSR3.2
/outputs/16_channel_output_block/16_channel_mosfet_output/mosfet_channel3/gate: MGR4.1, MQ4.1 (G), MSR4.2
/outputs/16_channel_output_block/16_channel_mosfet_output/mosfet_channel4/gate: MGR5.1, MQ5.1 (G), MSR5.2
/outputs/16_channel_output_block/16_channel_mosfet_output/mosfet_channel5/gate: MGR6.1, MQ6.1 (G), MSR6.2
/outputs/16_channel_output_block/16_channel_mosfet_output/mosfet_channel6/gate: MGR7.1, MQ7.1 (G), MSR7.2
/outputs/16_channel_output_block/16_channel_mosfet_output/mosfet_channel7/gate: MGR8.1, MQ8.1 (G), MSR8.2
/outputs/16_channel_output_block/16_channel_mosfet_output/mosfet_channel8/gate: MGR9.1, MQ9.1 (G), MSR9.2
/outputs/16_channel_output_block/16_channel_mosfet_output/mosfet_channel9/gate: MGR10.1, MQ10.1 (G), MSR10.2
/outputs/16_channel_output_block/16_channel_mosfet_output/mosfet_channel10/gate: MGR11.1, MQ11.1 (G), MSR11.2
/outputs/16_channel_output_block/16_channel_mosfet_output/mosfet_channel11/gate: MGR12.1, MQ12.1 (G), MSR12.2
/outputs/16_channel_output_block/16_channel_mosfet_output/mosfet_channel12/gate: MGR13.1, MQ13.1 (G), MSR13.2
/outputs/16_channel_output_block/16_channel_mosfet_output/mosfet_channel13/gate: MGR14.1, MQ14.1 (G), MSR14.2
/outputs/16_channel_output_block/16_channel_mosfet_output/mosfet_channel14/gate: MGR15.1, MQ15.1 (G), MSR15.2
/outputs/16_channel_output_block/16_channel_mosfet_output/mosfet_channel15/gate: MGR16.1, MQ16.1 (G), MSR16.2
/outputs/16_channel_output_block/16_channel_mosfet_output/mosfet_channel16/gate: MGR1.1, MQ1.1 (G), MSR1.2
/outputs/16_channel_output_block/GND_COIL: MGR1.2, MGR3.2, MGR4.2, MGR5.2, MGR6.2, MGR7.2, MGR8.2, MGR9.2, MGR10.2, MGR11.2, MGR12.2, MGR13.2, MGR14.2, MGR15.2, MGR16.2, MQ1.2 (S), MQ3.2 (S), MQ4.2 (S), MQ5.2 (S), MQ6.2 (S), MQ7.2 (S), MQ8.2 (S), MQ9.2 (S), MQ10.2 (S), MQ11.2 (S), MQ12.2 (S), MQ13.2 (S), MQ14.2 (S), MQ15.2 (S), MQ16.2 (S); also elsewhere on the board
/outputs/16_channel_output_block/N02: MSR3.1; also elsewhere on the board
/outputs/16_channel_output_block/N03: MSR4.1; also elsewhere on the board
/outputs/16_channel_output_block/N04: MSR5.1; also elsewhere on the board
/outputs/16_channel_output_block/N05: MSR6.1; also elsewhere on the board
/outputs/16_channel_output_block/N06: MSR7.1; also elsewhere on the board
/outputs/16_channel_output_block/N07: MSR8.1; also elsewhere on the board
/outputs/16_channel_output_block/N08: MSR9.1; also elsewhere on the board
/outputs/16_channel_output_block/N09: MSR10.1; also elsewhere on the board
/outputs/16_channel_output_block/N10: MSR11.1; also elsewhere on the board
/outputs/16_channel_output_block/N11: MSR12.1; also elsewhere on the board
/outputs/16_channel_output_block/N12: MSR13.1; also elsewhere on the board
/outputs/16_channel_output_block/N13: MSR14.1; also elsewhere on the board
/outputs/16_channel_output_block/N14: MSR15.1; also elsewhere on the board
/outputs/16_channel_output_block/N15: MSR16.1; also elsewhere on the board
/outputs/16_channel_output_block/N16: MSR1.1; also elsewhere on the board
/outputs/coil_o2: FBD3.2 (A), MQ3.3 (D); also elsewhere on the board
/outputs/coil_o3: FBD4.2 (A), MQ4.3 (D); also elsewhere on the board
/outputs/coil_o4: FBD5.2 (A), MQ5.3 (D); also elsewhere on the board
/outputs/coil_o5: FBD6.2 (A), MQ6.3 (D); also elsewhere on the board
/outputs/coil_o6: FBD7.2 (A), MQ7.3 (D); also elsewhere on the board
/outputs/coil_o7: FBD8.2 (A), MQ8.3 (D); also elsewhere on the board
/outputs/coil_o8: FBD9.2 (A), MQ9.3 (D); also elsewhere on the board
/outputs/coil_o9: FBD10.2 (A), MQ10.3 (D); also elsewhere on the board
/outputs/coil_o10: FBD11.2 (A), MQ11.3 (D); also elsewhere on the board
/outputs/coil_o11: FBD12.2 (A), MQ12.3 (D); also elsewhere on the board
/outputs/coil_o12: FBD13.2 (A), MQ13.3 (D); also elsewhere on the board
/outputs/coil_o13: FBD14.2 (A), MQ14.3 (D); also elsewhere on the board
/outputs/coil_o14: FBD15.2 (A), MQ15.3 (D); also elsewhere on the board
/outputs/coil_o15: FBD16.2 (A), MQ16.3 (D); also elsewhere on the board
/outputs/coil_o16: FBD1.2 (A), MQ1.3 (D); also elsewhere on the board
/outputs/coil_o17: FBD17.2 (A), MQ17.3 (D); also elsewhere on the board
/outputs/coil_o18: FBD18.2 (A), MQ18.3 (D); also elsewhere on the board
/outputs/coil_o19: FBD20.2 (A), MQ20.3 (D); also elsewhere on the board
/outputs/coil_o20: FBD19.2 (A), MQ19.3 (D); also elsewhere on the board
/outputs/coil_o21: FBD29.2 (A), MQ29.3 (D); also elsewhere on the board
/outputs/coil_o22: FBD30.2 (A), MQ30.3 (D); also elsewhere on the board
/outputs/coil_o23: FBD31.2 (A), MQ31.3 (D); also elsewhere on the board
/outputs/coil_o24: FBD32.2 (A), MQ32.3 (D); also elsewhere on the board
/outputs/coil_o25: FBD22.2 (A), MQ22.3 (D); also elsewhere on the board
/outputs/coil_o26: FBD21.2 (A), MQ21.3 (D); also elsewhere on the board
/outputs/coil_o27: FBD23.2 (A), MQ23.3 (D); also elsewhere on the board
/outputs/coil_o28: FBD24.2 (A), MQ24.3 (D); also elsewhere on the board
/outputs/coil_o29: FBD27.2 (A), MQ27.3 (D); also elsewhere on the board
/outputs/coil_o30: FBD26.2 (A), MQ26.3 (D); also elsewhere on the board
/outputs/coil_o31: FBD28.2 (A), MQ28.3 (D); also elsewhere on the board
/outputs/coil_o32: FBD25.2 (A), MQ25.3 (D); also elsewhere on the board
/outputs/coil_o33: FBD33.2 (A), MQ33.3 (D); also elsewhere on the board
/outputs/coil_o34: FBD34.2 (A), MQ34.3 (D); also elsewhere on the board
/outputs/coil_o35: FBD36.2 (A), MQ36.3 (D); also elsewhere on the board
/outputs/coil_o36: FBD35.2 (A), MQ35.3 (D); also elsewhere on the board
/outputs/coil_o37: FBD45.2 (A), MQ45.3 (D); also elsewhere on the board
/outputs/coil_o38: FBD46.2 (A), MQ46.3 (D); also elsewhere on the board
/outputs/coil_o39: FBD47.2 (A), MQ47.3 (D); also elsewhere on the board
/outputs/coil_o40: FBD48.2 (A), MQ48.3 (D); also elsewhere on the board
/outputs/coil_o41: FBD38.2 (A), MQ38.3 (D); also elsewhere on the board
/outputs/coil_o42: FBD37.2 (A), MQ37.3 (D); also elsewhere on the board
/outputs/coil_o43: FBD39.2 (A), MQ39.3 (D); also elsewhere on the board
/outputs/coil_o44: FBD40.2 (A), MQ40.3 (D); also elsewhere on the board
/outputs/coil_o45: FBD43.2 (A), MQ43.3 (D); also elsewhere on the board
/outputs/coil_o46: FBD42.2 (A), MQ42.3 (D); also elsewhere on the board
/outputs/coil_o47: FBD44.2 (A), MQ44.3 (D); also elsewhere on the board
/outputs/coil_o48: FBD41.2 (A), MQ41.3 (D); also elsewhere on the board
/outputs/coil_o49: FBD49.2 (A), MQ49.3 (D); also elsewhere on the board
/outputs/coil_o50: FBD50.2 (A), MQ50.3 (D); also elsewhere on the board
/outputs/coil_o51: FBD52.2 (A), MQ52.3 (D); also elsewhere on the board
/outputs/coil_o52: FBD51.2 (A), MQ51.3 (D); also elsewhere on the board
/outputs/coil_o53: FBD61.2 (A), MQ61.3 (D); also elsewhere on the board
/outputs/coil_o54: FBD62.2 (A), MQ62.3 (D); also elsewhere on the board
/outputs/coil_o55: FBD63.2 (A), MQ63.3 (D); also elsewhere on the board
/outputs/coil_o56: FBD64.2 (A), MQ64.3 (D); also elsewhere on the board
/outputs/coil_o57: FBD54.2 (A), MQ54.3 (D); also elsewhere on the board
/outputs/coil_o58: FBD53.2 (A), MQ53.3 (D); also elsewhere on the board
/outputs/coil_o59: FBD55.2 (A), MQ55.3 (D); also elsewhere on the board
/outputs/coil_o60: FBD56.2 (A), MQ56.3 (D); also elsewhere on the board
/outputs/coil_o61: FBD59.2 (A), MQ59.3 (D); also elsewhere on the board
/outputs/coil_o62: FBD58.2 (A), MQ58.3 (D); also elsewhere on the board
/outputs/coil_o63: FBD60.2 (A), MQ60.3 (D); also elsewhere on the board
/outputs/coil_o64: FBD57.2 (A), MQ57.3 (D); also elsewhere on the board
/outputs/coil_o65: FBD65.2 (A), MQ65.3 (D); also elsewhere on the board
/outputs/coil_o66: FBD66.2 (A), MQ66.3 (D); also elsewhere on the board
/outputs/coil_o67: FBD68.2 (A), MQ68.3 (D); also elsewhere on the board
/outputs/coil_o68: FBD67.2 (A), MQ67.3 (D); also elsewhere on the board
/outputs/coil_o69: FBD77.2 (A), MQ77.3 (D); also elsewhere on the board
/outputs/coil_o70: FBD78.2 (A), MQ78.3 (D); also elsewhere on the board
/outputs/coil_o71: FBD79.2 (A), MQ79.3 (D); also elsewhere on the board
/outputs/coil_o72: FBD80.2 (A), MQ80.3 (D); also elsewhere on the board
/outputs/coil_o73: FBD70.2 (A), MQ70.3 (D); also elsewhere on the board
/outputs/coil_o74: FBD69.2 (A), MQ69.3 (D); also elsewhere on the board
/outputs/coil_o75: FBD71.2 (A), MQ71.3 (D); also elsewhere on the board
/outputs/coil_o76: FBD72.2 (A), MQ72.3 (D); also elsewhere on the board
/outputs/coil_o77: FBD75.2 (A), MQ75.3 (D); also elsewhere on the board
/outputs/coil_o78: FBD74.2 (A), MQ74.3 (D); also elsewhere on the board
/outputs/coil_o79: FBD76.2 (A), MQ76.3 (D); also elsewhere on the board
/outputs/coil_o80: FBD73.2 (A), MQ73.3 (D); also elsewhere on the board

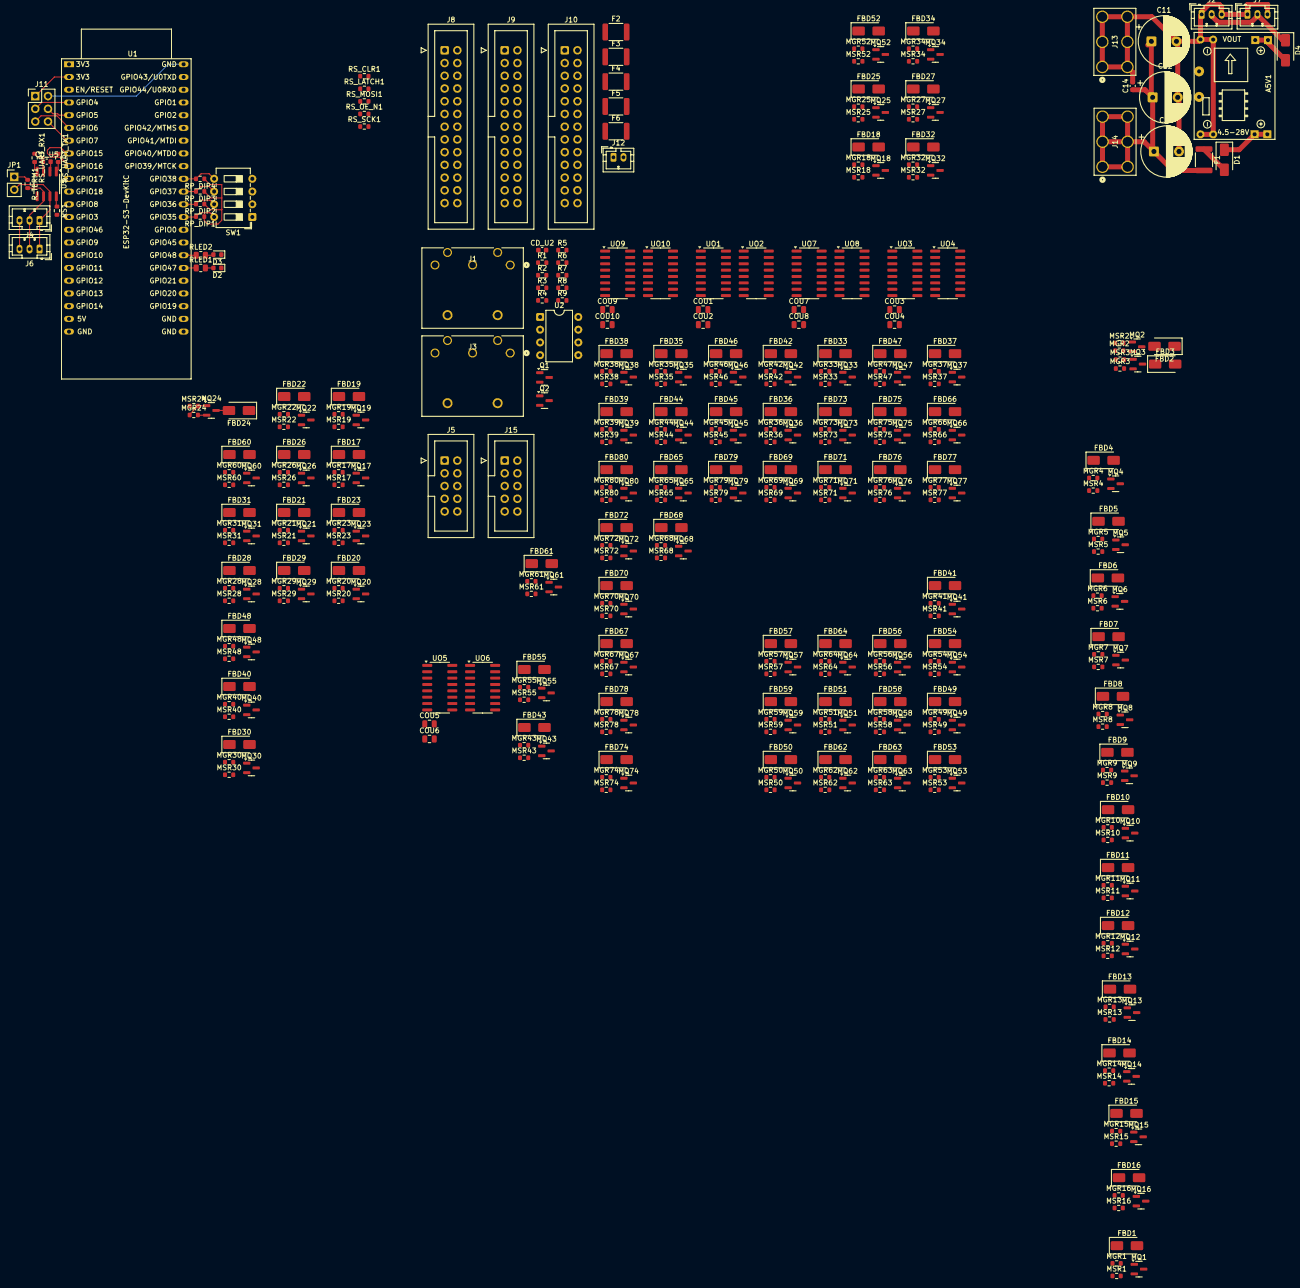
[picture p42: board OrganUnifiedSoundboard.kicad_pcb from above]

Board: 2 copper layers, 403 parts (0 on the bottom side), 303 nets.
