dkhorn/organ/kicad/OrganSPIToParallel/OrganSPIToParallel_V001.kicad_pcb

## KiCad design kicad/OrganSPIToParallel/OrganSPIToParallel_V001.kicad_pcb (2025-11-23)

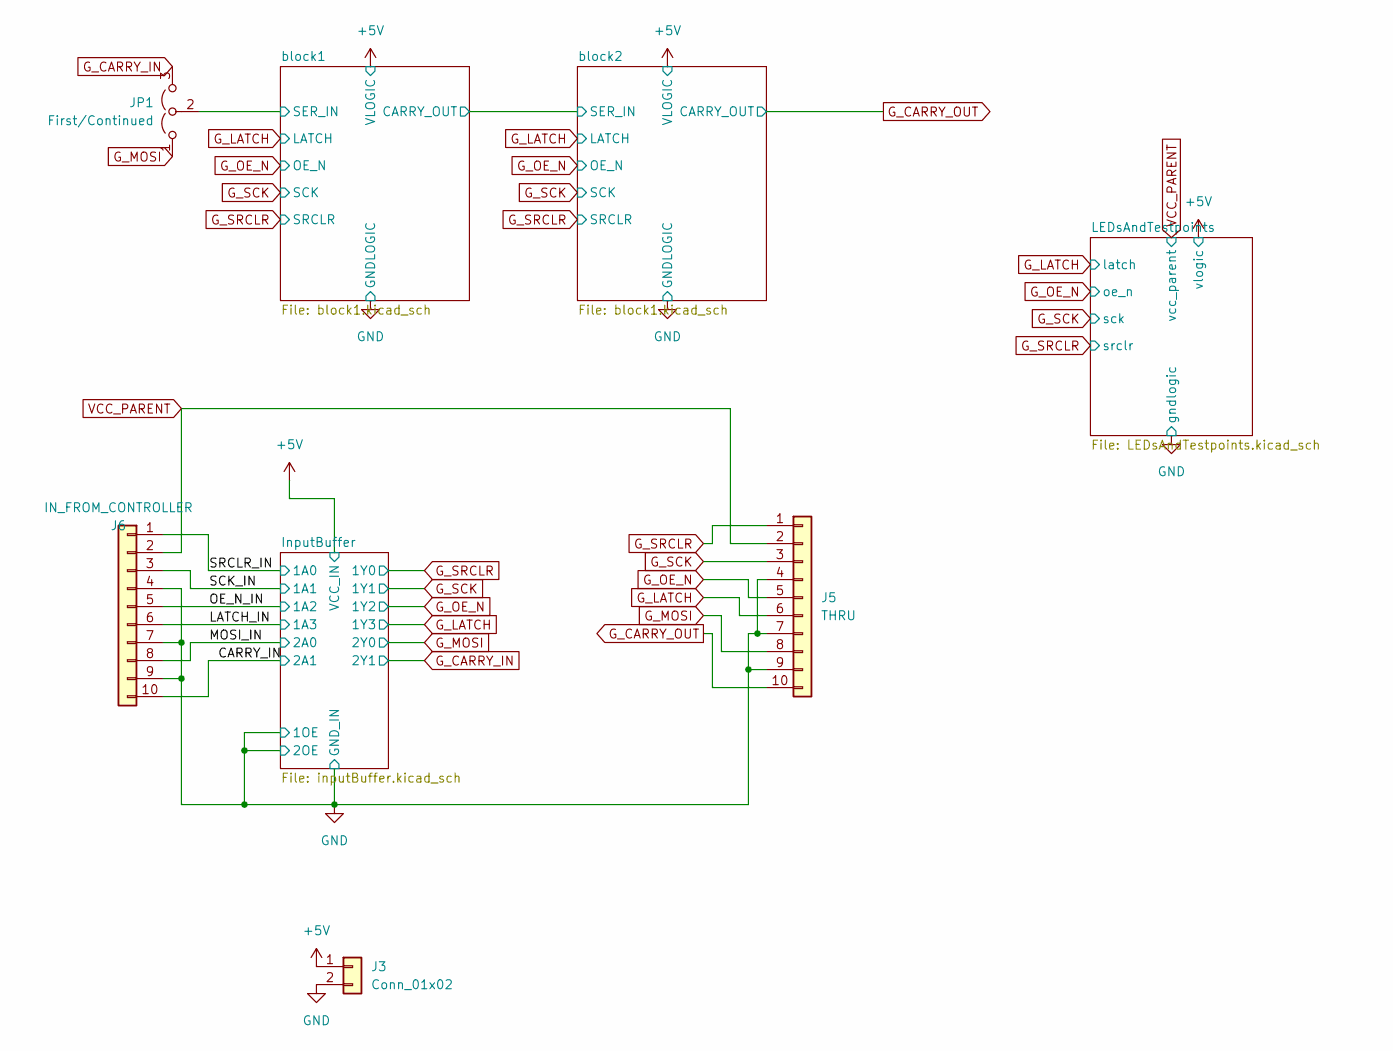
[picture p43: schematic OrganSPIToParallel_V001.kicad_sch]

Parts:
J3: Conn_01x02; JST_PH_B2B-PH-K_1x02_P2.00mm_Vertical
J5: THRU; IDC-Header_2x05_P2.54mm_Vertical
J6: IN_FROM_CONTROLLER; IDC-Header_2x05_P2.54mm_Vertical
JP1: First/Continued; PinHeader_1x03_P2.54mm_Vertical

Connections:
+5V: J3.1; also elsewhere on the board
/CARRY_IN: J6.10; also elsewhere on the board
/LATCH_IN: J6.6; also elsewhere on the board
/MOSI_IN: J6.8; also elsewhere on the board
/OE_N_IN: J6.5; also elsewhere on the board
/SCK_IN: J6.3; also elsewhere on the board
/SRCLR_IN: J6.1; also elsewhere on the board
/block1/SER_IN: JP1.2 (C); also elsewhere on the board
GND: J3.2, J5.4, J5.7, J5.9, J6.4, J6.7, J6.9; also elsewhere on the board
G_CARRY_IN: JP1.3 (B); also elsewhere on the board
G_CARRY_OUT: J5.10; also elsewhere on the board
G_LATCH: J5.6; also elsewhere on the board
G_MOSI: J5.8, JP1.1 (A); also elsewhere on the board
G_OE_N: J5.5; also elsewhere on the board
G_SCK: J5.3; also elsewhere on the board
G_SRCLR: J5.1; also elsewhere on the board
VCC_PARENT: J5.2, J6.2; also elsewhere on the board
