dkhorn/organ/kicad/OrganSPIToParallel/OrganSPIToParallel_V001.kicad_pcb

## KiCad design kicad/OrganSPIToParallel/OrganSPIToParallel_V001.kicad_pcb (continued)

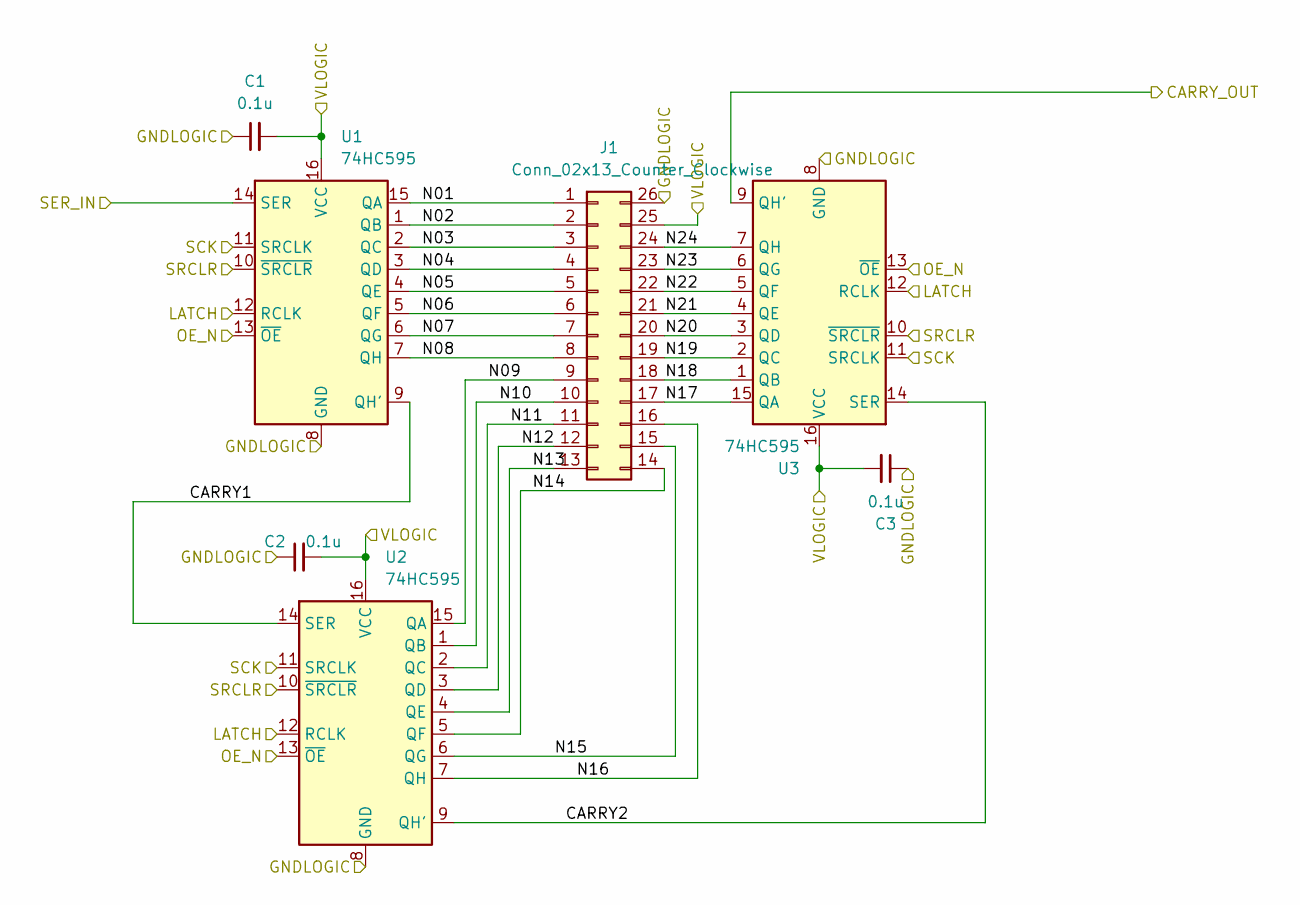
[picture p44: schematic block1.kicad_sch]

Parts:
C1, C2, C3: 0.1u; C_0805_2012Metric
J1: Conn_02x13_Counter_Clockwise; IDC-Header_2x13_P2.54mm_Vertical
U1, U2, U3: 74HC595; SOP-16_3.9x9.9mm_P1.27mm

Connections:
+5V: C1.2, C2.2, C3.2, J1.25, U1.16 (VCC), U2.16 (VCC), U3.16 (VCC); also elsewhere on the board
/block1/CARRY1: U1.9 (QH'), U2.14 (SER)
/block1/CARRY2: U2.9 (QH'), U3.14 (SER)
/block1/CARRY_OUT: U3.9 (QH'); also elsewhere on the board
/block1/N01: J1.1, U1.15 (QA)
/block1/N02: J1.2, U1.1 (QB)
/block1/N03: J1.3, U1.2 (QC)
/block1/N04: J1.4, U1.3 (QD)
/block1/N05: J1.5, U1.4 (QE)
/block1/N06: J1.6, U1.5 (QF)
/block1/N07: J1.7, U1.6 (QG)
/block1/N08: J1.8, U1.7 (QH)
/block1/N09: J1.9, U2.15 (QA)
/block1/N10: J1.10, U2.1 (QB)
/block1/N11: J1.11, U2.2 (QC)
/block1/N12: J1.12, U2.3 (QD)
/block1/N13: J1.13, U2.4 (QE)
/block1/N14: J1.14, U2.5 (QF)
/block1/N15: J1.15, U2.6 (QG)
/block1/N16: J1.16, U2.7 (QH)
/block1/N17: J1.17, U3.15 (QA)
/block1/N18: J1.18, U3.1 (QB)
/block1/N19: J1.19, U3.2 (QC)
/block1/N20: J1.20, U3.3 (QD)
/block1/N21: J1.21, U3.4 (QE)
/block1/N22: J1.22, U3.5 (QF)
/block1/N23: J1.23, U3.6 (QG)
/block1/N24: J1.24, U3.7 (QH)
/block1/SER_IN: U1.14 (SER); also elsewhere on the board
GND: C1.1, C2.1, C3.1, J1.26, U1.8 (GND), U2.8 (GND), U3.8 (GND); also elsewhere on the board
G_LATCH: U1.12 (RCLK), U2.12 (RCLK), U3.12 (RCLK); also elsewhere on the board
G_OE_N: U1.13 (~OE), U2.13 (~OE), U3.13 (~OE); also elsewhere on the board
G_SCK: U1.11 (SRCLK), U2.11 (SRCLK), U3.11 (SRCLK); also elsewhere on the board
G_SRCLR: U1.10 (~SRCLR), U2.10 (~SRCLR), U3.10 (~SRCLR); also elsewhere on the board

Parts of its further copies:
C4, C5, C6: 0.1u; C_0805_2012Metric
J2: Conn_02x13_Counter_Clockwise; IDC-Header_2x13_P2.54mm_Vertical
U4, U5, U6: 74HC595; SOP-16_3.9x9.9mm_P1.27mm

Connections of its further copies:
+5V: C4.2, C5.2, C6.2, J2.25, U4.16 (VCC), U5.16 (VCC), U6.16 (VCC); also elsewhere on the board
/block1/CARRY_OUT: U4.14 (SER); also elsewhere on the board
/block2/CARRY1: U4.9 (QH'), U5.14 (SER)
/block2/CARRY2: U5.9 (QH'), U6.14 (SER)
/block2/N01: J2.1, U4.15 (QA)
/block2/N02: J2.2, U4.1 (QB)
/block2/N03: J2.3, U4.2 (QC)
/block2/N04: J2.4, U4.3 (QD)
/block2/N05: J2.5, U4.4 (QE)
/block2/N06: J2.6, U4.5 (QF)
/block2/N07: J2.7, U4.6 (QG)
/block2/N08: J2.8, U4.7 (QH)
/block2/N09: J2.9, U5.15 (QA)
/block2/N10: J2.10, U5.1 (QB)
/block2/N11: J2.11, U5.2 (QC)
/block2/N12: J2.12, U5.3 (QD)
/block2/N13: J2.13, U5.4 (QE)
/block2/N14: J2.14, U5.5 (QF)
/block2/N15: J2.15, U5.6 (QG)
/block2/N16: J2.16, U5.7 (QH)
/block2/N17: J2.17, U6.15 (QA)
/block2/N18: J2.18, U6.1 (QB)
/block2/N19: J2.19, U6.2 (QC)
/block2/N20: J2.20, U6.3 (QD)
/block2/N21: J2.21, U6.4 (QE)
/block2/N22: J2.22, U6.5 (QF)
/block2/N23: J2.23, U6.6 (QG)
/block2/N24: J2.24, U6.7 (QH)
GND: C4.1, C5.1, C6.1, J2.26, U4.8 (GND), U5.8 (GND), U6.8 (GND); also elsewhere on the board
G_CARRY_OUT: U6.9 (QH'); also elsewhere on the board
G_LATCH: U4.12 (RCLK), U5.12 (RCLK), U6.12 (RCLK); also elsewhere on the board
G_OE_N: U4.13 (~OE), U5.13 (~OE), U6.13 (~OE); also elsewhere on the board
G_SCK: U4.11 (SRCLK), U5.11 (SRCLK), U6.11 (SRCLK); also elsewhere on the board
G_SRCLR: U4.10 (~SRCLR), U5.10 (~SRCLR), U6.10 (~SRCLR); also elsewhere on the board

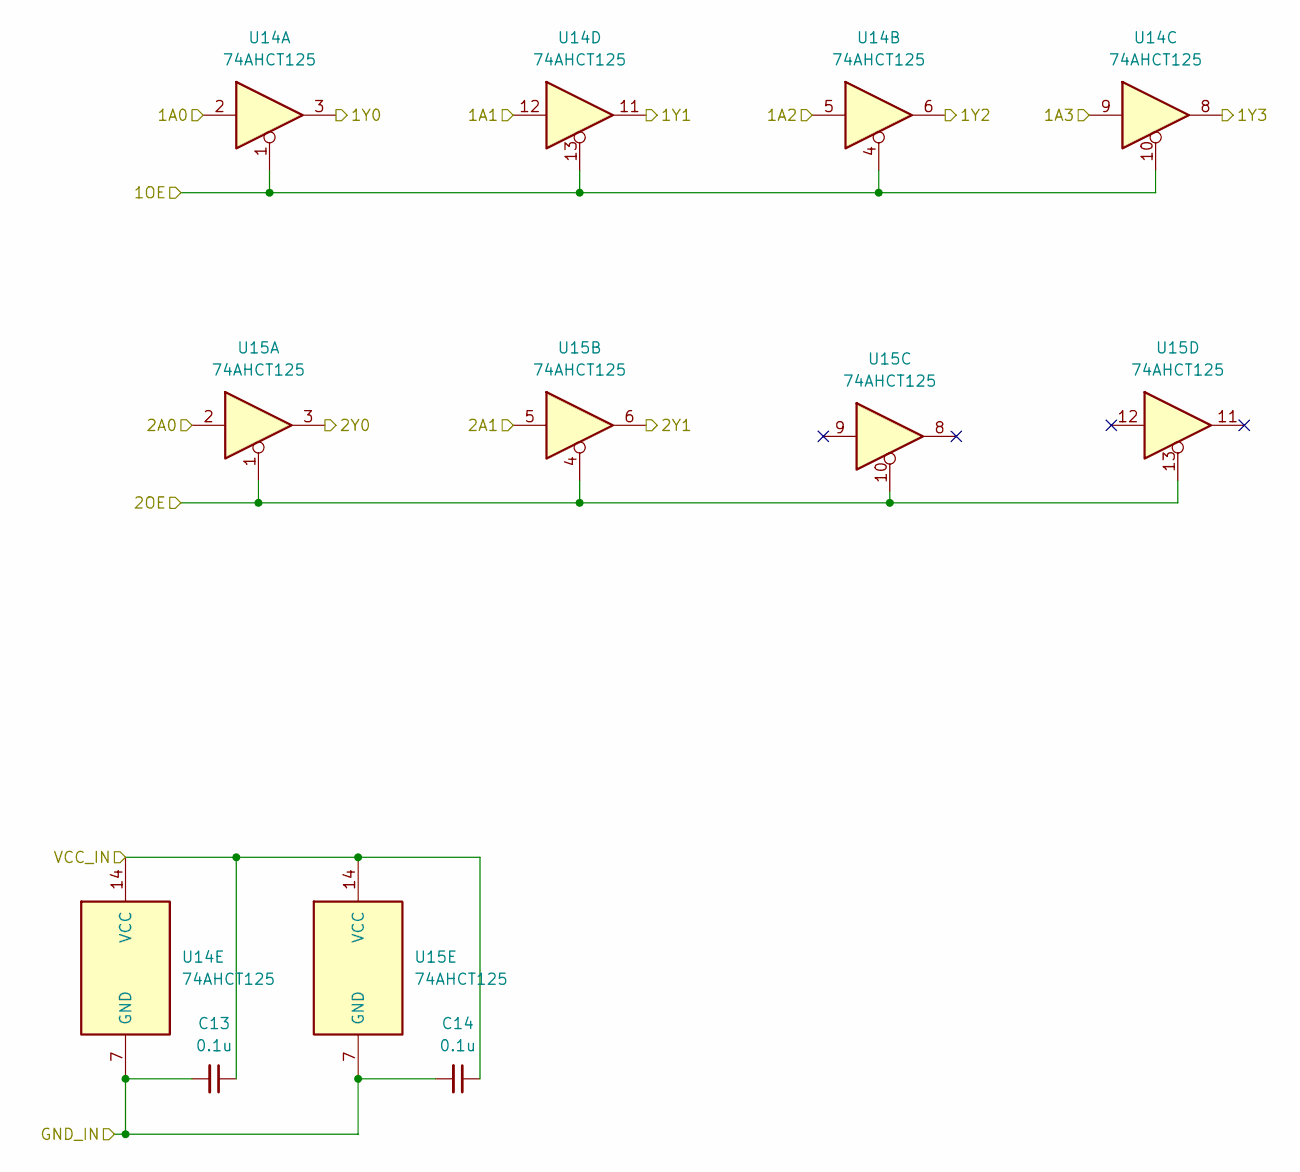
[picture p45: schematic inputBuffer.kicad_sch]

Parts:
C13, C14: 0.1u; C_0805_2012Metric
U14, U15: 74AHCT125; DIP-14_W7.62mm

Connections:
+5V: C13.1, C14.1, U14.14 (VCC), U15.14 (VCC); also elsewhere on the board
/CARRY_IN: U15.5; also elsewhere on the board
/LATCH_IN: U14.9; also elsewhere on the board
/MOSI_IN: U15.2; also elsewhere on the board
/OE_N_IN: U14.5; also elsewhere on the board
/SCK_IN: U14.12; also elsewhere on the board
/SRCLR_IN: U14.2; also elsewhere on the board
GND: C13.2, C14.2, U14.1, U14.4, U14.7 (GND), U14.10, U14.13, U15.1, U15.4, U15.7 (GND), U15.10, U15.13; also elsewhere on the board
G_CARRY_IN: U15.6; also elsewhere on the board
G_LATCH: U14.8; also elsewhere on the board
G_MOSI: U15.3; also elsewhere on the board
G_OE_N: U14.6; also elsewhere on the board
G_SCK: U14.11; also elsewhere on the board
G_SRCLR: U14.3; also elsewhere on the board

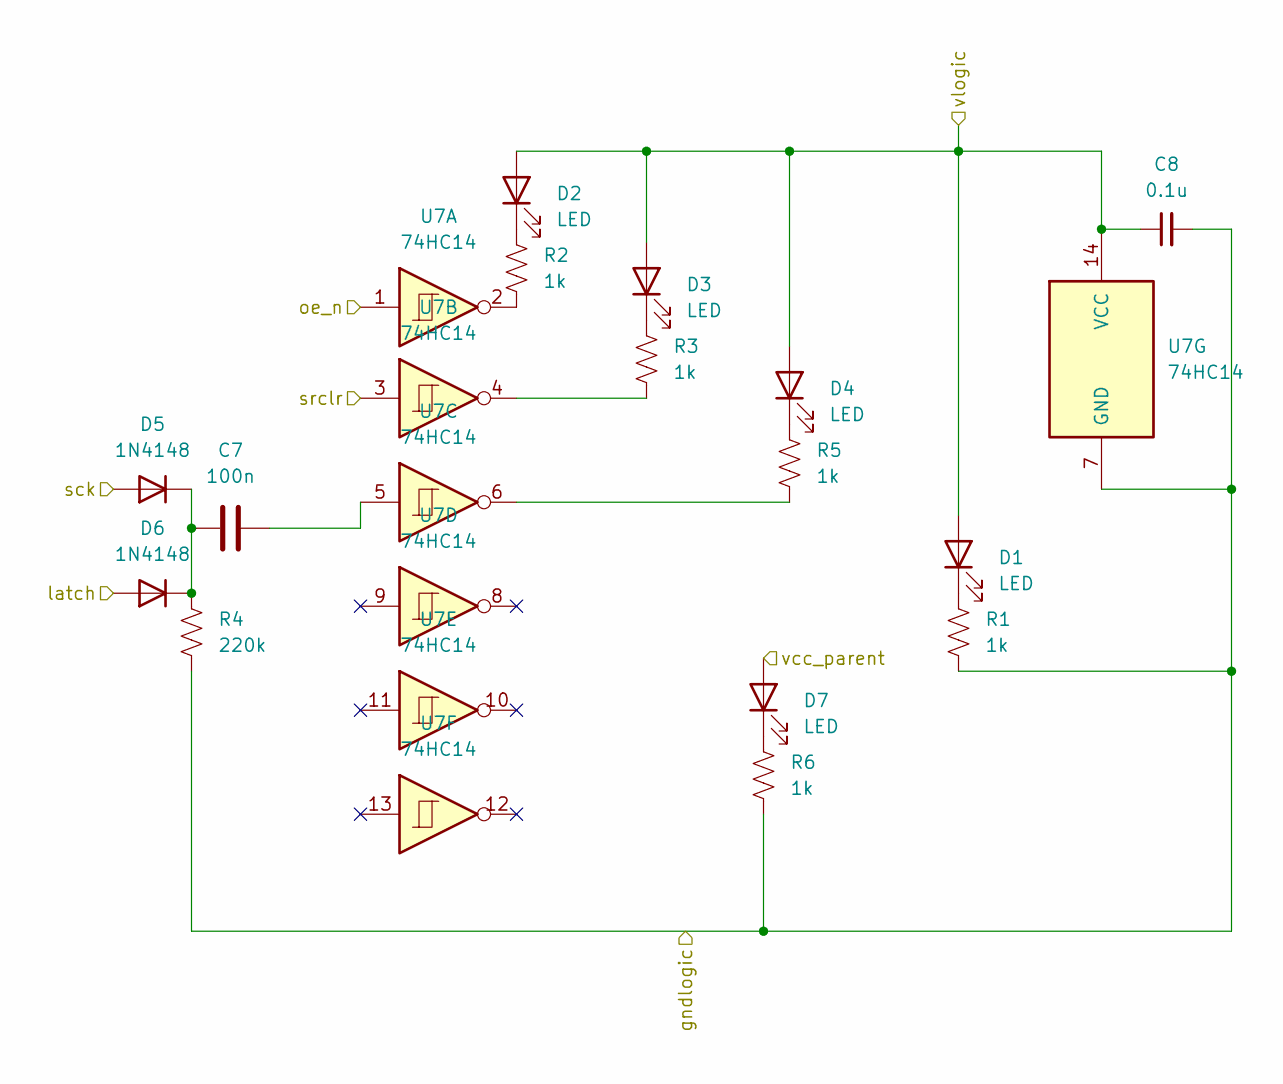
[picture p46: schematic LEDsAndTestpoints.kicad_sch]

Parts:
C7: 100n; C_0805_2012Metric
C8: 0.1u; C_0805_2012Metric
D1, D2, D3, D4, D7: LED; LED_0805_2012Metric
D5, D6: 1N4148; D_0805_2012Metric
R1, R2, R3, R5, R6: 1k; R_0805_2012Metric
R4: 220k; R_0805_2012Metric
U7: 74HC14; SOIC-14_3.9x8.7mm_P1.27mm

Connections:
+5V: C8.1, D1.2 (A), D2.2 (A), D3.2 (A), D4.2 (A), U7.14 (VCC); also elsewhere on the board
GND: C8.2, R1.2, R4.2, R6.2, U7.7 (GND); also elsewhere on the board
G_LATCH: D6.2 (A); also elsewhere on the board
G_OE_N: U7.1; also elsewhere on the board
G_SCK: D5.2 (A); also elsewhere on the board
G_SRCLR: U7.3; also elsewhere on the board
unnamed: C7.2, U7.5
unnamed: D1.1 (K), R1.1
unnamed: D2.1 (K), R2.1
unnamed: D3.1 (K), R3.1
unnamed: D4.1 (K), R5.1
unnamed: C7.1, D5.1 (K), D6.1 (K), R4.1
unnamed: D7.1 (K), R6.1
unnamed: R2.2, U7.2
unnamed: R3.2, U7.4
unnamed: R5.2, U7.6
VCC_PARENT: D7.2 (A); also elsewhere on the board

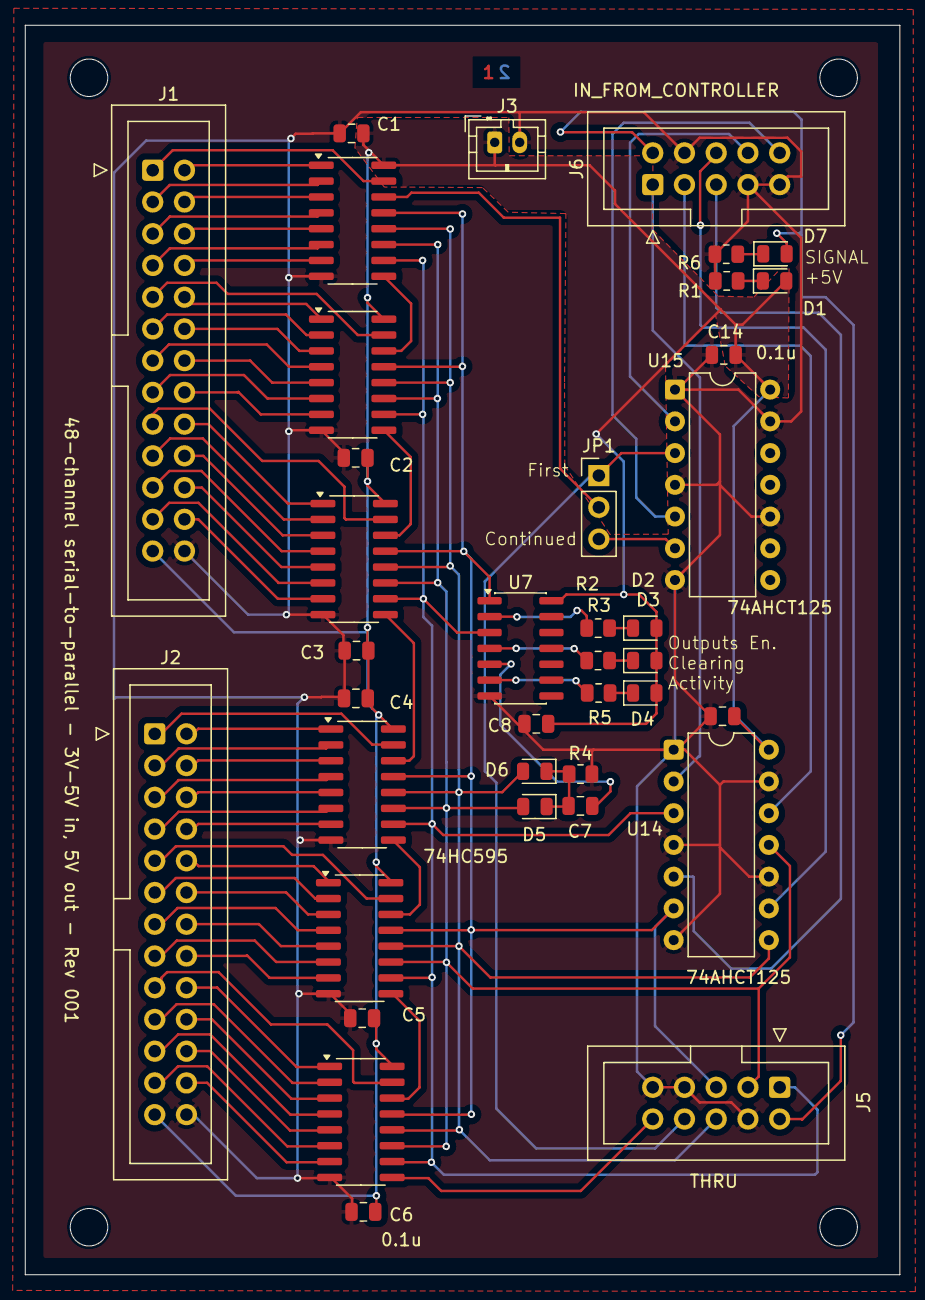
[picture p47: board OrganSPIToParallel_V001.kicad_pcb from above]

Board: 2 copper layers, 70.0 x 100.0 mm, 38 parts (0 on the bottom side), 80 nets.
