dkhorn/organ/kicad/OrganEsp32ParallelOut/OrganEsp32ParallelOut.kicad_pcb

## KiCad design kicad/OrganEsp32ParallelOut/OrganEsp32ParallelOut.kicad_pcb (2025-11-23)

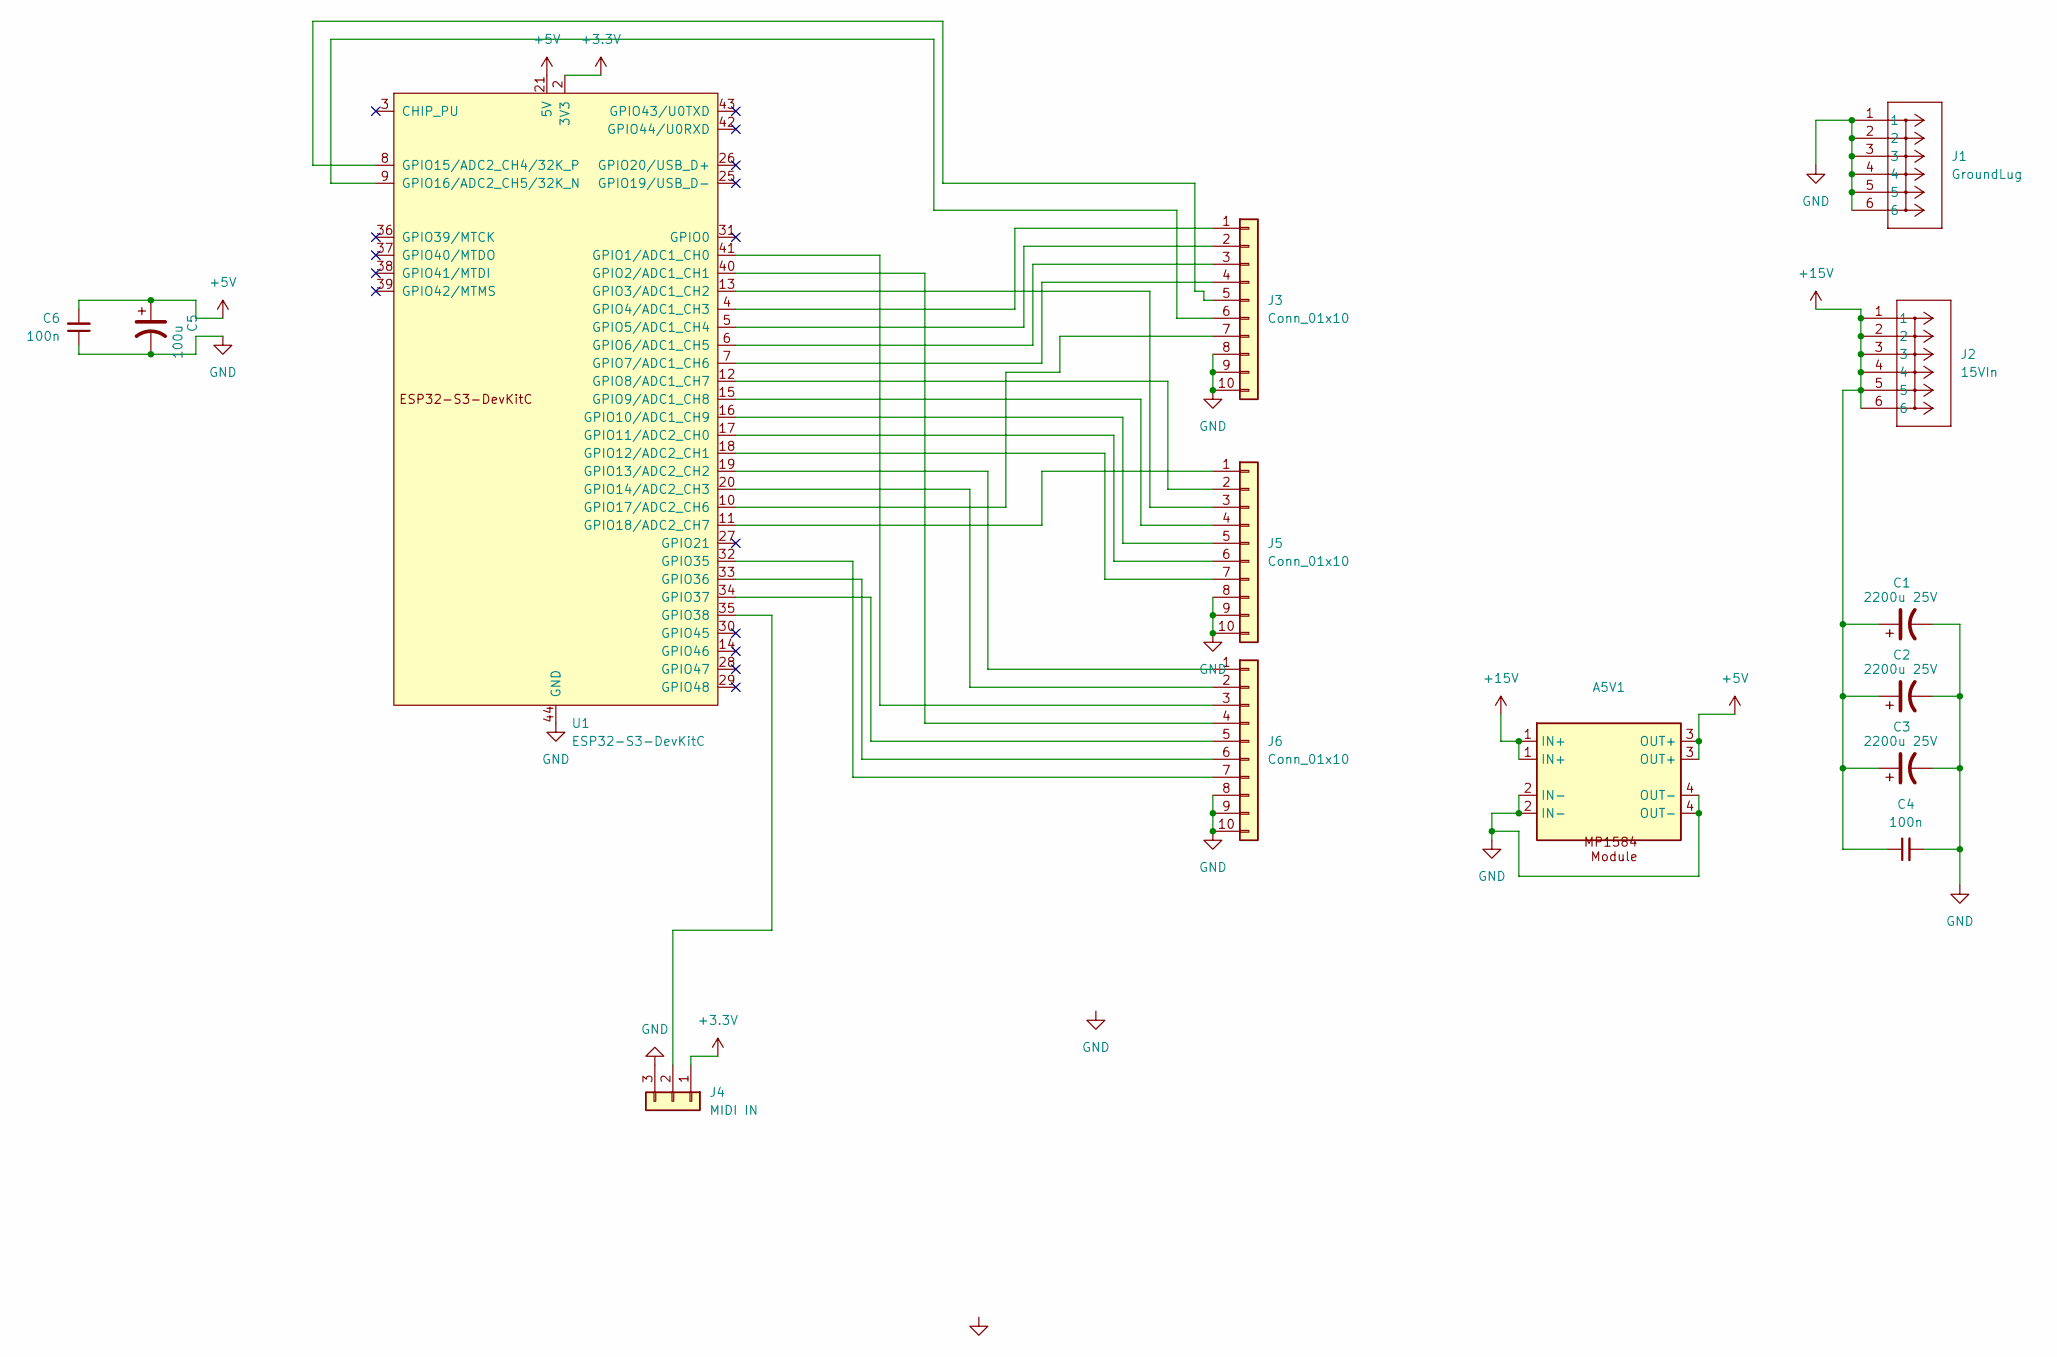
[picture p48: schematic OrganEsp32ParallelOut.kicad_sch]

Parts:
A5V1: MP1584_Module
C1, C2, C3: 2200u 25V; CP_Radial_D10.0mm_P5.00mm
C4, C6: 100n; C_Disc_D4.3mm_W1.9mm_P5.00mm
C5: 100u; CP_Radial_D5.0mm_P2.00mm
J1: GroundLug; CONN_8199_KEY
J2: 15VIn; CONN_8199_KEY
J3, J5, J6: Conn_01x10; IDC-Header_2x05_P2.54mm_Vertical
J4: MIDI IN; JST_PH_B3B-PH-K_1x03_P2.00mm_Vertical
U1: ESP32-S3-DevKitC

Connections:
+3.3V: J4.1, U1.1 (3V3), U1.2 (3V3)
+5V: A5V1.3 (OUT+), C5.1, C6.2, U1.21 (5V)
+15V: A5V1.1 (IN+), C1.1, C2.1, C3.1, C4.1, J2.1, J2.2, J2.3, J2.4, J2.5, J2.6
GND: A5V1.2 (IN-), A5V1.4 (OUT-), C1.2, C2.2, C3.2, C4.2, C5.2, C6.1, J1.1, J1.2, J1.3, J1.4, J1.5, J1.6, J3.8, J3.9, J3.10, J4.3, J5.8, J5.9, J5.10, J6.8, J6.9, J6.10, U1.22 (GND), U1.23 (GND), U1.24 (GND), U1.44 (GND)
unnamed: J3.1, U1.4 (GPIO4/ADC1_CH3)
unnamed: J3.2, U1.5 (GPIO5/ADC1_CH4)
unnamed: J3.3, U1.6 (GPIO6/ADC1_CH5)
unnamed: J3.4, U1.7 (GPIO7/ADC1_CH6)
unnamed: J3.5, U1.8 (GPIO15/ADC2_CH4/32K_P)
unnamed: J3.6, U1.9 (GPIO16/ADC2_CH5/32K_N)
unnamed: J3.7, U1.10 (GPIO17/ADC2_CH6)
unnamed: J4.2, U1.35 (GPIO38)
unnamed: J5.1, U1.11 (GPIO18/ADC2_CH7)
unnamed: J5.2, U1.12 (GPIO8/ADC1_CH7)
unnamed: J5.3, U1.13 (GPIO3/ADC1_CH2)
unnamed: J5.4, U1.15 (GPIO9/ADC1_CH8)
unnamed: J5.5, U1.16 (GPIO10/ADC1_CH9)
unnamed: J5.6, U1.17 (GPIO11/ADC2_CH0)
unnamed: J5.7, U1.18 (GPIO12/ADC2_CH1)
unnamed: J6.1, U1.19 (GPIO13/ADC2_CH2)
unnamed: J6.2, U1.20 (GPIO14/ADC2_CH3)
unnamed: J6.3, U1.41 (GPIO1/ADC1_CH0)
unnamed: J6.4, U1.40 (GPIO2/ADC1_CH1)
unnamed: J6.5, U1.34 (GPIO37)
unnamed: J6.6, U1.33 (GPIO36)
unnamed: J6.7, U1.32 (GPIO35)

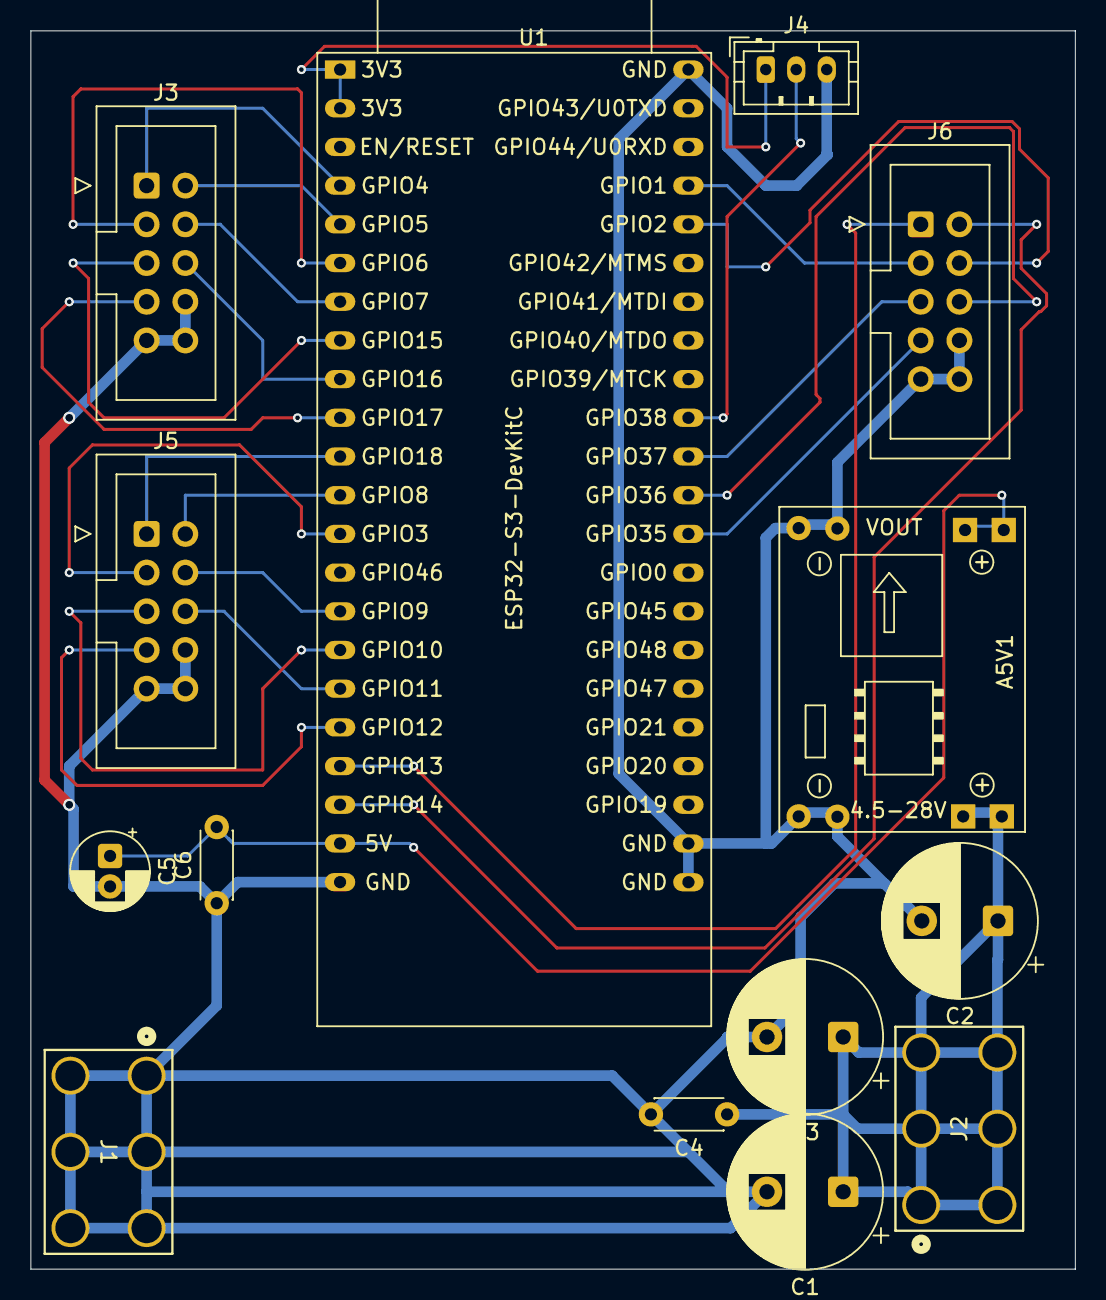
[picture p49: board OrganEsp32ParallelOut.kicad_pcb from above]

Board: 2 copper layers, 68.6 x 81.3 mm, 14 parts (0 on the bottom side), 26 nets.
