dkhorn/organ/kicad/OrganLEDArray/OrganLEDArray.kicad_pcb

## KiCad design kicad/OrganLEDArray/OrganLEDArray.kicad_pcb (2025-11-23)

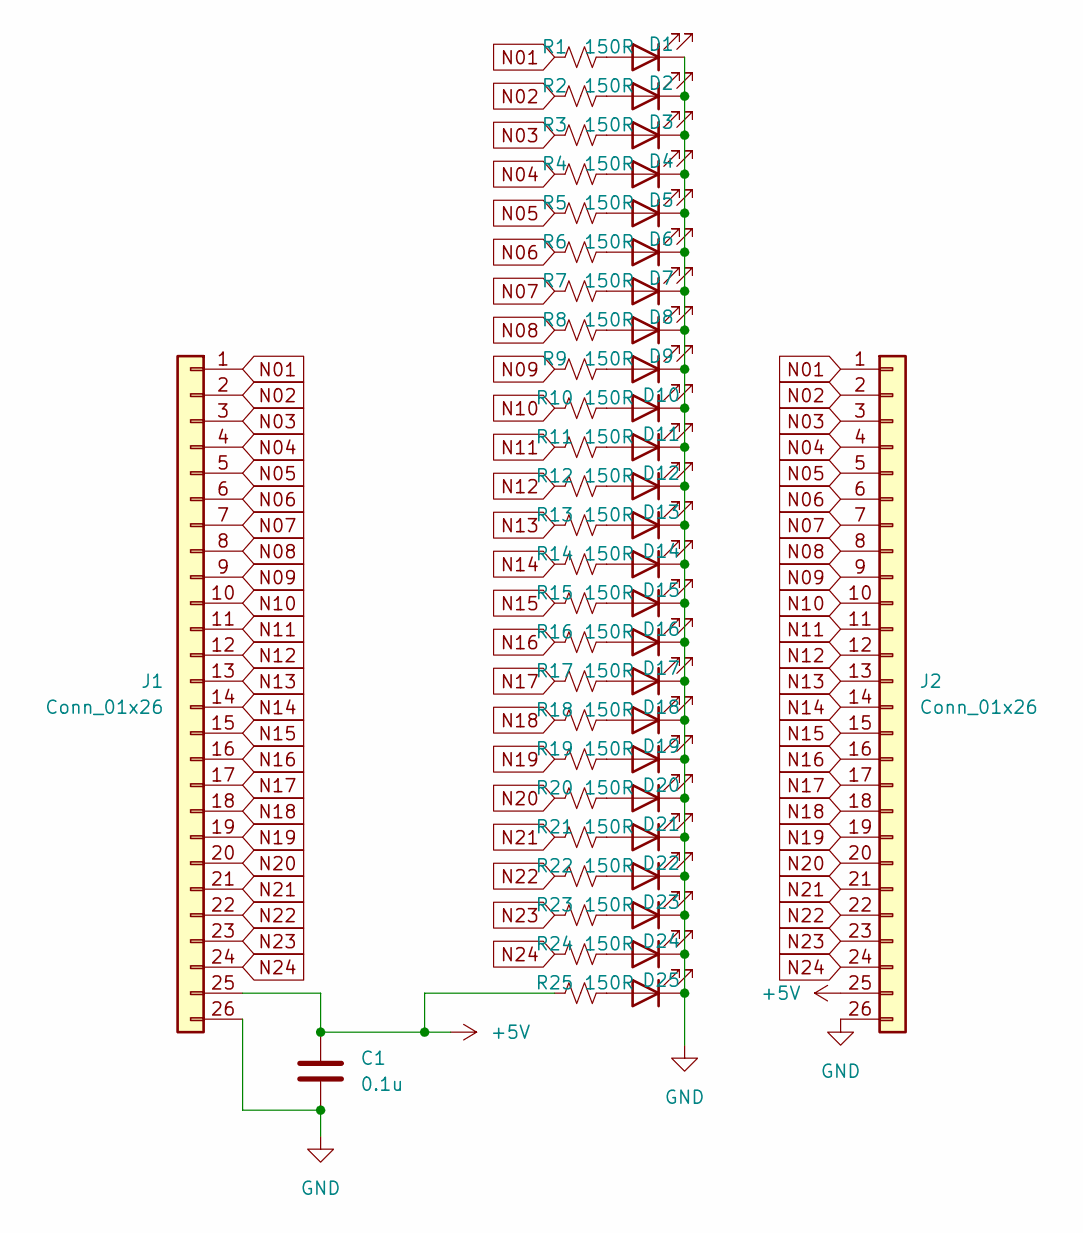
[picture p50: schematic OrganLEDArray.kicad_sch]

Parts:
C1: 0.1u; C_0603_1608Metric
D1, D2, D3, D4, D5, D6, D7, D8, D9, D10, D11, D12, D13, D14, D15, D16, D17, D18, D19, D20, D21, D22, D23, D24, D25: LED; LED_0603_1608Metric
J1, J2: Conn_01x26; IDC-Header_2x13_P2.54mm_Vertical
R1, R2, R3, R4, R5, R6, R7, R8, R9, R10, R11, R12, R13, R14, R15, R16, R17, R18, R19, R20, R21, R22, R23, R24, R25: 150R; R_0603_1608Metric

Connections:
+5V: C1.1, J1.25, J2.25, R25.1
GND: C1.2, D1.1 (K), D2.1 (K), D3.1 (K), D4.1 (K), D5.1 (K), D6.1 (K), D7.1 (K), D8.1 (K), D9.1 (K), D10.1 (K), D11.1 (K), D12.1 (K), D13.1 (K), D14.1 (K), D15.1 (K), D16.1 (K), D17.1 (K), D18.1 (K), D19.1 (K), D20.1 (K), D21.1 (K), D22.1 (K), D23.1 (K), D24.1 (K), D25.1 (K), J1.26, J2.26
N01: J1.1, J2.1, R1.1; also elsewhere on the board
N02: J1.2, J2.2, R2.1
N03: J1.3, J2.3, R3.1
N04: J1.4, J2.4, R4.1
N05: J1.5, J2.5, R5.1
N06: J1.6, J2.6, R6.1
N07: J1.7, J2.7, R7.1
N08: J1.8, J2.8, R8.1
N09: J1.9, J2.9, R9.1
N10: J1.10, J2.10, R10.1
N11: J1.11, J2.11, R11.1
N12: J1.12, J2.12, R12.1
N13: J1.13, J2.13, R13.1
N14: J1.14, J2.14, R14.1
N15: J1.15, J2.15, R15.1
N16: J1.16, J2.16, R16.1
N17: J1.17, J2.17, R17.1
N18: J1.18, J2.18, R18.1
N19: J1.19, J2.19, R19.1
N20: J1.20, J2.20, R20.1
N21: J1.21, J2.21, R21.1
N22: J1.22, J2.22, R22.1
N23: J1.23, J2.23, R23.1
N24: J1.24, J2.24, R24.1
unnamed 26: D1.2 (A), R1.2; also elsewhere on the board
unnamed: D2.2 (A), R2.2
unnamed: D3.2 (A), R3.2
unnamed: D4.2 (A), R4.2
unnamed: D5.2 (A), R5.2
unnamed: D6.2 (A), R6.2
unnamed: D7.2 (A), R7.2
unnamed: D8.2 (A), R8.2
unnamed: D9.2 (A), R9.2
unnamed: D10.2 (A), R10.2
unnamed: D11.2 (A), R11.2
unnamed: D12.2 (A), R12.2
unnamed: D13.2 (A), R13.2
unnamed: D14.2 (A), R14.2
unnamed: D15.2 (A), R15.2
unnamed: D16.2 (A), R16.2
unnamed: D17.2 (A), R17.2
unnamed: D18.2 (A), R18.2
unnamed: D19.2 (A), R19.2
unnamed: D20.2 (A), R20.2
unnamed: D21.2 (A), R21.2
unnamed: D22.2 (A), R22.2
unnamed: D23.2 (A), R23.2
unnamed: D24.2 (A), R24.2
unnamed: D25.2 (A), R25.2

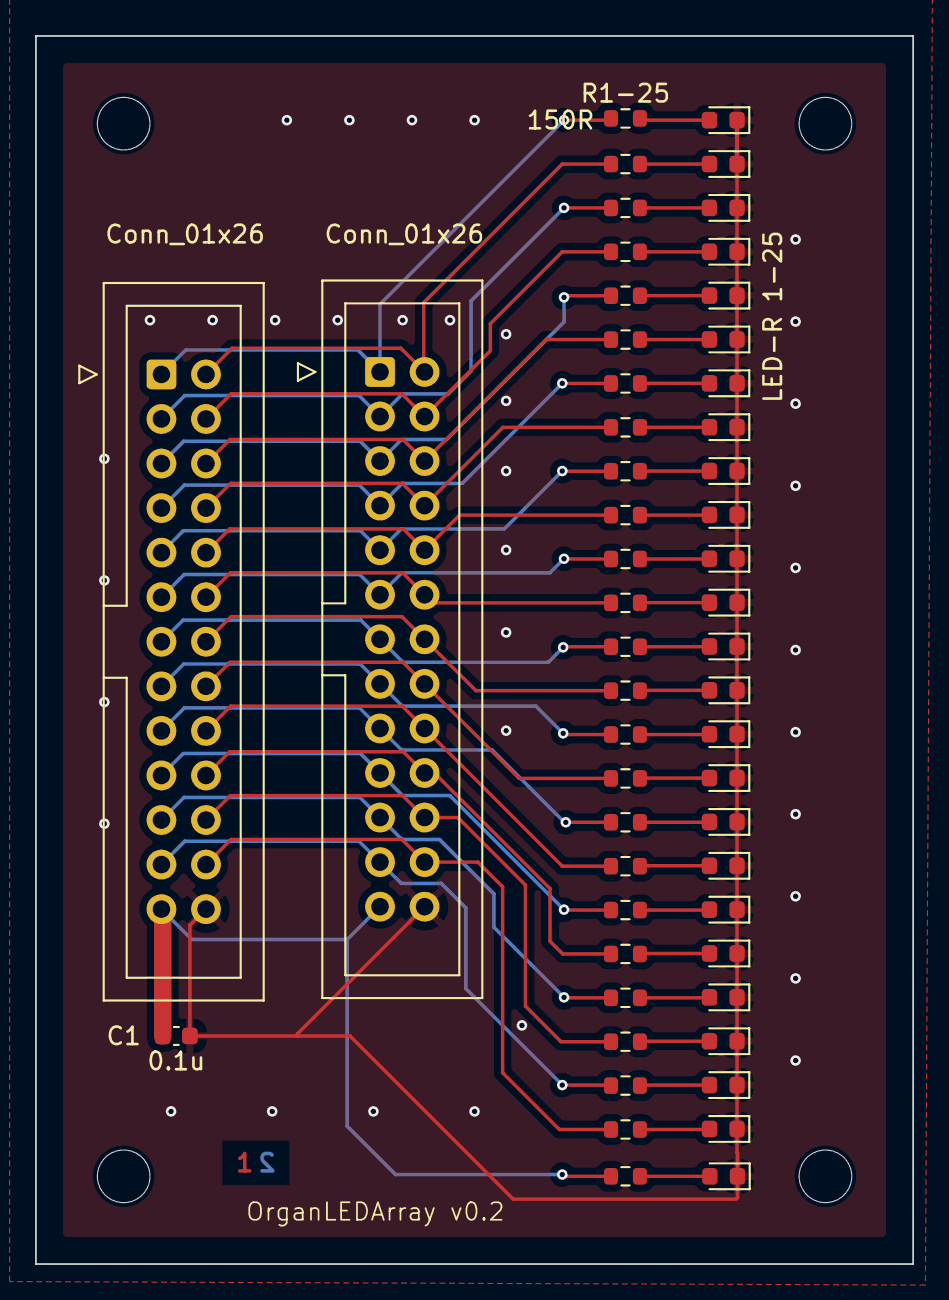
[picture p51: board OrganLEDArray.kicad_pcb from above]

Board: 2 copper layers, 50.0 x 70.0 mm, 53 parts (0 on the bottom side), 51 nets.

Other parts of the board:
R1-25: 150R; R_0603_1608Metric

Their connections:
N01: R1-25.1; also elsewhere on the board
unnamed 26: R1-25.2; also elsewhere on the board
