dkhorn/organ/kicad/OrganMosfetArray/OrganMosfetArray.kicad_pcb

## KiCad design kicad/OrganMosfetArray/OrganMosfetArray.kicad_pcb (2025-11-23)

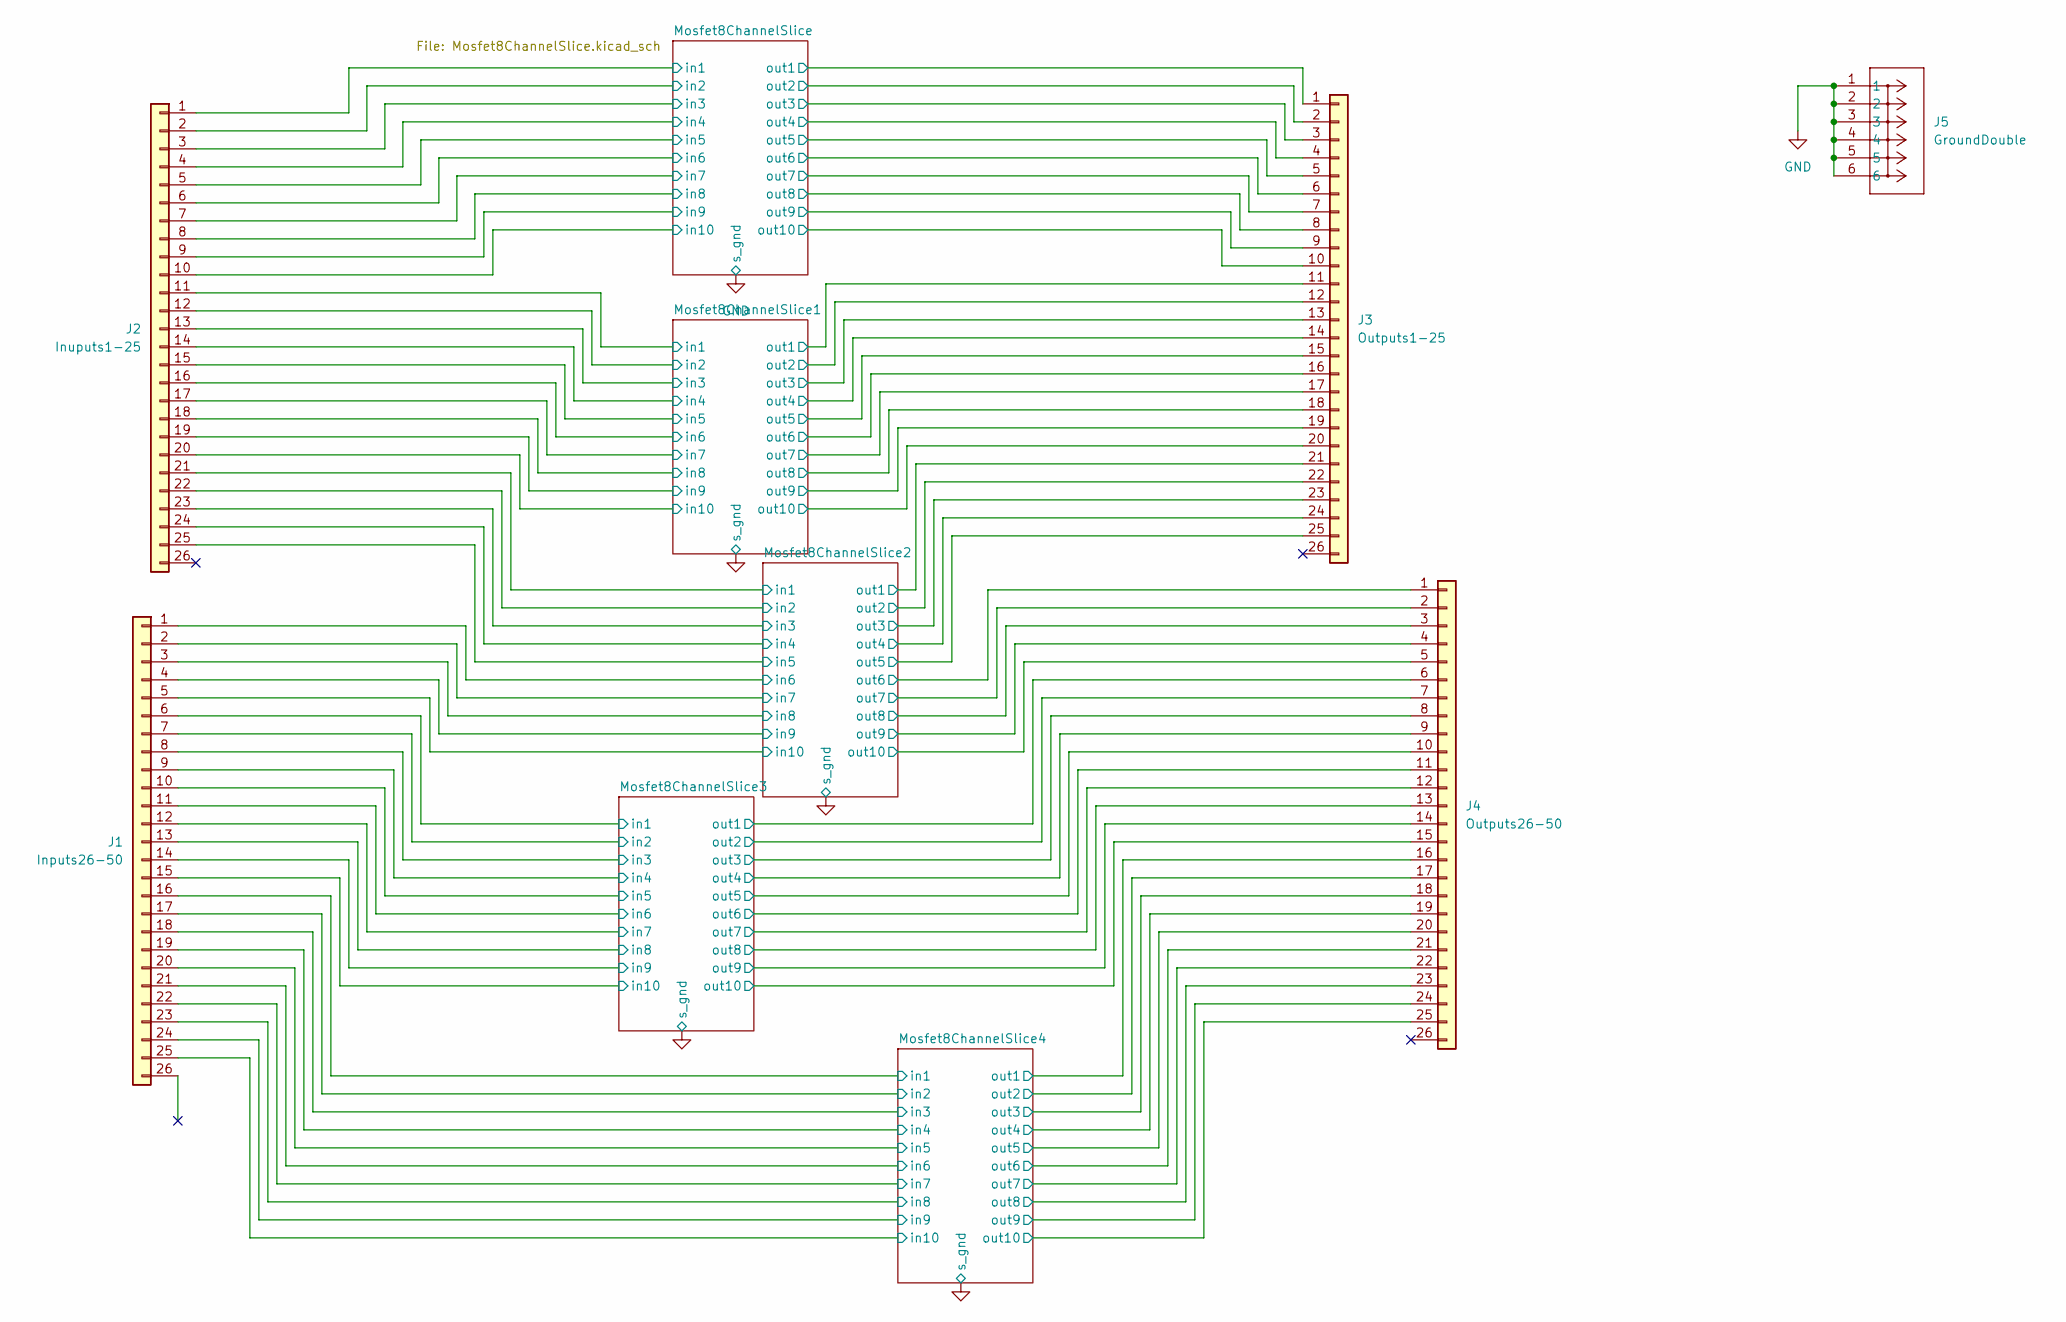
[picture p52: schematic OrganMosfetArray.kicad_sch]

Parts:
J1: Inputs26-50; IDC-Header_2x13_P2.54mm_Vertical
J2: Inuputs1-25; IDC-Header_2x13_P2.54mm_Vertical
J3: Outputs1-25; IDC-Header_2x13_P2.54mm_Vertical
J4: Outputs26-50; IDC-Header_2x13_P2.54mm_Vertical
J5: GroundDouble; CONN_8199_KEY

Connections:
/Mosfet8ChannelSlice1/in1: J2.11; also elsewhere on the board
/Mosfet8ChannelSlice1/in2: J2.12; also elsewhere on the board
/Mosfet8ChannelSlice1/in3: J2.13; also elsewhere on the board
/Mosfet8ChannelSlice1/in4: J2.14; also elsewhere on the board
/Mosfet8ChannelSlice1/in5: J2.15; also elsewhere on the board
/Mosfet8ChannelSlice1/in6: J2.16; also elsewhere on the board
/Mosfet8ChannelSlice1/in7: J2.17; also elsewhere on the board
/Mosfet8ChannelSlice1/in8: J2.18; also elsewhere on the board
/Mosfet8ChannelSlice1/in9: J2.19; also elsewhere on the board
/Mosfet8ChannelSlice1/in10: J2.20; also elsewhere on the board
/Mosfet8ChannelSlice1/out1: J3.11; also elsewhere on the board
/Mosfet8ChannelSlice1/out2: J3.12; also elsewhere on the board
/Mosfet8ChannelSlice1/out3: J3.13; also elsewhere on the board
/Mosfet8ChannelSlice1/out4: J3.14; also elsewhere on the board
/Mosfet8ChannelSlice1/out5: J3.15; also elsewhere on the board
/Mosfet8ChannelSlice1/out6: J3.16; also elsewhere on the board
/Mosfet8ChannelSlice1/out7: J3.17; also elsewhere on the board
/Mosfet8ChannelSlice1/out8: J3.18; also elsewhere on the board
/Mosfet8ChannelSlice1/out9: J3.19; also elsewhere on the board
/Mosfet8ChannelSlice1/out10: J3.20; also elsewhere on the board
/Mosfet8ChannelSlice2/in1: J2.21; also elsewhere on the board
/Mosfet8ChannelSlice2/in2: J2.22; also elsewhere on the board
/Mosfet8ChannelSlice2/in3: J2.23; also elsewhere on the board
/Mosfet8ChannelSlice2/in4: J2.24; also elsewhere on the board
/Mosfet8ChannelSlice2/in5: J2.25; also elsewhere on the board
/Mosfet8ChannelSlice2/in6: J1.1; also elsewhere on the board
/Mosfet8ChannelSlice2/in7: J1.2; also elsewhere on the board
/Mosfet8ChannelSlice2/in8: J1.3; also elsewhere on the board
/Mosfet8ChannelSlice2/in9: J1.4; also elsewhere on the board
/Mosfet8ChannelSlice2/in10: J1.5; also elsewhere on the board
/Mosfet8ChannelSlice2/out1: J3.21; also elsewhere on the board
/Mosfet8ChannelSlice2/out2: J3.22; also elsewhere on the board
/Mosfet8ChannelSlice2/out3: J3.23; also elsewhere on the board
/Mosfet8ChannelSlice2/out4: J3.24; also elsewhere on the board
/Mosfet8ChannelSlice2/out5: J3.25; also elsewhere on the board
/Mosfet8ChannelSlice2/out6: J4.1; also elsewhere on the board
/Mosfet8ChannelSlice2/out7: J4.2; also elsewhere on the board
/Mosfet8ChannelSlice2/out8: J4.3; also elsewhere on the board
/Mosfet8ChannelSlice2/out9: J4.4; also elsewhere on the board
/Mosfet8ChannelSlice2/out10: J4.5; also elsewhere on the board
/Mosfet8ChannelSlice3/in1: J1.6; also elsewhere on the board
/Mosfet8ChannelSlice3/in2: J1.7; also elsewhere on the board
/Mosfet8ChannelSlice3/in3: J1.8; also elsewhere on the board
/Mosfet8ChannelSlice3/in4: J1.9; also elsewhere on the board
/Mosfet8ChannelSlice3/in5: J1.10; also elsewhere on the board
/Mosfet8ChannelSlice3/in6: J1.11; also elsewhere on the board
/Mosfet8ChannelSlice3/in7: J1.12; also elsewhere on the board
/Mosfet8ChannelSlice3/in8: J1.13; also elsewhere on the board
/Mosfet8ChannelSlice3/in9: J1.14; also elsewhere on the board
/Mosfet8ChannelSlice3/in10: J1.15; also elsewhere on the board
/Mosfet8ChannelSlice3/out1: J4.6; also elsewhere on the board
/Mosfet8ChannelSlice3/out2: J4.7; also elsewhere on the board
/Mosfet8ChannelSlice3/out3: J4.8; also elsewhere on the board
/Mosfet8ChannelSlice3/out4: J4.9; also elsewhere on the board
/Mosfet8ChannelSlice3/out5: J4.10; also elsewhere on the board
/Mosfet8ChannelSlice3/out6: J4.11; also elsewhere on the board
/Mosfet8ChannelSlice3/out7: J4.12; also elsewhere on the board
/Mosfet8ChannelSlice3/out8: J4.13; also elsewhere on the board
/Mosfet8ChannelSlice3/out9: J4.14; also elsewhere on the board
/Mosfet8ChannelSlice3/out10: J4.15; also elsewhere on the board
/Mosfet8ChannelSlice4/in1: J1.16; also elsewhere on the board
/Mosfet8ChannelSlice4/in2: J1.17; also elsewhere on the board
/Mosfet8ChannelSlice4/in3: J1.18; also elsewhere on the board
/Mosfet8ChannelSlice4/in4: J1.19; also elsewhere on the board
/Mosfet8ChannelSlice4/in5: J1.20; also elsewhere on the board
/Mosfet8ChannelSlice4/in6: J1.21; also elsewhere on the board
/Mosfet8ChannelSlice4/in7: J1.22; also elsewhere on the board
/Mosfet8ChannelSlice4/in8: J1.23; also elsewhere on the board
/Mosfet8ChannelSlice4/in9: J1.24; also elsewhere on the board
/Mosfet8ChannelSlice4/in10: J1.25; also elsewhere on the board
/Mosfet8ChannelSlice4/out1: J4.16; also elsewhere on the board
/Mosfet8ChannelSlice4/out2: J4.17; also elsewhere on the board
/Mosfet8ChannelSlice4/out3: J4.18; also elsewhere on the board
/Mosfet8ChannelSlice4/out4: J4.19; also elsewhere on the board
/Mosfet8ChannelSlice4/out5: J4.20; also elsewhere on the board
/Mosfet8ChannelSlice4/out6: J4.21; also elsewhere on the board
/Mosfet8ChannelSlice4/out7: J4.22; also elsewhere on the board
/Mosfet8ChannelSlice4/out8: J4.23; also elsewhere on the board
/Mosfet8ChannelSlice4/out9: J4.24; also elsewhere on the board
/Mosfet8ChannelSlice4/out10: J4.25; also elsewhere on the board
/Mosfet8ChannelSlice/in1: J2.1; also elsewhere on the board
/Mosfet8ChannelSlice/in2: J2.2; also elsewhere on the board
/Mosfet8ChannelSlice/in3: J2.3; also elsewhere on the board
/Mosfet8ChannelSlice/in4: J2.4; also elsewhere on the board
/Mosfet8ChannelSlice/in5: J2.5; also elsewhere on the board
/Mosfet8ChannelSlice/in6: J2.6; also elsewhere on the board
/Mosfet8ChannelSlice/in7: J2.7; also elsewhere on the board
/Mosfet8ChannelSlice/in8: J2.8; also elsewhere on the board
/Mosfet8ChannelSlice/in9: J2.9; also elsewhere on the board
/Mosfet8ChannelSlice/in10: J2.10; also elsewhere on the board
/Mosfet8ChannelSlice/out1: J3.1; also elsewhere on the board
/Mosfet8ChannelSlice/out2: J3.2; also elsewhere on the board
/Mosfet8ChannelSlice/out3: J3.3; also elsewhere on the board
/Mosfet8ChannelSlice/out4: J3.4; also elsewhere on the board
/Mosfet8ChannelSlice/out5: J3.5; also elsewhere on the board
/Mosfet8ChannelSlice/out6: J3.6; also elsewhere on the board
/Mosfet8ChannelSlice/out7: J3.7; also elsewhere on the board
/Mosfet8ChannelSlice/out8: J3.8; also elsewhere on the board
/Mosfet8ChannelSlice/out9: J3.9; also elsewhere on the board
/Mosfet8ChannelSlice/out10: J3.10; also elsewhere on the board
GND: J5.1, J5.2, J5.3, J5.4, J5.5, J5.6; also elsewhere on the board

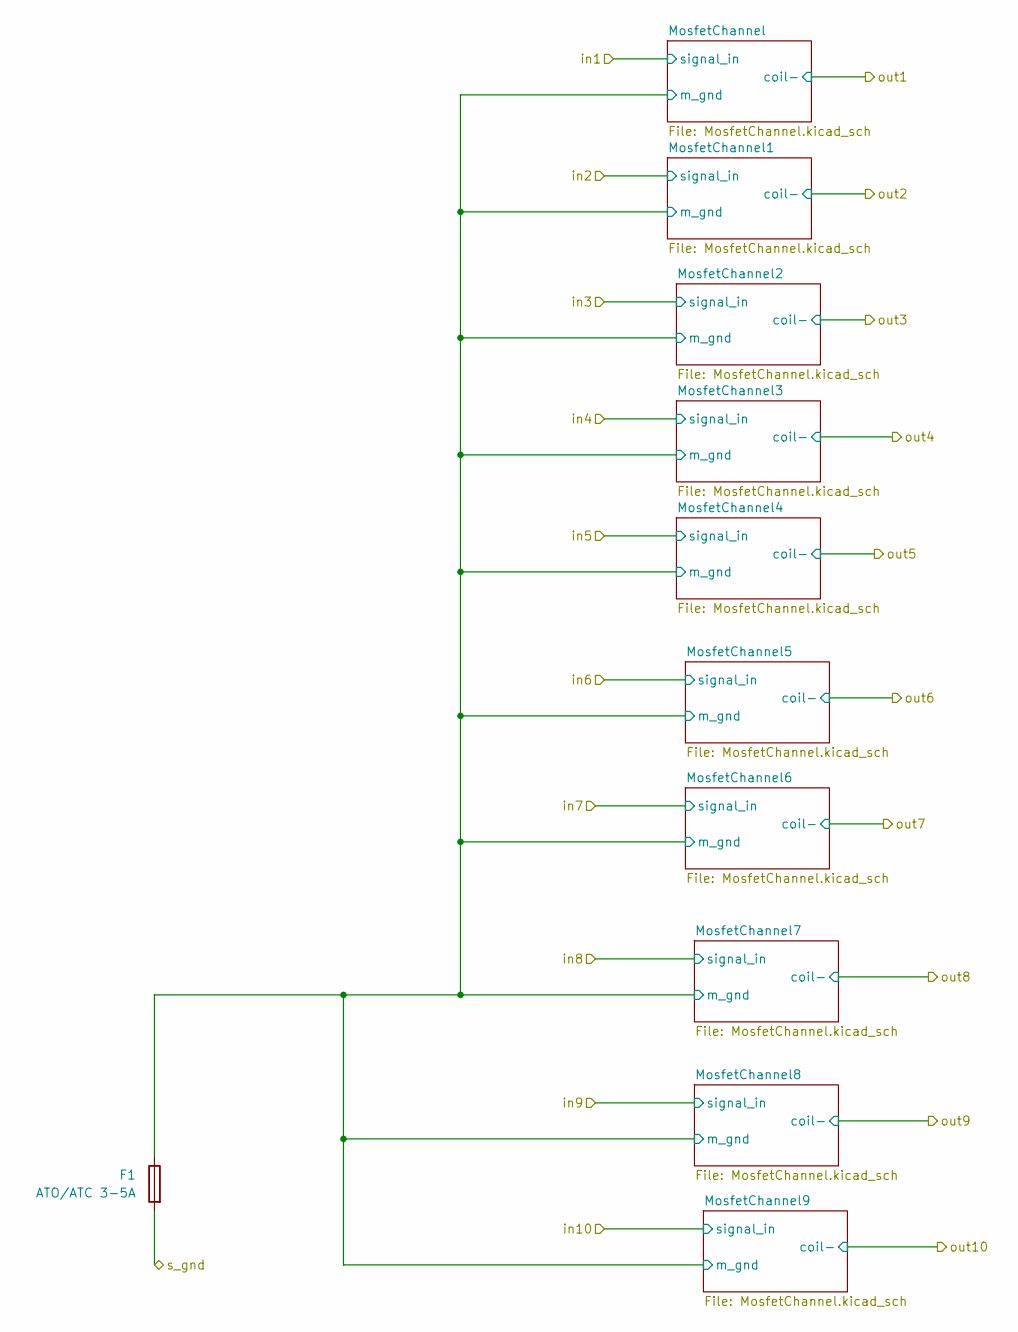
[picture p53: schematic Mosfet8ChannelSlice.kicad_sch]

Parts:
F1: ATO/ATC 3-5A; AliExpressFuseHolder

Connections:
/Mosfet8ChannelSlice/MosfetChannel/m_gnd: F1.1; also elsewhere on the board
GND: F1.2; also elsewhere on the board

Parts of its further copies:
F2, F3, F4, F5: ATO/ATC 3-5A; AliExpressFuseHolder

Connections of its further copies:
/Mosfet8ChannelSlice1/MosfetChannel/m_gnd: F2.1; also elsewhere on the board
/Mosfet8ChannelSlice2/MosfetChannel/m_gnd: F3.1; also elsewhere on the board
/Mosfet8ChannelSlice3/MosfetChannel/m_gnd: F4.1; also elsewhere on the board
/Mosfet8ChannelSlice4/MosfetChannel/m_gnd: F5.1; also elsewhere on the board
GND: F2.2, F3.2, F4.2, F5.2; also elsewhere on the board

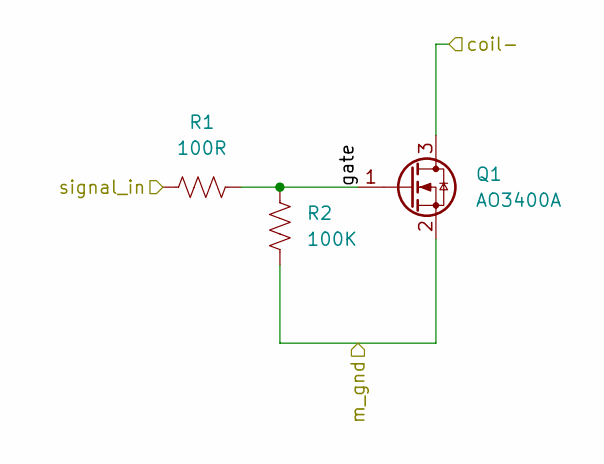
[picture p54: schematic MosfetChannel.kicad_sch]

Parts:
Q1: AO3400A; SOT-23
R1: 100R; R_0603_1608Metric
R2: 100K; R_0603_1608Metric

Connections:
/Mosfet8ChannelSlice/MosfetChannel/gate: Q1.1 (G), R1.2, R2.1
/Mosfet8ChannelSlice/MosfetChannel/m_gnd: Q1.2 (S), R2.2; also elsewhere on the board
/Mosfet8ChannelSlice/in1: R1.1; also elsewhere on the board
/Mosfet8ChannelSlice/out1: Q1.3 (D); also elsewhere on the board

Parts of its further copies:
Q2, Q3, Q4, Q5, Q6, Q7, Q8, Q9, Q10, Q11, Q12, Q13, Q14, Q15, Q16, Q17, Q18, Q19, Q20, Q21, Q22, Q23, Q24, Q25, Q26, Q27, Q28, Q29, Q30, Q31, Q32, Q33, Q34, Q35, Q36, Q37, Q38, Q39, Q40, Q41, Q42, Q43, Q44, Q45, Q46, Q47, Q48, Q49, Q50: AO3400A; SOT-23
R3, R5, R7, R9, R11, R13, R15, R17, R19, R21, R23, R25, R27, R29, R31, R33, R35, R37, R39, R41, R43, R45, R47, R49, R51, R53, R55, R57, R59, R61, R63, R65, R67, R69, R71, R73, R75, R77, R79, R81, R83, R85, R87, R89, R91, R93, R95, R97, R99: 100R; R_0603_1608Metric
R4, R6, R8, R10, R12, R14, R16, R18, R20, R22, R24, R26, R28, R30, R32, R34, R36, R38, R40, R42, R44, R46, R48, R50, R52, R54, R56, R58, R60, R62, R64, R66, R68, R70, R72, R74, R76, R78, R80, R82, R84, R86, R88, R90, R92, R94, R96, R98, R100: 100K; R_0603_1608Metric

Connections of its further copies:
/Mosfet8ChannelSlice1/MosfetChannel1/gate: Q11.1 (G), R21.2, R22.1
/Mosfet8ChannelSlice1/MosfetChannel2/gate: Q10.1 (G), R19.2, R20.1
/Mosfet8ChannelSlice1/MosfetChannel3/gate: Q9.1 (G), R17.2, R18.1
/Mosfet8ChannelSlice1/MosfetChannel4/gate: Q14.1 (G), R27.2, R28.1
/Mosfet8ChannelSlice1/MosfetChannel5/gate: Q12.1 (G), R23.2, R24.1
/Mosfet8ChannelSlice1/MosfetChannel6/gate: Q15.1 (G), R29.2, R30.1
/Mosfet8ChannelSlice1/MosfetChannel7/gate: Q16.1 (G), R31.2, R32.1
/Mosfet8ChannelSlice1/MosfetChannel8/gate: Q17.1 (G), R33.2, R34.1
/Mosfet8ChannelSlice1/MosfetChannel9/gate: Q18.1 (G), R35.2, R36.1
/Mosfet8ChannelSlice1/MosfetChannel/gate: Q13.1 (G), R25.2, R26.1
/Mosfet8ChannelSlice1/MosfetChannel/m_gnd: Q9.2 (S), Q10.2 (S), Q11.2 (S), Q12.2 (S), Q13.2 (S), Q14.2 (S), Q15.2 (S), Q16.2 (S), Q17.2 (S), Q18.2 (S), R18.2, R20.2, R22.2, R24.2, R26.2, R28.2, R30.2, R32.2, R34.2, R36.2; also elsewhere on the board
/Mosfet8ChannelSlice1/in1: R25.1; also elsewhere on the board
/Mosfet8ChannelSlice1/in2: R21.1; also elsewhere on the board
/Mosfet8ChannelSlice1/in3: R19.1; also elsewhere on the board
/Mosfet8ChannelSlice1/in4: R17.1; also elsewhere on the board
/Mosfet8ChannelSlice1/in5: R27.1; also elsewhere on the board
/Mosfet8ChannelSlice1/in6: R23.1; also elsewhere on the board
/Mosfet8ChannelSlice1/in7: R29.1; also elsewhere on the board
/Mosfet8ChannelSlice1/in8: R31.1; also elsewhere on the board
/Mosfet8ChannelSlice1/in9: R33.1; also elsewhere on the board
/Mosfet8ChannelSlice1/in10: R35.1; also elsewhere on the board
/Mosfet8ChannelSlice1/out1: Q13.3 (D); also elsewhere on the board
/Mosfet8ChannelSlice1/out2: Q11.3 (D); also elsewhere on the board
/Mosfet8ChannelSlice1/out3: Q10.3 (D); also elsewhere on the board
/Mosfet8ChannelSlice1/out4: Q9.3 (D); also elsewhere on the board
/Mosfet8ChannelSlice1/out5: Q14.3 (D); also elsewhere on the board
/Mosfet8ChannelSlice1/out6: Q12.3 (D); also elsewhere on the board
/Mosfet8ChannelSlice1/out7: Q15.3 (D); also elsewhere on the board
/Mosfet8ChannelSlice1/out8: Q16.3 (D); also elsewhere on the board
/Mosfet8ChannelSlice1/out9: Q17.3 (D); also elsewhere on the board
/Mosfet8ChannelSlice1/out10: Q18.3 (D); also elsewhere on the board
/Mosfet8ChannelSlice2/MosfetChannel1/gate: Q21.1 (G), R41.2, R42.1
/Mosfet8ChannelSlice2/MosfetChannel2/gate: Q20.1 (G), R39.2, R40.1
/Mosfet8ChannelSlice2/MosfetChannel3/gate: Q19.1 (G), R37.2, R38.1
/Mosfet8ChannelSlice2/MosfetChannel4/gate: Q24.1 (G), R47.2, R48.1
/Mosfet8ChannelSlice2/MosfetChannel5/gate: Q22.1 (G), R43.2, R44.1
/Mosfet8ChannelSlice2/MosfetChannel6/gate: Q25.1 (G), R49.2, R50.1
/Mosfet8ChannelSlice2/MosfetChannel7/gate: Q26.1 (G), R51.2, R52.1
/Mosfet8ChannelSlice2/MosfetChannel8/gate: Q27.1 (G), R53.2, R54.1
/Mosfet8ChannelSlice2/MosfetChannel9/gate: Q28.1 (G), R55.2, R56.1
/Mosfet8ChannelSlice2/MosfetChannel/gate: Q23.1 (G), R45.2, R46.1
/Mosfet8ChannelSlice2/MosfetChannel/m_gnd: Q19.2 (S), Q20.2 (S), Q21.2 (S), Q22.2 (S), Q23.2 (S), Q24.2 (S), Q25.2 (S), Q26.2 (S), Q27.2 (S), Q28.2 (S), R38.2, R40.2, R42.2, R44.2, R46.2, R48.2, R50.2, R52.2, R54.2, R56.2; also elsewhere on the board
/Mosfet8ChannelSlice2/in1: R45.1; also elsewhere on the board
/Mosfet8ChannelSlice2/in2: R41.1; also elsewhere on the board
/Mosfet8ChannelSlice2/in3: R39.1; also elsewhere on the board
/Mosfet8ChannelSlice2/in4: R37.1; also elsewhere on the board
/Mosfet8ChannelSlice2/in5: R47.1; also elsewhere on the board
/Mosfet8ChannelSlice2/in6: R43.1; also elsewhere on the board
/Mosfet8ChannelSlice2/in7: R49.1; also elsewhere on the board
/Mosfet8ChannelSlice2/in8: R51.1; also elsewhere on the board
/Mosfet8ChannelSlice2/in9: R53.1; also elsewhere on the board
/Mosfet8ChannelSlice2/in10: R55.1; also elsewhere on the board
/Mosfet8ChannelSlice2/out1: Q23.3 (D); also elsewhere on the board
/Mosfet8ChannelSlice2/out2: Q21.3 (D); also elsewhere on the board
/Mosfet8ChannelSlice2/out3: Q20.3 (D); also elsewhere on the board
/Mosfet8ChannelSlice2/out4: Q19.3 (D); also elsewhere on the board
/Mosfet8ChannelSlice2/out5: Q24.3 (D); also elsewhere on the board
/Mosfet8ChannelSlice2/out6: Q22.3 (D); also elsewhere on the board
/Mosfet8ChannelSlice2/out7: Q25.3 (D); also elsewhere on the board
/Mosfet8ChannelSlice2/out8: Q26.3 (D); also elsewhere on the board
/Mosfet8ChannelSlice2/out9: Q27.3 (D); also elsewhere on the board
/Mosfet8ChannelSlice2/out10: Q28.3 (D); also elsewhere on the board
/Mosfet8ChannelSlice3/MosfetChannel1/gate: Q31.1 (G), R61.2, R62.1
/Mosfet8ChannelSlice3/MosfetChannel2/gate: Q30.1 (G), R59.2, R60.1
/Mosfet8ChannelSlice3/MosfetChannel3/gate: Q29.1 (G), R57.2, R58.1
/Mosfet8ChannelSlice3/MosfetChannel4/gate: Q34.1 (G), R67.2, R68.1
/Mosfet8ChannelSlice3/MosfetChannel5/gate: Q32.1 (G), R63.2, R64.1
/Mosfet8ChannelSlice3/MosfetChannel6/gate: Q35.1 (G), R69.2, R70.1
/Mosfet8ChannelSlice3/MosfetChannel7/gate: Q36.1 (G), R71.2, R72.1
/Mosfet8ChannelSlice3/MosfetChannel8/gate: Q37.1 (G), R73.2, R74.1
/Mosfet8ChannelSlice3/MosfetChannel9/gate: Q38.1 (G), R75.2, R76.1
/Mosfet8ChannelSlice3/MosfetChannel/gate: Q33.1 (G), R65.2, R66.1
/Mosfet8ChannelSlice3/MosfetChannel/m_gnd: Q29.2 (S), Q30.2 (S), Q31.2 (S), Q32.2 (S), Q33.2 (S), Q34.2 (S), Q35.2 (S), Q36.2 (S), Q37.2 (S), Q38.2 (S), R58.2, R60.2, R62.2, R64.2, R66.2, R68.2, R70.2, R72.2, R74.2, R76.2; also elsewhere on the board
/Mosfet8ChannelSlice3/in1: R65.1; also elsewhere on the board
/Mosfet8ChannelSlice3/in2: R61.1; also elsewhere on the board
/Mosfet8ChannelSlice3/in3: R59.1; also elsewhere on the board
/Mosfet8ChannelSlice3/in4: R57.1; also elsewhere on the board
/Mosfet8ChannelSlice3/in5: R67.1; also elsewhere on the board
/Mosfet8ChannelSlice3/in6: R63.1; also elsewhere on the board
/Mosfet8ChannelSlice3/in7: R69.1; also elsewhere on the board
/Mosfet8ChannelSlice3/in8: R71.1; also elsewhere on the board
/Mosfet8ChannelSlice3/in9: R73.1; also elsewhere on the board
/Mosfet8ChannelSlice3/in10: R75.1; also elsewhere on the board
/Mosfet8ChannelSlice3/out1: Q33.3 (D); also elsewhere on the board
/Mosfet8ChannelSlice3/out2: Q31.3 (D); also elsewhere on the board
/Mosfet8ChannelSlice3/out3: Q30.3 (D); also elsewhere on the board
/Mosfet8ChannelSlice3/out4: Q29.3 (D); also elsewhere on the board
/Mosfet8ChannelSlice3/out5: Q34.3 (D); also elsewhere on the board
/Mosfet8ChannelSlice3/out6: Q32.3 (D); also elsewhere on the board
/Mosfet8ChannelSlice3/out7: Q35.3 (D); also elsewhere on the board
/Mosfet8ChannelSlice3/out8: Q36.3 (D); also elsewhere on the board
/Mosfet8ChannelSlice3/out9: Q37.3 (D); also elsewhere on the board
/Mosfet8ChannelSlice3/out10: Q38.3 (D); also elsewhere on the board
/Mosfet8ChannelSlice4/MosfetChannel1/gate: Q41.1 (G), R81.2, R82.1
/Mosfet8ChannelSlice4/MosfetChannel2/gate: Q40.1 (G), R79.2, R80.1
/Mosfet8ChannelSlice4/MosfetChannel3/gate: Q39.1 (G), R77.2, R78.1
/Mosfet8ChannelSlice4/MosfetChannel4/gate: Q44.1 (G), R87.2, R88.1
/Mosfet8ChannelSlice4/MosfetChannel5/gate: Q42.1 (G), R83.2, R84.1
/Mosfet8ChannelSlice4/MosfetChannel6/gate: Q45.1 (G), R89.2, R90.1
/Mosfet8ChannelSlice4/MosfetChannel7/gate: Q46.1 (G), R91.2, R92.1
/Mosfet8ChannelSlice4/MosfetChannel8/gate: Q47.1 (G), R93.2, R94.1
/Mosfet8ChannelSlice4/MosfetChannel9/gate: Q48.1 (G), R95.2, R96.1
/Mosfet8ChannelSlice4/MosfetChannel/gate: Q43.1 (G), R85.2, R86.1
/Mosfet8ChannelSlice4/MosfetChannel/m_gnd: Q39.2 (S), Q40.2 (S), Q41.2 (S), Q42.2 (S), Q43.2 (S), Q44.2 (S), Q45.2 (S), Q46.2 (S), Q47.2 (S), Q48.2 (S), R78.2, R80.2, R82.2, R84.2, R86.2, R88.2, R90.2, R92.2, R94.2, R96.2; also elsewhere on the board
/Mosfet8ChannelSlice4/in1: R85.1; also elsewhere on the board
/Mosfet8ChannelSlice4/in2: R81.1; also elsewhere on the board
/Mosfet8ChannelSlice4/in3: R79.1; also elsewhere on the board
/Mosfet8ChannelSlice4/in4: R77.1; also elsewhere on the board
/Mosfet8ChannelSlice4/in5: R87.1; also elsewhere on the board
/Mosfet8ChannelSlice4/in6: R83.1; also elsewhere on the board
/Mosfet8ChannelSlice4/in7: R89.1; also elsewhere on the board
/Mosfet8ChannelSlice4/in8: R91.1; also elsewhere on the board
/Mosfet8ChannelSlice4/in9: R93.1; also elsewhere on the board
/Mosfet8ChannelSlice4/in10: R95.1; also elsewhere on the board
/Mosfet8ChannelSlice4/out1: Q43.3 (D); also elsewhere on the board
/Mosfet8ChannelSlice4/out2: Q41.3 (D); also elsewhere on the board
/Mosfet8ChannelSlice4/out3: Q40.3 (D); also elsewhere on the board
/Mosfet8ChannelSlice4/out4: Q39.3 (D); also elsewhere on the board
/Mosfet8ChannelSlice4/out5: Q44.3 (D); also elsewhere on the board
/Mosfet8ChannelSlice4/out6: Q42.3 (D); also elsewhere on the board
/Mosfet8ChannelSlice4/out7: Q45.3 (D); also elsewhere on the board
/Mosfet8ChannelSlice4/out8: Q46.3 (D); also elsewhere on the board
/Mosfet8ChannelSlice4/out9: Q47.3 (D); also elsewhere on the board
/Mosfet8ChannelSlice4/out10: Q48.3 (D); also elsewhere on the board
/Mosfet8ChannelSlice/MosfetChannel1/gate: Q2.1 (G), R3.2, R4.1
/Mosfet8ChannelSlice/MosfetChannel2/gate: Q3.1 (G), R5.2, R6.1
/Mosfet8ChannelSlice/MosfetChannel3/gate: Q4.1 (G), R7.2, R8.1
/Mosfet8ChannelSlice/MosfetChannel4/gate: Q5.1 (G), R9.2, R10.1
/Mosfet8ChannelSlice/MosfetChannel5/gate: Q6.1 (G), R11.2, R12.1
/Mosfet8ChannelSlice/MosfetChannel6/gate: Q7.1 (G), R13.2, R14.1
/Mosfet8ChannelSlice/MosfetChannel7/gate: Q8.1 (G), R15.2, R16.1
/Mosfet8ChannelSlice/MosfetChannel8/gate: Q49.1 (G), R97.2, R98.1
/Mosfet8ChannelSlice/MosfetChannel9/gate: Q50.1 (G), R99.2, R100.1
/Mosfet8ChannelSlice/MosfetChannel/m_gnd: Q2.2 (S), Q3.2 (S), Q4.2 (S), Q5.2 (S), Q6.2 (S), Q7.2 (S), Q8.2 (S), Q49.2 (S), Q50.2 (S), R4.2, R6.2, R8.2, R10.2, R12.2, R14.2, R16.2, R98.2, R100.2; also elsewhere on the board
/Mosfet8ChannelSlice/in2: R3.1; also elsewhere on the board
/Mosfet8ChannelSlice/in3: R5.1; also elsewhere on the board
/Mosfet8ChannelSlice/in4: R7.1; also elsewhere on the board
/Mosfet8ChannelSlice/in5: R9.1; also elsewhere on the board
/Mosfet8ChannelSlice/in6: R11.1; also elsewhere on the board
/Mosfet8ChannelSlice/in7: R13.1; also elsewhere on the board
/Mosfet8ChannelSlice/in8: R15.1; also elsewhere on the board
/Mosfet8ChannelSlice/in9: R97.1; also elsewhere on the board
/Mosfet8ChannelSlice/in10: R99.1; also elsewhere on the board
/Mosfet8ChannelSlice/out2: Q2.3 (D); also elsewhere on the board
/Mosfet8ChannelSlice/out3: Q3.3 (D); also elsewhere on the board
/Mosfet8ChannelSlice/out4: Q4.3 (D); also elsewhere on the board
/Mosfet8ChannelSlice/out5: Q5.3 (D); also elsewhere on the board
/Mosfet8ChannelSlice/out6: Q6.3 (D); also elsewhere on the board
/Mosfet8ChannelSlice/out7: Q7.3 (D); also elsewhere on the board
/Mosfet8ChannelSlice/out8: Q8.3 (D); also elsewhere on the board
/Mosfet8ChannelSlice/out9: Q49.3 (D); also elsewhere on the board
/Mosfet8ChannelSlice/out10: Q50.3 (D); also elsewhere on the board

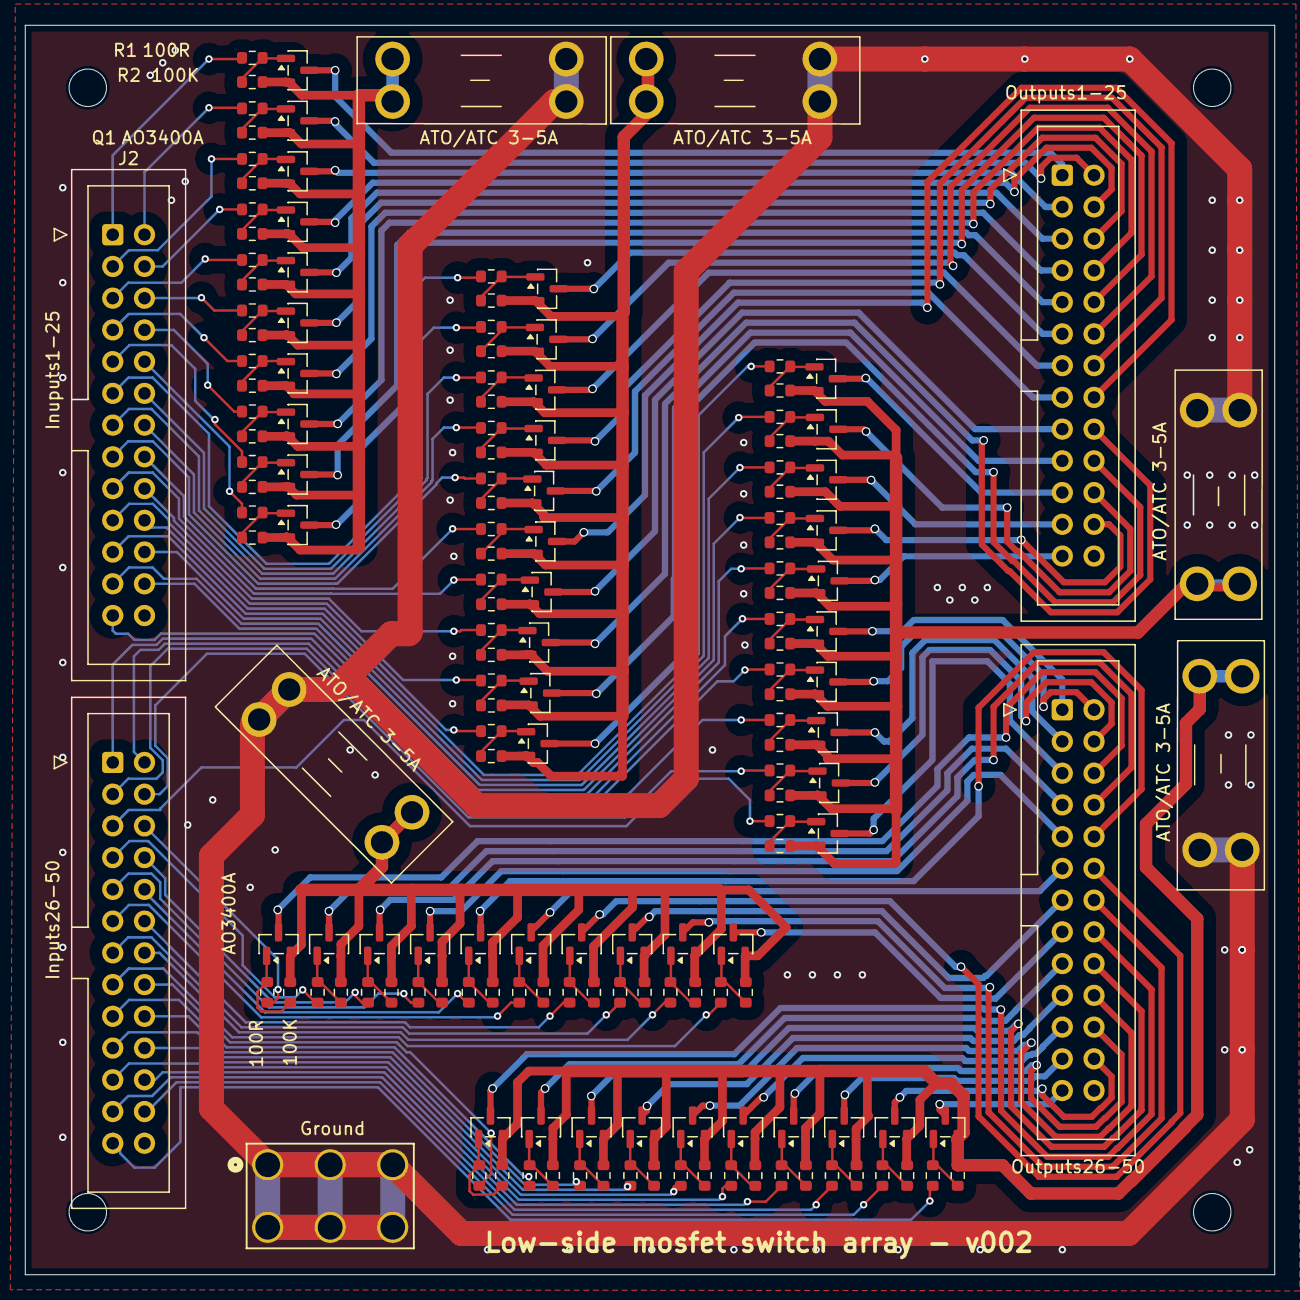
[picture p55: board OrganMosfetArray.kicad_pcb from above]

Board: 2 copper layers, 100.0 x 100.0 mm, 160 parts (0 on the bottom side), 156 nets.
