dkhorn/organ/kicad/OrganMosfetArrayChimes/OrganMosfetArrayChimes.kicad_pcb

## KiCad design kicad/OrganMosfetArrayChimes/OrganMosfetArrayChimes.kicad_pcb (2025-11-23)

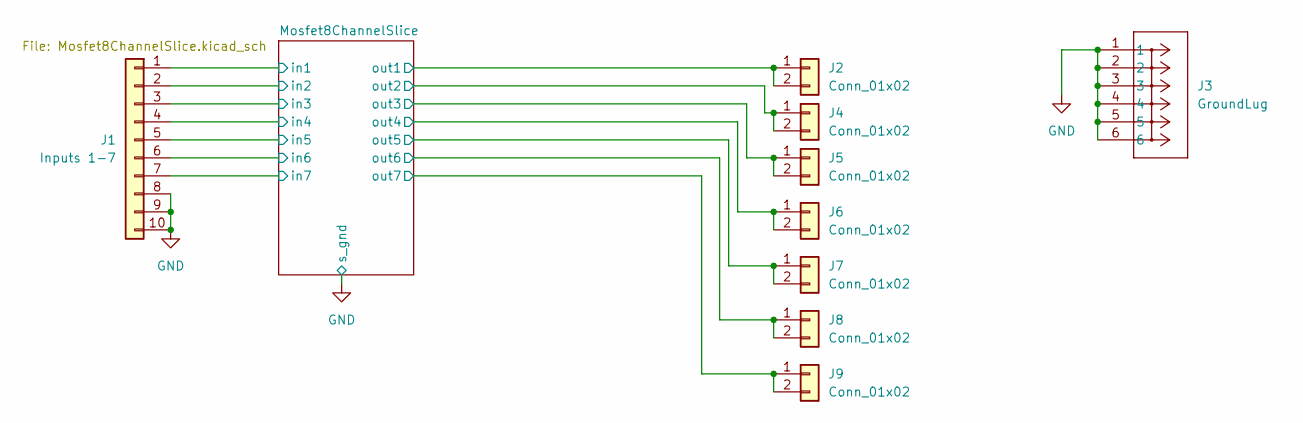
[picture p56: schematic OrganMosfetArrayChimes.kicad_sch]

Parts:
J1: Inputs 1-7; IDC-Header_2x05_P2.54mm_Vertical
J2, J4, J5, J6, J7, J8, J9: Conn_01x02; PinHeader_1x02_P2.54mm_Vertical
J3: GroundLug; CONN_8199_KEY

Connections:
/Mosfet8ChannelSlice/in1: J1.1; also elsewhere on the board
/Mosfet8ChannelSlice/in2: J1.2; also elsewhere on the board
/Mosfet8ChannelSlice/in3: J1.3; also elsewhere on the board
/Mosfet8ChannelSlice/in4: J1.4; also elsewhere on the board
/Mosfet8ChannelSlice/in5: J1.5; also elsewhere on the board
/Mosfet8ChannelSlice/in6: J1.6; also elsewhere on the board
/Mosfet8ChannelSlice/in7: J1.7; also elsewhere on the board
/Mosfet8ChannelSlice/out1: J2.1, J2.2; also elsewhere on the board
/Mosfet8ChannelSlice/out2: J4.1, J4.2; also elsewhere on the board
/Mosfet8ChannelSlice/out3: J5.1, J5.2; also elsewhere on the board
/Mosfet8ChannelSlice/out4: J6.1, J6.2; also elsewhere on the board
/Mosfet8ChannelSlice/out5: J7.1, J7.2; also elsewhere on the board
/Mosfet8ChannelSlice/out6: J8.1, J8.2; also elsewhere on the board
/Mosfet8ChannelSlice/out7: J9.1, J9.2; also elsewhere on the board
GND: J1.8, J1.9, J1.10, J3.1, J3.2, J3.3, J3.4, J3.5, J3.6; also elsewhere on the board

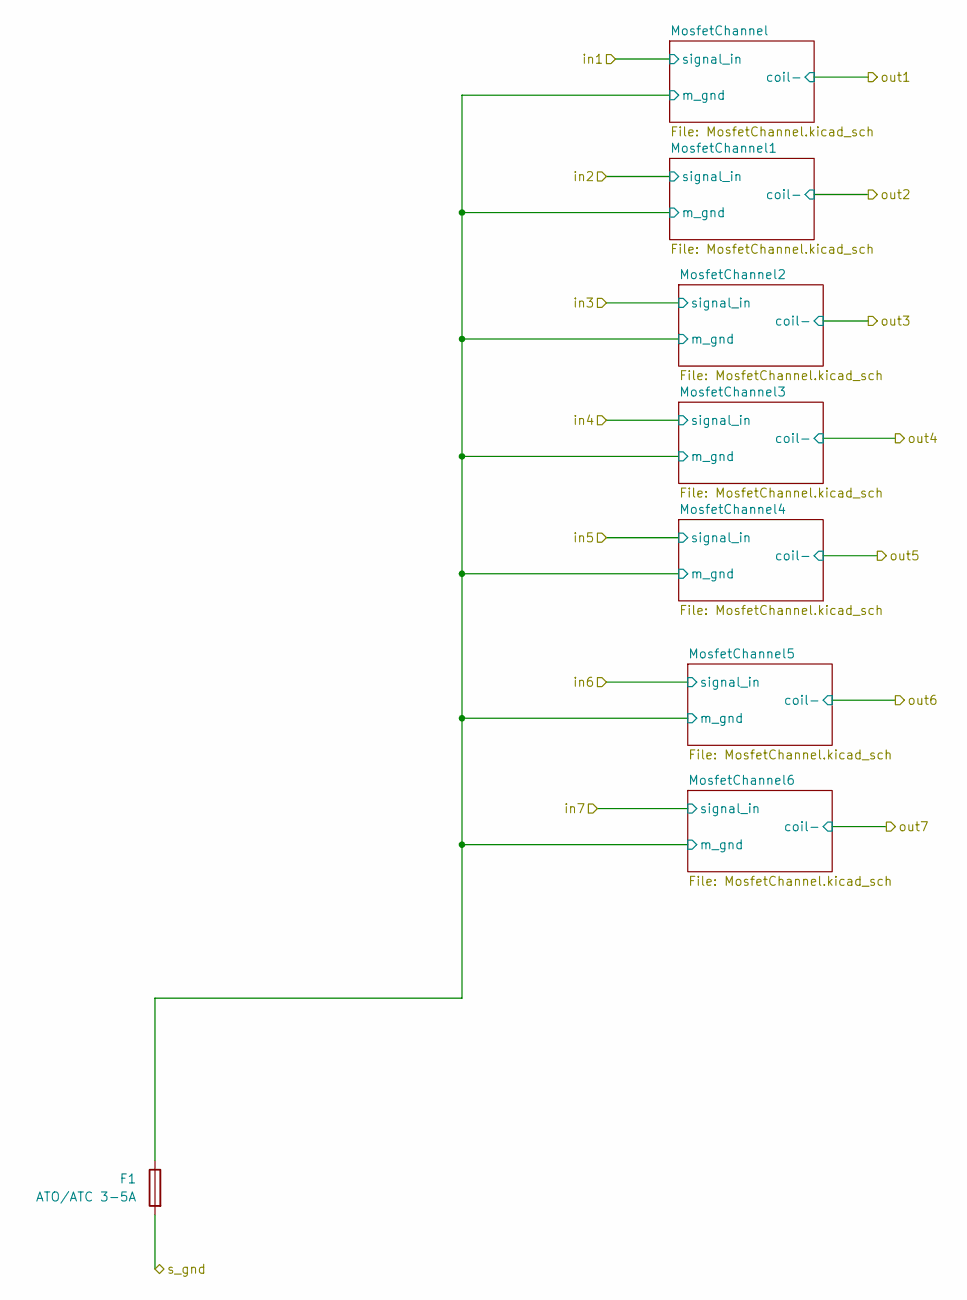
[picture p57: schematic Mosfet8ChannelSlice.kicad_sch]

Parts:
F1: ATO/ATC 3-5A; AliExpressFuseHolder

Connections:
/Mosfet8ChannelSlice/MosfetChannel/m_gnd: F1.1; also elsewhere on the board
GND: F1.2; also elsewhere on the board

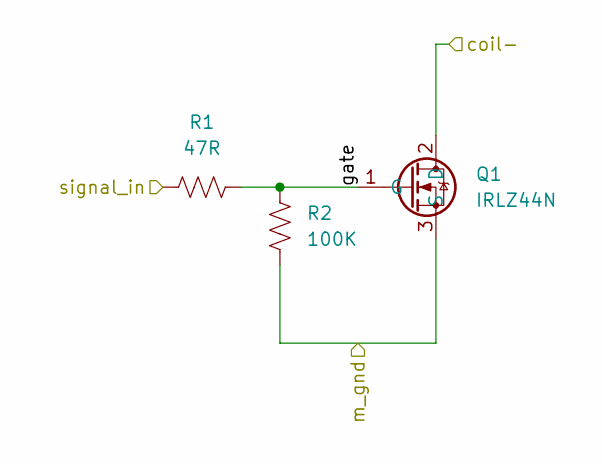
[picture p58: schematic MosfetChannel.kicad_sch]

Parts:
Q1: IRLZ44N; TO-220-3_Vertical
R1: 47R; R_Axial_DIN0207_L6.3mm_D2.5mm_P2.54mm_Vertical
R2: 100K; R_Axial_DIN0207_L6.3mm_D2.5mm_P2.54mm_Vertical

Connections:
/Mosfet8ChannelSlice/MosfetChannel/gate: Q1.1 (G), R1.2, R2.1
/Mosfet8ChannelSlice/MosfetChannel/m_gnd: Q1.3 (S), R2.2; also elsewhere on the board
/Mosfet8ChannelSlice/in1: R1.1; also elsewhere on the board
/Mosfet8ChannelSlice/out1: Q1.2 (D); also elsewhere on the board

Parts of its further copies:
Q2, Q3, Q4, Q5, Q6, Q7: IRLZ44N; TO-220-3_Vertical
R3, R5, R7, R9, R11, R13: 47R; R_Axial_DIN0207_L6.3mm_D2.5mm_P2.54mm_Vertical
R4, R6, R8, R10, R12, R14: 100K; R_Axial_DIN0207_L6.3mm_D2.5mm_P2.54mm_Vertical

Connections of its further copies:
/Mosfet8ChannelSlice/MosfetChannel1/gate: Q2.1 (G), R3.2, R4.1
/Mosfet8ChannelSlice/MosfetChannel2/gate: Q3.1 (G), R5.2, R6.1
/Mosfet8ChannelSlice/MosfetChannel3/gate: Q4.1 (G), R7.2, R8.1
/Mosfet8ChannelSlice/MosfetChannel4/gate: Q5.1 (G), R9.2, R10.1
/Mosfet8ChannelSlice/MosfetChannel5/gate: Q6.1 (G), R11.2, R12.1
/Mosfet8ChannelSlice/MosfetChannel6/gate: Q7.1 (G), R13.2, R14.1
/Mosfet8ChannelSlice/MosfetChannel/m_gnd: Q2.3 (S), Q3.3 (S), Q4.3 (S), Q5.3 (S), Q6.3 (S), Q7.3 (S), R4.2, R6.2, R8.2, R10.2, R12.2, R14.2; also elsewhere on the board
/Mosfet8ChannelSlice/in2: R3.1; also elsewhere on the board
/Mosfet8ChannelSlice/in3: R5.1; also elsewhere on the board
/Mosfet8ChannelSlice/in4: R7.1; also elsewhere on the board
/Mosfet8ChannelSlice/in5: R9.1; also elsewhere on the board
/Mosfet8ChannelSlice/in6: R11.1; also elsewhere on the board
/Mosfet8ChannelSlice/in7: R13.1; also elsewhere on the board
/Mosfet8ChannelSlice/out2: Q2.2 (D); also elsewhere on the board
/Mosfet8ChannelSlice/out3: Q3.2 (D); also elsewhere on the board
/Mosfet8ChannelSlice/out4: Q4.2 (D); also elsewhere on the board
/Mosfet8ChannelSlice/out5: Q5.2 (D); also elsewhere on the board
/Mosfet8ChannelSlice/out6: Q6.2 (D); also elsewhere on the board
/Mosfet8ChannelSlice/out7: Q7.2 (D); also elsewhere on the board
