dkhorn/organ/kicad/OrganMosfetArrayChimes/OrganMosfetArrayChimes.kicad_pcb

## KiCad design kicad/OrganMosfetArrayChimes/OrganMosfetArrayChimes.kicad_pcb (continued)

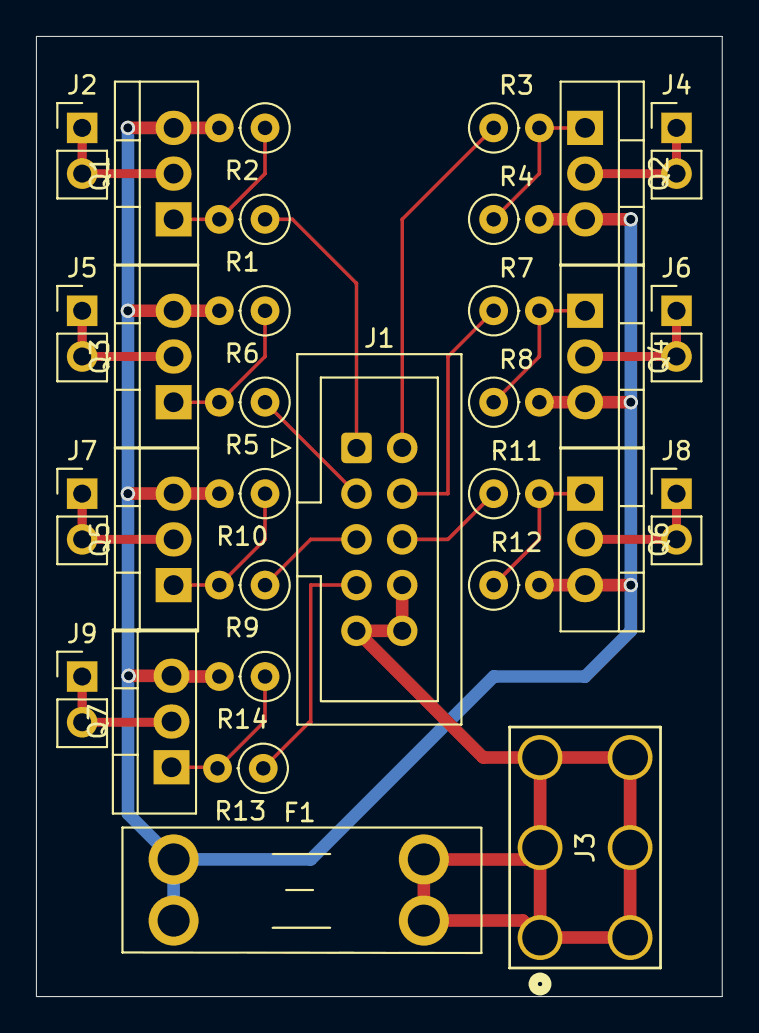
[picture p59: board OrganMosfetArrayChimes.kicad_pcb from above]

Board: 2 copper layers, 38.1 x 53.3 mm, 31 parts (0 on the bottom side), 23 nets.
