dkhorn/organ/chimes/src/main.cpp

#include <Arduino.h>
#include <WiFi.h>
#include <ESPmDNS.h>
#include <ArduinoOTA.h>
#include "chimes.h"
#include "httpserver.h"
#include "midinote.h"
#include "midiseq.h"
#include "noterepeater.h"
#include "logger.h"
#include "timekeeping.h"
#include "clockchimes.h"
#include "midireceiver.h"
#include "midiudp.h"
#include "midifiles.h"

#ifndef OTA_HOSTNAME
#define OTA_HOSTNAME "esp32s3"
#endif
#ifndef OTA_PASSWORD
#define OTA_PASSWORD "changeme"
#endif
#ifndef APP_VERSION
#define APP_VERSION "0.0.0"
#endif

// ---- WiFi creds ----
static const char* WIFI_SSID = "HAWI";
static const char* WIFI_PASS = "murphalurf18";

// Status LED (GPIO 38 is the RGB LED on ESP32-S3-DevKitC-1)
#define LED_PIN 38

// Telnet server for remote logging
WiFiServer telnetServer(23);
WiFiClient telnetClient;

static void wifi_connect() {
  WiFi.mode(WIFI_STA);
  WiFi.begin(WIFI_SSID, WIFI_PASS);
  // Serial.print("Connecting to WiFi");
  uint32_t t0 = millis();
  while (WiFi.status() != WL_CONNECTED) {
    delay(200);
    // Serial.print(".");
    if ((millis() - t0) > 15000) {
      // Serial.println(" timeout!");
      return;
    }
  }
  // Serial.println(" connected!");
}

static void ota_begin() {
  ArduinoOTA.setHostname(OTA_HOSTNAME);
  ArduinoOTA.setPassword(OTA_PASSWORD);
  ArduinoOTA.onStart([] {
    Log.println("OTA Start");
  });
  ArduinoOTA.onEnd([] {
    Log.println("\nOTA End");
  });
  ArduinoOTA.onProgress([](unsigned int prog, unsigned int total) {
    // Quick blink as progress indicator
    digitalWrite(LED_PIN, (prog / 16) & 1);
    Log.printf("Progress: %u%%\r", (prog * 100) / total);
  });
  ArduinoOTA.onError([](ota_error_t error) {
    Log.printf("OTA Error[%u]: ", error);
    if (error == OTA_AUTH_ERROR) Log.println("Auth Failed");
    else if (error == OTA_BEGIN_ERROR) Log.println("Begin Failed");
    else if (error == OTA_CONNECT_ERROR) Log.println("Connect Failed");
    else if (error == OTA_RECEIVE_ERROR) Log.println("Receive Failed");
    else if (error == OTA_END_ERROR) Log.println("End Failed");
  });
  ArduinoOTA.begin();

  if (!MDNS.begin(OTA_HOSTNAME)) {
    Log.println("mDNS failed (OTA still works by IP)");
  } else {
    MDNS.addService("arduino", "tcp", 3232);
    Log.println("mDNS started");
  }
  
  // Start telnet server
  telnetServer.begin();
  telnetServer.setNoDelay(true);
  Log.println("Telnet server started on port 23");
}

void setup() {
  
  // Serial.begin(115200);
  delay(200);

  Log.println("\n\n=== Chime Ctrl ===");
  
  wifi_connect();
  
  if (WiFi.status() == WL_CONNECTED) {
    ota_begin();
    httpserver_begin();
    Log.printf("IP: %s\n", WiFi.localIP().toString().c_str());
  } else {
    Log.println("IP: Not connected");
  }
  
  chimes_begin();
  midinote_begin();
  midiseq_begin();
  noterepeater_setup();
  midiReceiver.begin();
  midiUDP.begin();  // Start MIDI/UDP receiver on port 21928
  midiFiles.begin();  // Initialize MIDI file manager (SPIFFS)
  timekeeping.begin();
  clockChimes.begin();
  Log.printf("Host: %s\n", OTA_HOSTNAME);
  Log.printf("Version: %s\n\n", APP_VERSION);
  Log.println("Setup complete!");
}

void loop() {
  // WiFi reconnection logic
  static uint32_t lastWiFiCheck = 0;
  static bool wasConnected = false;
  if (millis() - lastWiFiCheck > 10000) {  // Check every 10 seconds
    lastWiFiCheck = millis();
    bool isConnected = (WiFi.status() == WL_CONNECTED);
    
    if (!isConnected) {
      Log.println("WiFi disconnected, attempting to reconnect...");
      wifi_connect();
      if (WiFi.status() == WL_CONNECTED) {
        Log.printf("WiFi reconnected! IP: %s\n", WiFi.localIP().toString().c_str());
        // Notify timekeeping of reconnection
        timekeeping.onWiFiReconnect();
      }
    } else if (!wasConnected && isConnected) {
      // Just connected (state transition)
      Log.printf("WiFi connected! IP: %s\n", WiFi.localIP().toString().c_str());
      timekeeping.onWiFiReconnect();
    }
    wasConnected = isConnected;
  }
  
  // Handle telnet connections
  if (WiFi.status() == WL_CONNECTED) {
    // Check for new telnet clients (only when a NEW client connects)
    if (telnetServer.hasClient()) {
      WiFiClient newClient = telnetServer.available();
      if (newClient) {
        // Disconnect old client if exists
        if (telnetClient && telnetClient.connected()) {
          telnetClient.stop();
        }
        telnetClient = newClient;
        Log.setTelnetClient(&telnetClient);
        Log.println("\nTelnet client connected");
      }
    }
    
    // Handle OTA
    ArduinoOTA.handle();
    
    // Handle HTTP requests
    httpserver_loop();
  }


  // // Ring chimes sequentially every 0.5 seconds
  // static uint32_t chime_timer = 0;
  // static int chime_index = 0;
  // if (millis() - chime_timer > 500) {
  //   chime_timer = millis();
  //   ring_chime(chime_index);
  //   chime_index = (chime_index + 1) % 20;
  //   Log.printf("Rang chime %d\n", chime_index);
  // }
  // Update MIDI receiver
  midiReceiver.update();
  
  // Update MIDI/UDP receiver
  midiUDP.update();
  
  // Update MIDI sequencer
  midiseq_loop();
  
  // Update note repeater
  noterepeater_loop();
  
  // Update timekeeping (NTP sync)
  timekeeping.update();
  
  // Update clock chimes
  clockChimes.update();
  
  // Your app work here...
  chimes_loop();
}
