dkhorn/organ/windchest_controller/src/httpserver.cpp

// httpserver.cpp
#include <Arduino.h>
#include <WiFi.h>
#include <WebServer.h>
#include "output.h"
#include "midinote.h"
#include "keyboard.h"
#include "midiudp.h"
#include "midireceiver.h"
#include "midihandler.h"
#include "config.h"
#include "config_page.h"
#include "play_page.h"
#include "api_docs.h"
#include "settings_page.h"
#include "pins.h"

static WebServer server(80);

// ---------- Simple Circular Log Buffer ----------
#define LOG_BUFFER_SIZE 100
static String logBuffer[LOG_BUFFER_SIZE];
static int logIndex = 0;
static int logCount = 0;
static int logTotalCount = 0; // Monotonically increasing counter
static bool httpLoggingEnabled = true; // Only enable when logs requested
static String pendingLogLine = ""; // Accumulator for incomplete lines

void httpserver_log(const uint8_t* buffer, size_t size) {
  if (!httpLoggingEnabled) return; // Skip all String building if disabled
  
  // Build String from buffer, accumulating partial lines
  for (size_t i = 0; i < size; i++) {
    char c = buffer[i];
    if (c == '\n') {
      if (pendingLogLine.length() > 0) {
        // Store complete line in buffer
        logBuffer[logIndex] = pendingLogLine;
        logIndex = (logIndex + 1) % LOG_BUFFER_SIZE;
        if (logCount < LOG_BUFFER_SIZE) logCount++;
        logTotalCount++;
        pendingLogLine = "";
      }
    } else if (c != '\r') {
      pendingLogLine += c;
    }
  }
}

// Legacy C-string interface (for compatibility)
void httpserver_log(const char* message) {
  if (!httpLoggingEnabled) return;
  
  logBuffer[logIndex] = String(message);
  logIndex = (logIndex + 1) % LOG_BUFFER_SIZE;
  if (logCount < LOG_BUFFER_SIZE) logCount++;
  logTotalCount++;
}

String httpserver_get_logs() {
  String result = "";
  int start = (logCount < LOG_BUFFER_SIZE) ? 0 : logIndex;
  for (int i = 0; i < logCount; i++) {
    int idx = (start + i) % LOG_BUFFER_SIZE;
    result += logBuffer[idx] + "\n";
  }
  return result;
}

String httpserver_get_logs_since(int sinceTotal) {
  String result = "";
  
  // If asking for logs before our buffer, or invalid, return all
  if (sinceTotal < 0) {
    return httpserver_get_logs();
  }
  
  // Calculate how many new logs since the requested point
  int newCount = logTotalCount - sinceTotal;
  
  // If no new logs, return empty
  if (newCount <= 0) {
    return "";
  }
  
  // If asking for more logs than we have buffered, return all
  if (newCount > logCount) {
    return httpserver_get_logs();
  }
  
  // Calculate starting position in circular buffer
  int start = (logIndex - newCount + LOG_BUFFER_SIZE) % LOG_BUFFER_SIZE;
  for (int i = 0; i < newCount; i++) {
    int idx = (start + i) % LOG_BUFFER_SIZE;
    result += logBuffer[idx] + "\n";
  }
  return result;
}

int httpserver_get_log_index() {
  return logTotalCount;
}

// Handler for GET /channels
static void handleChannels() {
  String html = "<!DOCTYPE html><html><head>";
  html += "<meta name='viewport' content='width=device-width, initial-scale=1'>";
  html += "<style>";
  html += "body { font-family: Arial, sans-serif; margin: 20px; background: #f0f0f0; }";
  html += "h1 { color: #333; }";
  html += ".container { max-width: 600px; margin: 0 auto; background: white; padding: 20px; border-radius: 10px; box-shadow: 0 2px 5px rgba(0,0,0,0.1); }";
  html += ".controls { display: flex; gap: 15px; margin: 15px 0; flex-wrap: wrap; align-items: center; }";
  html += ".control-group { display: flex; gap: 5px; align-items: center; }";
  html += ".control-group label { font-weight: bold; }";
  html += ".control-group input { width: 80px; padding: 5px; font-size: 14px; border: 2px solid #ccc; border-radius: 4px; }";
  html += ".button-grid { display: grid; grid-template-columns: repeat(auto-fill, minmax(80px, 1fr)); gap: 10px; margin-top: 20px; }";
  html += "button { padding: 15px; font-size: 16px; border: 2px solid #4CAF50; background: #4CAF50; color: white; border-radius: 5px; cursor: pointer; transition: all 0.3s; }";
  html += "button:hover { background: #45a049; transform: scale(1.05); }";
  html += "button:active { transform: scale(0.95); }";
  html += ".status { margin-top: 15px; padding: 10px; background: #e8f5e9; border-radius: 5px; display: none; }";
  html += "</style></head><body>";
  html += "<div class='container'>";
  html += "<h1>Chime Controller</h1>";
  html += "<p>Click a button to ring a chime by channel (0-20)</p>";
  html += "<div class='controls'>";
  html += "<div class='control-group'>";
  html += "<label for='kickDuty'>Kick Duty:</label>";
  html += "<input type='number' id='kickDuty' value='100' min='1' max='100' />";
  html += "<span>%</span>";
  html += "</div>";
  html += "<div class='control-group'>";
  html += "<label for='kickHold'>Kick Hold:</label>";
  html += "<input type='number' id='kickHold' value='35' min='0' max='1000' />";
  html += "<span>ms</span>";
  html += "</div>";
  html += "</div>";
  html += "<div class='button-grid'>";
  
  // Create 21 buttons (notes 0-20)
  for (int i = 0; i < 21; i++) {
    html += "<button onclick='ring(" + String(i) + ")'>Ch " + String(i) + "</button>";
  }
  
  html += "</div>";
  html += "<div class='status' id='status'></div>";
  html += "</div>";
  
  // JavaScript to handle button clicks
  html += "<script>";
  html += "function ring(note) {";
  html += "  const duty = document.getElementById('kickDuty').value;";
  html += "  const hold = document.getElementById('kickHold').value;";
  html += "  fetch('/note_on_by_index' + '?note=' + note)";
  html += "    .then(r => r.text())";
  html += "    .then(msg => {";
  html += "      const s = document.getElementById('status');";
  html += "      s.textContent = msg;";
  html += "      s.style.display = 'block';";
  html += "      setTimeout(() => s.style.display = 'none', 2000);";
  html += "    })";
  html += "    .catch(e => console.error('Error:', e));";
  html += "}";
  html += "</script>";
  html += "</body></html>";
  
  server.send(200, "text/html", html);
}

// Handler for GET /logs - Log viewer page
static void handleLogsPage() {
  httpLoggingEnabled = true; // Enable logging on first access
  
  String html = "<!DOCTYPE html><html><head>";
  html += "<meta name='viewport' content='width=device-width, initial-scale=1'>";
  html += "<title>Chime Logs</title>";
  html += "<style>";
  html += "body { font-family: monospace; margin: 0; padding: 20px; background: #1e1e1e; color: #d4d4d4; }";
  html += "h1 { color: #4ec9b0; margin-bottom: 10px; }";
  html += "#log { background: #252526; border: 1px solid #3e3e42; padding: 15px; ";
  html += "height: 70vh; overflow-y: auto; white-space: pre-wrap; word-wrap: break-word; }";
  html += ".controls { margin-bottom: 15px; }";
  html += "button { padding: 8px 16px; background: #0e639c; color: white; border: none; ";
  html += "border-radius: 4px; cursor: pointer; margin-right: 10px; }";
  html += "button:hover { background: #1177bb; }";
  html += ".status { color: #4ec9b0; margin-left: 10px; }";
  html += "</style></head><body>";
  html += "<h1>Chime Controller Logs</h1>";
  html += "<div class='controls'>";
  html += "<button onclick='clearLog()'>Clear</button>";
  html += "<button onclick='toggleAutoScroll()' id='scrollBtn'>Auto-scroll: ON</button>";
  html += "<span class='status' id='status'>Connected</span>";
  html += "</div>";
  html += "<div id='log'></div>";
  html += "<script>";
  html += "let autoScroll = true;";
  html += "let lastIndex = -1;";
  html += "const logDiv = document.getElementById('log');";
  html += "const statusDiv = document.getElementById('status');";
  html += "function fetchLogs() {";
  html += "  fetch('/logs/poll?since=' + lastIndex)";
  html += "    .then(r => r.json())";
  html += "    .then(data => {";
  html += "      if (data.logs) {";
  html += "        logDiv.textContent += data.logs;";
  html += "        if (autoScroll) logDiv.scrollTop = logDiv.scrollHeight;";
  html += "      }";
  html += "      lastIndex = data.index;";
  html += "      statusDiv.textContent = 'Connected';";
  html += "      statusDiv.style.color = '#4ec9b0';";
  html += "    })";
  html += "    .catch(() => {";
  html += "      statusDiv.textContent = 'Error';";
  html += "      statusDiv.style.color = '#f48771';";
  html += "    });";
  html += "}";
  html += "fetchLogs();";
  html += "setInterval(fetchLogs, 1000);";
  html += "function clearLog() { logDiv.textContent = ''; }";
  html += "function toggleAutoScroll() {";
  html += "  autoScroll = !autoScroll;";
  html += "  document.getElementById('scrollBtn').textContent = 'Auto-scroll: ' + (autoScroll ? 'ON' : 'OFF');";
  html += "}";
  html += "</script></body></html>";
  
  server.send(200, "text/html", html);
}

// Handler for GET /logs/poll?since=X - Polling endpoint
static void handleLogsPoll() {
  httpLoggingEnabled = true; // Enable logging if not already
  
  int sinceIndex = -1;
  if (server.hasArg("since")) {
    sinceIndex = server.arg("since").toInt();
  }
  
  String logs = httpserver_get_logs_since(sinceIndex);
  int currentIndex = httpserver_get_log_index();
  
  // Early return for no new logs
  if (logs.length() == 0) {
    String json = "{\"index\":" + String(currentIndex) + ",\"logs\":\"\"}";
    server.send(200, "application/json", json);
    return;
  }
  
  // Reserve capacity to minimize reallocations (rough estimate: logs.length() * 1.2 + 50)
  String json;
  json.reserve(logs.length() + logs.length() / 5 + 50);
  
  json = "{\"index\":" + String(currentIndex) + ",\"logs\":\"";
  
  // Escape the logs for JSON
  for (unsigned int i = 0; i < logs.length(); i++) {
    char c = logs[i];
    if (c == '"') json += "\\\"";
    else if (c == '\\') json += "\\\\";
    else if (c == '\n') json += "\\n";
    else if (c == '\r') json += "\\r";
    else if (c == '\t') json += "\\t";
    else json += c;
  }
  json += "\"}";
  
  server.send(200, "application/json", json);
}

// Handler for GET /keyboard
// Handler for GET /
static void handlePlayPage() {
  server.send_P(200, "text/html", PLAY_PAGE_HTML);
}

static void handleRoot() {
  server.send(200, "text/html", get_keyboard_html());
}

// Handler for GET /note_on?note=X&velocity=Y
static void handleNoteOn() {
  if (!server.hasArg("note")) {
    server.send(400, "text/plain", "Bad Request: Missing 'note' parameter");
    return;
  }
  
  int note = server.arg("note").toInt();
  int velocity = server.hasArg("velocity") ? server.arg("velocity").toInt() : 127;
  
  if (note < 0 || note > 127) {
    server.send(400, "text/plain", "Bad Request: Note must be 0-127");
    return;
  }
  
  if (velocity < 0 || velocity > 127) {
    server.send(400, "text/plain", "Bad Request: Velocity must be 0-127");
    return;
  }
  
  // Route through the common MIDI handler so all subsystems (CAN, etc.) are notified.
  handle_midi_message(0x90, (uint8_t)note, (uint8_t)velocity);
  
  String response = "Note On: " + String(note) + " velocity: " + String(velocity);
  server.send(200, "text/plain", response);
}

// Handler for GET /note_on_by_indx?note=X
static void handleNoteOnByIndex() {
  if (!server.hasArg("note")) {
    server.send(400, "text/plain", "Bad Request: Missing 'note' parameter");
    return;
  }
  
  int note = server.arg("note").toInt();

  setChannel(note, true);
  flushOutput();
  
  String response = "Note On: " + String(note);
  server.send(200, "text/plain", response);
}

// Handler for GET /note_off_by_indx?note=X
static void handleNoteOffByIndex() {
  if (!server.hasArg("note")) {
    server.send(400, "text/plain", "Bad Request: Missing 'note' parameter");
    return;
  }
  
  int note = server.arg("note").toInt();

  setChannel(note, false);
  flushOutput();
  
  String response = "Note Off: " + String(note);
  server.send(200, "text/plain", response);
}

// Handler for GET /note_off?note=X&velocity=Y
static void handleNoteOff() {
  if (!server.hasArg("note")) {
    server.send(400, "text/plain", "Bad Request: Missing 'note' parameter");
    return;
  }
  
  int note = server.arg("note").toInt();
  int velocity = server.hasArg("velocity") ? server.arg("velocity").toInt() : 64;
  
  if (note < 0 || note > 127) {
    server.send(400, "text/plain", "Bad Request: Note must be 0-127");
    return;
  }
  
  if (velocity < 0 || velocity > 127) {
    server.send(400, "text/plain", "Bad Request: Velocity must be 0-127");
    return;
  }
  
  // Route through the common MIDI handler so all subsystems (CAN, etc.) are notified.
  handle_midi_message(0x80, (uint8_t)note, (uint8_t)velocity);
  
  String response = "Note Off: " + String(note) + " velocity: " + String(velocity);
  server.send(200, "text/plain", response);
}

// Handle /all_off endpoint - panic button
void handleAllOff() {
  all_off();
  server.send(200, "text/plain", "All notes off");
}

// Handler for 404 Not Found
static void handleNotFound() {
  String message = "Not Found\n\n";
  message += "URI: " + server.uri() + "\n";
  message += "Method: " + String((server.method() == HTTP_GET) ? "GET" : "POST") + "\n";
  server.send(404, "text/plain", message);
}

// Handler for GET /status - system status including MIDI/UDP
static void handleStatus() {
  String json = "{";
  json += "\"uptime\":" + String(millis()) + ",";
  json += "\"wifi\":{";
  json += "\"connected\":" + String(WiFi.status() == WL_CONNECTED ? "true" : "false") + ",";
  json += "\"ip\":\"" + WiFi.localIP().toString() + "\",";
  json += "\"rssi\":" + String(WiFi.RSSI());
  json += "},";
  json += "\"midiUdp\":{";
  json += "\"listening\":" + String(midiUDP.isListening() ? "true" : "false") + ",";
  json += "\"port\":" + String(midiUDP.getPort()) + ",";
  json += "\"packetsReceived\":" + String(midiUDP.getPacketsReceived()) + ",";
  json += "\"messagesReceived\":" + String(midiUDP.getMessagesReceived()) + ",";
  json += "\"packetsDropped\":" + String(midiUDP.getPacketsDropped());
  json += "}";
  json += "}";
  
  server.send(200, "application/json", json);
}

// Handler for GET /api
static void handleAPIDocumentation() {
  server.send(200, "text/html", API_DOCS_HTML);
}

// Handler for GET /settings
static void handleSettings() {
  server.send(200, "text/html", SETTINGS_PAGE_HTML);
}

// Handler for GET /midi/diag - MIDI receiver diagnostic JSON
// Useful for troubleshooting hardware bring-up.
// pinState / pinSeenHigh / pinSeenLow are sampled at GPIO level,
// independent of the UART, so they work even if baud rate is wrong.
static void handleMidiDiag() {
  // Decode what the pin state tells us
  const char* pinDiag;
  if (!midiReceiver.pinSeenHigh && !midiReceiver.pinSeenLow) {
    pinDiag = "not sampled yet";
  } else if (midiReceiver.pinSeenHigh && !midiReceiver.pinSeenLow) {
    pinDiag = "always HIGH - idle correct (non-inverting) OR no connection";
  } else if (!midiReceiver.pinSeenHigh && midiReceiver.pinSeenLow) {
    pinDiag = "always LOW - inverting opto idle, or pin shorted to GND";
  } else {
    pinDiag = "transitions seen - circuit is producing signal";
  }

  String json = "{";
  json += "\"gpio\":{";
  json += "\"pin\":" + String(PIN_MIDI_RX) + ",";
  json += "\"lastState\":" + String(midiReceiver.lastPinState) + ",";
  json += "\"seenHigh\":" + String(midiReceiver.pinSeenHigh ? "true" : "false") + ",";
  json += "\"seenLow\":" + String(midiReceiver.pinSeenLow ? "true" : "false") + ",";
  json += "\"diagnosis\":\"" + String(pinDiag) + "\"";
  json += "},";
  json += "\"uart\":{";
  json += "\"bytesReceived\":" + String(midiReceiver.bytesReceived) + ",";
  json += "\"lastByte\":\"0x" + String(midiReceiver.lastByte, HEX) + "\",";
  json += "\"messagesHandled\":" + String(midiReceiver.messagesHandled);
  json += "},";
  json += "\"hint\":\"If bytesReceived=0: check wiring/power/circuit. ";
  json += "If bytes>0 but messagesHandled=0: likely signal inversion - ";
  json += "flip MIDI_RX_INVERT in midireceiver.cpp and re-flash.\"";
  json += "}";
  server.send(200, "application/json", json);
}

// Handler for GET /midi/wiggle
// Samples GPIO17 at ~10µs intervals for 500ms (blocks the web server briefly).
// Hit this endpoint WHILE holding down notes on your MIDI keyboard.
// It will tell you definitively whether any signal transitions are reaching the pin.
static void handleMidiWiggle() {
  const uint32_t SAMPLE_US    = 10;      // sample every 10µs
  const uint32_t DURATION_US  = 500000; // 500ms total
  uint32_t transitions = 0;
  uint32_t highCount   = 0;
  uint32_t lowCount    = 0;
  int      prevState   = digitalRead(PIN_MIDI_RX);
  uint32_t start       = micros();

  while ((micros() - start) < DURATION_US) {
    int cur = digitalRead(PIN_MIDI_RX);
    if (cur != prevState) {
      transitions++;
      prevState = cur;
    }
    if (cur) highCount++; else lowCount++;
    delayMicroseconds(SAMPLE_US);
  }

  uint32_t total = highCount + lowCount;
  const char* verdict;
  if (transitions == 0 && highCount == total) {
    verdict = "Pin stuck HIGH - no signal reaching GPIO17. Check wiring from optocoupler output to pin.";
  } else if (transitions == 0 && lowCount == total) {
    verdict = "Pin stuck LOW - shorted to GND, or inverting opto with no MIDI input.";
  } else if (transitions > 0 && transitions < 10) {
    verdict = "A few transitions - possible noise or single note; try holding a chord.";
  } else {
    verdict = "Transitions detected - signal is reaching GPIO17. UART should receive bytes.";
  }

  String json = "{";
  json += "\"pin\":" + String(PIN_MIDI_RX) + ",";
  json += "\"durationMs\":500,";
  json += "\"transitions\":" + String(transitions) + ",";
  json += "\"highSamples\":" + String(highCount) + ",";
  json += "\"lowSamples\":" + String(lowCount) + ",";
  json += "\"verdict\":\"" + String(verdict) + "\"";
  json += "}";
  server.send(200, "application/json", json);
}

// ---- Config page & API ------------------------------------------------

static void handleConfigPage() {
  server.send(200, "text/html", CONFIG_PAGE_HTML);
}

// GET /config/get  — returns full config as JSON (streamed to avoid large heap allocation)
static void handleConfigGet() {
  Config& cfg = config_get();
  server.setContentLength(CONTENT_LENGTH_UNKNOWN);
  server.send(200, "application/json", "");

  char buf[8];
  server.sendContent("{\"num_outputs\":");
  snprintf(buf, sizeof(buf), "%u", cfg.num_outputs);
  server.sendContent(buf);
  server.sendContent(",\"channels\":[");

  for (int ch = 0; ch < MIDI_CHANNELS; ch++) {
    if (ch > 0) server.sendContent(",");
    server.sendContent("{\"enabled\":");
    server.sendContent(cfg.midi[ch].enabled ? "true" : "false");
    server.sendContent(",\"map\":[");
    // Build this channel's map as one stack buffer to minimise sendContent calls
    char mapBuf[640];  // worst-case: 128 values of "-1," = 128*3+1 = 385 bytes; 640 is safe
    int pos = 0;
    for (int n = 0; n < 128; n++) {
      if (n > 0) mapBuf[pos++] = ',';
      pos += snprintf(mapBuf + pos, sizeof(mapBuf) - pos, "%d",
                      (int)cfg.midi[ch].note_to_output[n]);
    }
    server.sendContent(mapBuf, pos);
    server.sendContent("]}");
  }
  server.sendContent("]}");
}

// POST /config/num_outputs  body: value=56
static void handleConfigNumOutputs() {
  if (!server.hasArg("value")) {
    server.send(400, "text/plain", "Missing value");
    return;
  }
  int val = server.arg("value").toInt();
  if (val < 1 || val > MAX_OUTPUT_CHANNELS) {
    server.send(400, "text/plain", "value must be 1-128");
    return;
  }
  config_get().num_outputs = (uint8_t)val;
  config_save_num_outputs();
  server.send(200, "text/plain", "Saved: num_outputs=" + String(val));
}

// POST /config/channel  body: ch=0&enabled=1&map=0,1,2,-1,...
static void handleConfigChannel() {
  if (!server.hasArg("ch") || !server.hasArg("map")) {
    server.send(400, "text/plain", "Missing ch or map");
    return;
  }
  int ch = server.arg("ch").toInt();
  if (ch < 0 || ch >= MIDI_CHANNELS) {
    server.send(400, "text/plain", "ch must be 0-15");
    return;
  }
  Config& cfg = config_get();
  cfg.midi[ch].enabled = server.hasArg("enabled") && server.arg("enabled") == "1";

  // Parse comma-separated map (128 values)
  String mapStr = server.arg("map");
  int note = 0, start = 0;
  for (int i = 0; i <= (int)mapStr.length() && note < 128; i++) {
    if (i == (int)mapStr.length() || mapStr[i] == ',') {
      cfg.midi[ch].note_to_output[note++] = (int8_t)mapStr.substring(start, i).toInt();
      start = i + 1;
    }
  }

  config_save_channel((uint8_t)ch);
  server.send(200, "text/plain", "Saved channel " + String(ch));
}

extern "C" {

void httpserver_begin() {
  // Register route handlers
  server.on("/", HTTP_GET, handleRoot);
  server.on("/play", HTTP_GET, handlePlayPage);
  server.on("/api", HTTP_GET, handleAPIDocumentation);
  server.on("/settings", HTTP_GET, handleSettings);
  server.on("/status", HTTP_GET, handleStatus);
  server.on("/channels", HTTP_GET, handleChannels);
  server.on("/logs", HTTP_GET, handleLogsPage);
  server.on("/logs/poll", HTTP_GET, handleLogsPoll);
  server.on("/note_on_by_index", HTTP_GET, handleNoteOnByIndex);
  server.on("/note_off_by_index", HTTP_GET, handleNoteOffByIndex);
  server.on("/note_on", HTTP_GET, handleNoteOn);
  server.on("/note_off", HTTP_GET, handleNoteOff);
  server.on("/all_off", HTTP_GET, handleAllOff);
  server.on("/midi/diag",            HTTP_GET,  handleMidiDiag);
  server.on("/midi/wiggle",           HTTP_GET,  handleMidiWiggle);
  server.on("/config",                HTTP_GET,  handleConfigPage);
  server.on("/config/get",            HTTP_GET,  handleConfigGet);
  server.on("/config/num_outputs",    HTTP_POST, handleConfigNumOutputs);
  server.on("/config/channel",        HTTP_POST, handleConfigChannel);
  
  // For parameterized routes, we'll handle them in onNotFound
  // and check the path prefix there
  server.onNotFound([]() {
    handleNotFound();
  });
  
  // Start server
  server.begin();
  // Serial.println("HTTP server started on port 80");
}

void httpserver_loop() {
  server.handleClient();
}

} // extern "C"
