dkhorn/organ/chimes/src/songs.h

// songs.h - Hard-coded MIDI song database
#ifndef SONGS_H
#define SONGS_H

#include "midiseq.h"

// Song metadata structure
typedef struct {
  const char* name;
  const MidiEvent* events;
  uint16_t num_events;
  uint16_t ticks_per_quarter;
  uint16_t default_tempo_bpm;
} Song;

// ============================================================================
// DEMO SONG: C Major Scale
// ============================================================================
// Simple ascending C major scale starting at A (MIDI note 69)
// Quarter notes at 120 BPM
static const MidiEvent SONG_DEMO[] = {
  {0,    0x90, 69, 100},  // Note on: A (our chime note 1)
  {480,  0x80, 69, 64},   // Note off: A
  {0,    0x90, 71, 100},  // Note on: B
  {480,  0x80, 71, 64},   // Note off: B
  {0,    0x90, 72, 100},  // Note on: C
  {480,  0x80, 72, 64},   // Note off: C
  {0,    0x90, 74, 100},  // Note on: D
  {480,  0x80, 74, 64},   // Note off: D
  {0,    0x90, 76, 100},  // Note on: E
  {480,  0x80, 76, 64},   // Note off: E
  {0,    0x90, 77, 100},  // Note on: F
  {480,  0x80, 77, 64},   // Note off: F
  {0,    0x90, 79, 100},  // Note on: G
  {480,  0x80, 79, 64},   // Note off: G
  {0,    0x90, 81, 100},  // Note on: A (octave up)
  {960,  0x80, 81, 64},   // Note off: A (hold longer)
};

// ============================================================================
// CHROMATIC SCALE: 16th notes
// ============================================================================
// Full chromatic scale across all 20 chimes (MIDI 69-88)
// 16th notes = 120 ticks each at 480 ticks per quarter
// At 120 BPM, 16th note = 125ms
static const MidiEvent SONG_CHROMATIC[] = {
  // MIDI 69-78 (notes 1-10: A through F#)
  {0,   0x90, 69, 100},  {120, 0x80, 69, 64},  // A
  {0,   0x90, 70, 100},  {120, 0x80, 70, 64},  // A#
  {0,   0x90, 71, 100},  {120, 0x80, 71, 64},  // B
  {0,   0x90, 72, 100},  {120, 0x80, 72, 64},  // C
  {0,   0x90, 73, 100},  {120, 0x80, 73, 64},  // C#
  {0,   0x90, 74, 100},  {120, 0x80, 74, 64},  // D
  {0,   0x90, 75, 100},  {120, 0x80, 75, 64},  // D#
  {0,   0x90, 76, 100},  {120, 0x80, 76, 64},  // E
  {0,   0x90, 77, 100},  {120, 0x80, 77, 64},  // F
  {0,   0x90, 78, 100},  {120, 0x80, 78, 64},  // F#
  
  // MIDI 79-88 (notes 11-20: G through E)
  {0,   0x90, 79, 100},  {120, 0x80, 79, 64},  // G
  {0,   0x90, 80, 100},  {120, 0x80, 80, 64},  // G#
  {0,   0x90, 81, 100},  {120, 0x80, 81, 64},  // A
  {0,   0x90, 82, 100},  {120, 0x80, 82, 64},  // A#
  {0,   0x90, 83, 100},  {120, 0x80, 83, 64},  // B
  {0,   0x90, 84, 100},  {120, 0x80, 84, 64},  // C
  {0,   0x90, 85, 100},  {120, 0x80, 85, 64},  // C#
  {0,   0x90, 86, 100},  {120, 0x80, 86, 64},  // D
  {0,   0x90, 87, 100},  {120, 0x80, 87, 64},  // D#
  {0,   0x90, 88, 100},  {120, 0x80, 88, 64},  // E
  
  // Descending back down
  {0,   0x90, 87, 100},  {120, 0x80, 87, 64},  // D#
  {0,   0x90, 86, 100},  {120, 0x80, 86, 64},  // D
  {0,   0x90, 85, 100},  {120, 0x80, 85, 64},  // C#
  {0,   0x90, 84, 100},  {120, 0x80, 84, 64},  // C
  {0,   0x90, 83, 100},  {120, 0x80, 83, 64},  // B
  {0,   0x90, 82, 100},  {120, 0x80, 82, 64},  // A#
  {0,   0x90, 81, 100},  {120, 0x80, 81, 64},  // A
  {0,   0x90, 80, 100},  {120, 0x80, 80, 64},  // G#
  {0,   0x90, 79, 100},  {120, 0x80, 79, 64},  // G
  {0,   0x90, 78, 100},  {120, 0x80, 78, 64},  // F#
  {0,   0x90, 77, 100},  {120, 0x80, 77, 64},  // F
  {0,   0x90, 76, 100},  {120, 0x80, 76, 64},  // E
  {0,   0x90, 75, 100},  {120, 0x80, 75, 64},  // D#
  {0,   0x90, 74, 100},  {120, 0x80, 74, 64},  // D
  {0,   0x90, 73, 100},  {120, 0x80, 73, 64},  // C#
  {0,   0x90, 72, 100},  {120, 0x80, 72, 64},  // C
  {0,   0x90, 71, 100},  {120, 0x80, 71, 64},  // B
  {0,   0x90, 70, 100},  {120, 0x80, 70, 64},  // A#
  {0,   0x90, 69, 100},  {120, 0x80, 69, 64},  // A
};

// ============================================================================
// IMPORTED MELODY
// ============================================================================
// Imported from MIDI file, transposed +19 semitones to fit chime range
// Original: notes 56-68, First transpose: +13 to 69-81, Second transpose: +6 to 75-87
static const MidiEvent SONG_IMPORTED[] = {
  {   10, 0x90,  75, 121},
  {  220, 0x80,  75,  64},
  {   20, 0x90,  77, 119},
  {  220, 0x80,  77,  64},
  {   20, 0x90,  80, 121},
  {  220, 0x80,  80,  64},
  {   20, 0x90,  77, 123},
  {  220, 0x80,  77,  64},
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
  {0,    0x90, 87, 127}, {480, 0x80, 87, 64},
  {1440, 0x90, 88,   1}, {480, 0x80, 88, 64}, // Note 88 (E)
  {0,    0x90, 88,  32}, {480, 0x80, 88, 64},
  {0,    0x90, 88,  64}, {480, 0x80, 88, 64},
  {0,    0x90, 88,  96}, {480, 0x80, 88, 64},
  {0,    0x90, 88, 127}, {480, 0x80, 88, 64},
};

// ============================================================================
// ODE TO JOY (Beethoven's 9th Symphony) - Main Theme
// ============================================================================
// Starting at MIDI 76 (E), with dramatic crescendo and diminuendo
// Quarter notes at 120 BPM with expressive dynamics
static const MidiEvent SONG_ODE_TO_JOY[] = {
  // First phrase - mezzo-piano building to forte
  {0,    0x90, 76,  70}, {480, 0x80, 76, 64},  // E
  {0,    0x90, 76,  75}, {480, 0x80, 76, 64},  // E
  {0,    0x90, 77,  80}, {480, 0x80, 77, 64},  // F
  {0,    0x90, 79,  85}, {480, 0x80, 79, 64},  // G
  {0,    0x90, 79,  90}, {480, 0x80, 79, 64},  // G
  {0,    0x90, 77,  95}, {480, 0x80, 77, 64},  // F
  {0,    0x90, 76, 100}, {480, 0x80, 76, 64},  // E
  {0,    0x90, 74, 105}, {480, 0x80, 74, 64},  // D
  
  // Second phrase - forte with slight pull back
  {0,    0x90, 72, 110}, {480, 0x80, 72, 64},  // C
  {0,    0x90, 72, 105}, {480, 0x80, 72, 64},  // C
  {0,    0x90, 74, 100}, {480, 0x80, 74, 64},  // D
  {0,    0x90, 76,  95}, {480, 0x80, 76, 64},  // E
  {0,    0x90, 76, 100}, {720, 0x80, 76, 64},  // E (dotted quarter)
  {0,    0x90, 74,  75}, {240, 0x80, 74, 64},  // D (eighth)
  {0,    0x90, 74,  70}, {960, 0x80, 74, 64},  // D (half note)
  
  // Third phrase - repeat with variation
  {0,    0x90, 76,  70}, {480, 0x80, 76, 64},  // E
  {0,    0x90, 76,  75}, {480, 0x80, 76, 64},  // E
  {0,    0x90, 77,  80}, {480, 0x80, 77, 64},  // F
  {0,    0x90, 79,  85}, {480, 0x80, 79, 64},  // G
  {0,    0x90, 79,  90}, {480, 0x80, 79, 64},  // G
  {0,    0x90, 77,  95}, {480, 0x80, 77, 64},  // F
  {0,    0x90, 76, 100}, {480, 0x80, 76, 64},  // E
  {0,    0x90, 74, 105}, {480, 0x80, 74, 64},  // D
  
  // Final phrase - triumphant ending
  {0,    0x90, 72, 110}, {480, 0x80, 72, 64},  // C
  {0,    0x90, 72, 105}, {480, 0x80, 72, 64},  // C
  {0,    0x90, 74, 100}, {480, 0x80, 74, 64},  // D
  {0,    0x90, 76,  95}, {480, 0x80, 76, 64},  // E
  {0,    0x90, 74,  90}, {720, 0x80, 74, 64},  // D (dotted quarter)
  {0,    0x90, 72,  85}, {240, 0x80, 72, 64},  // C (eighth)
  {0,    0x90, 72, 115}, {960, 0x80, 72, 64},  // C (half note - forte ending)
};

// ============================================================================
// CANON IN D (Pachelbel) - Opening melody
// ============================================================================
// Gentle, flowing melody with subtle dynamics
// Starting at MIDI 77 (F#), moderate tempo
static const MidiEvent SONG_CANON[] = {
  // First phrase - gentle and lyrical (mp)
  {0,    0x90, 77,  65}, {960, 0x80, 77, 64},  // F# (half)
  {0,    0x90, 76,  60}, {960, 0x80, 76, 64},  // E
  {0,    0x90, 74,  62}, {960, 0x80, 74, 64},  // D
  {0,    0x90, 72,  58}, {960, 0x80, 72, 64},  // C#
  {0,    0x90, 71,  60}, {960, 0x80, 71, 64},  // B
  {0,    0x90, 69,  63}, {960, 0x80, 69, 64},  // A
  {0,    0x90, 71,  65}, {960, 0x80, 71, 64},  // B
  {0,    0x90, 72,  68}, {960, 0x80, 72, 64},  // C#
  
  // Second phrase - building slightly (mf)
  {0,    0x90, 77,  75}, {480, 0x80, 77, 64},  // F# (quarter)
  {0,    0x90, 72,  70}, {480, 0x80, 72, 64},  // C#
  {0,    0x90, 76,  78}, {480, 0x80, 76, 64},  // E
  {0,    0x90, 71,  72}, {480, 0x80, 71, 64},  // B
  {0,    0x90, 74,  80}, {480, 0x80, 74, 64},  // D
  {0,    0x90, 69,  75}, {480, 0x80, 69, 64},  // A
  {0,    0x90, 71,  77}, {480, 0x80, 71, 64},  // B
  {0,    0x90, 77,  82}, {480, 0x80, 77, 64},  // F#
  
  // Third phrase - peak and gentle descent
  {0,    0x90, 77,  85}, {720, 0x80, 77, 64},  // F# (dotted quarter)
  {0,    0x90, 76,  80}, {240, 0x80, 76, 64},  // E (eighth)
  {0,    0x90, 77,  75}, {480, 0x80, 77, 64},  // F#
  {0,    0x90, 72,  70}, {480, 0x80, 72, 64},  // C#
  {0,    0x90, 74,  68}, {480, 0x80, 74, 64},  // D
  {0,    0x90, 72,  65}, {480, 0x80, 72, 64},  // C#
  {0,    0x90, 71,  60}, {960, 0x80, 71, 64},  // B (half - soft ending)
};

// ============================================================================
// GREENSLEEVES - Traditional English Folk Song
// ============================================================================
// Flowing 3/4 time with expressive phrasing
// Starting at MIDI 76 (E), waltz-like feel
static const MidiEvent SONG_GREENSLEEVES[] = {
  // Opening phrase - wistful and gentle (p to mp)
  {0,    0x90, 69,  50}, {480, 0x80, 69, 64},  // A (pickup)
  {0,    0x90, 72,  58}, {720, 0x80, 72, 64},  // C (dotted quarter)
  {0,    0x90, 74,  62}, {240, 0x80, 74, 64},  // D (eighth)
  {0,    0x90, 76,  65}, {480, 0x80, 76, 64},  // E
  {0,    0x90, 77,  68}, {240, 0x80, 77, 64},  // F (eighth)
  {0,    0x90, 76,  70}, {240, 0x80, 76, 64},  // E (eighth)
  {0,    0x90, 74,  72}, {720, 0x80, 74, 64},  // D (dotted quarter)
  {0,    0x90, 71,  68}, {240, 0x80, 71, 64},  // B (eighth)
  
  // Second phrase - building expression (mp to mf)
  {0,    0x90, 69,  75}, {480, 0x80, 69, 64},  // A
  {0,    0x90, 71,  78}, {240, 0x80, 71, 64},  // B (eighth)
  {0,    0x90, 72,  80}, {240, 0x80, 72, 64},  // C (eighth)
  {0,    0x90, 74,  82}, {720, 0x80, 74, 64},  // D (dotted quarter)
  {0,    0x90, 76,  85}, {240, 0x80, 76, 64},  // E (eighth)
  {0,    0x90, 77,  88}, {480, 0x80, 77, 64},  // F
  {0,    0x90, 77,  90}, {240, 0x80, 77, 64},  // F (eighth)
  {0,    0x90, 79,  92}, {240, 0x80, 79, 64},  // G (eighth)
  
  // Third phrase - peak of melody (f)
  {0,    0x90, 81,  95}, {720, 0x80, 81, 64},  // A (dotted quarter - high point)
  {0,    0x90, 79,  93}, {240, 0x80, 79, 64},  // G (eighth)
  {0,    0x90, 77,  90}, {480, 0x80, 77, 64},  // F
  {0,    0x90, 76,  88}, {240, 0x80, 76, 64},  // E (eighth)
  {0,    0x90, 74,  85}, {240, 0x80, 74, 64},  // D (eighth)
  {0,    0x90, 74,  82}, {720, 0x80, 74, 64},  // D (dotted quarter)
  {0,    0x90, 71,  78}, {240, 0x80, 71, 64},  // B (eighth)
  
  // Fourth phrase - gentle descent (mf to mp)
  {0,    0x90, 69,  75}, {480, 0x80, 69, 64},  // A
  {0,    0x90, 71,  72}, {240, 0x80, 71, 64},  // B (eighth)
  {0,    0x90, 72,  70}, {240, 0x80, 72, 64},  // C (eighth)
  {0,    0x90, 74,  68}, {720, 0x80, 74, 64},  // D (dotted quarter)
  {0,    0x90, 76,  65}, {240, 0x80, 76, 64},  // E (eighth)
  {0,    0x90, 77,  62}, {480, 0x80, 77, 64},  // F
  {0,    0x90, 76,  60}, {240, 0x80, 76, 64},  // E (eighth)
  {0,    0x90, 74,  58}, {240, 0x80, 74, 64},  // D (eighth)
  
  // Final phrase - peaceful resolution (p)
  {0,    0x90, 72,  55}, {960, 0x80, 72, 64},  // C (half)
  {0,    0x90, 71,  52}, {480, 0x80, 71, 64},  // B
  {0,    0x90, 69,  50}, {1440, 0x80, 69, 64}, // A (dotted half - gentle close)
};

// ============================================================================
// WIND CHIMES - Atmospheric Pentatonic Improvisation
// ============================================================================
// Natural, flowing wind chime sounds using pentatonic scale
// Strike-only instrument - note_off is irrelevant, all come 1 tick later
// Only the SPACING between note starts matters, creating random wind chime feel
// Pentatonic notes: C(72), D(74), E(76), G(79), A(81) plus octaves
static const MidiEvent SONG_WIND_CHIMES[] = {
  // Very calm - sparse hits (0-2000 tick spacing, 1-15 velocity)
  {0,    0x90, 84,   8}, {1,   0x80, 84, 64},
  {1240, 0x90, 76,  12}, {1,   0x80, 76, 64},
  {8,    0x90, 79,   5}, {1,   0x80, 79, 64},
  {1820, 0x90, 81,  15}, {1,   0x80, 81, 64},
  {420,  0x90, 86,   9}, {1,   0x80, 86, 64},
  {0,    0x90, 74,  18}, {1,   0x80, 74, 64},
  {1650, 0x90, 79,   7}, {1,   0x80, 79, 64},
  {980,  0x90, 72,  14}, {1,   0x80, 72, 64},
  {45,   0x90, 81,  11}, {1,   0x80, 81, 64},
  {1380, 0x90, 76,   6}, {1,   0x80, 76, 64},
  
  // Stirring - medium sparse (0-1500 spacing, 10-30 velocity)
  {920,  0x90, 84,  22}, {1,   0x80, 84, 64},
  {12,   0x90, 79,  28}, {1,   0x80, 79, 64},
  {1240, 0x90, 81,  18}, {1,   0x80, 81, 64},
  {380,  0x90, 74,  32}, {1,   0x80, 74, 64},
  {0,    0x90, 86,  25}, {1,   0x80, 86, 64},
  {1120, 0x90, 76,  20}, {1,   0x80, 76, 64},
  {580,  0x90, 88,  30}, {1,   0x80, 88, 64},
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
  {960, 0x90, 69, 110}, {1, 0x80, 69, 64},
  {0,   0x90, 76, 110}, {1, 0x80, 76, 64},
  {960, 0x90, 69, 110}, {1, 0x80, 69, 64},
  {0,   0x90, 76, 110}, {1, 0x80, 76, 64},
  {960, 0x90, 69, 110}, {1, 0x80, 69, 64},
  {0,   0x90, 76, 110}, {960, 0x80, 76, 64},
};

// ============================================================================
// SONG DATABASE
// ============================================================================
static const Song SONGS[] = {
  {
    "Velocity Test",
    SONG_VELOCITY_TEST,
    sizeof(SONG_VELOCITY_TEST) / sizeof(MidiEvent),
    480,  // ticks per quarter note
    120   // default tempo (BPM)
  },
  {
    "C Major Scale",
    SONG_DEMO,
    sizeof(SONG_DEMO) / sizeof(MidiEvent),
    480,  // ticks per quarter note
    120   // default tempo (BPM)
  },
  {
    "Chromatic Scale",
    SONG_CHROMATIC,
    sizeof(SONG_CHROMATIC) / sizeof(MidiEvent),
    480,  // ticks per quarter note
    120   // default tempo (BPM)
  },
  {
    "Imported Melody",
    SONG_IMPORTED,
    sizeof(SONG_IMPORTED) / sizeof(MidiEvent),
    960,  // ticks per quarter note
    105   // default tempo (BPM)
  },
  {
    "Ode to Joy",
    SONG_ODE_TO_JOY,
    sizeof(SONG_ODE_TO_JOY) / sizeof(MidiEvent),
    480,  // ticks per quarter note
    120   // default tempo (BPM)
  },
  {
    "Canon in D",
    SONG_CANON,
    sizeof(SONG_CANON) / sizeof(MidiEvent),
    480,  // ticks per quarter note
    90    // default tempo (BPM) - slower, more contemplative
  },
  {
    "Greensleeves",
    SONG_GREENSLEEVES,
    sizeof(SONG_GREENSLEEVES) / sizeof(MidiEvent),
    480,  // ticks per quarter note
    100   // default tempo (BPM) - moderate waltz
  },
  {
    "Wind Chimes",
    SONG_WIND_CHIMES,
    sizeof(SONG_WIND_CHIMES) / sizeof(MidiEvent),
    480,  // ticks per quarter note
    80    // default tempo (BPM) - slow and atmospheric
  },
  {
    "Westminster",
    SONG_WESTMINSTER,
    sizeof(SONG_WESTMINSTER) / sizeof(MidiEvent),
    480,  // ticks per quarter note
    120   // default tempo (BPM) - traditional clock speed
  },
  {
    "Whittington",
    SONG_WHITTINGTON,
    sizeof(SONG_WHITTINGTON) / sizeof(MidiEvent),
    480,  // ticks per quarter note
    100   // default tempo (BPM)
  },
  {
    "Winchester",
    SONG_WINCHESTER,
    sizeof(SONG_WINCHESTER) / sizeof(MidiEvent),
    480,  // ticks per quarter note
    110   // default tempo (BPM)
  },
  {
    "St. Michael's",
    SONG_ST_MICHAELS,
    sizeof(SONG_ST_MICHAELS) / sizeof(MidiEvent),
    480,  // ticks per quarter note
    105   // default tempo (BPM)
  },
  {
    "Cambridge",
    SONG_CAMBRIDGE,
    sizeof(SONG_CAMBRIDGE) / sizeof(MidiEvent),
    480,  // ticks per quarter note
    115   // default tempo (BPM)
  },
  {
    "Trinity",
    SONG_TRINITY,
    sizeof(SONG_TRINITY) / sizeof(MidiEvent),
    480,  // ticks per quarter note
    95    // default tempo (BPM)
  },
  {
    "Carillon Chaos",
    SONG_CARILLON,
    sizeof(SONG_CARILLON) / sizeof(MidiEvent),
    480,  // ticks per quarter note
    120   // default tempo (BPM) - steady church bell tempo
  },
  {
    "Hour 1",
    SONG_HOUR_1,
    sizeof(SONG_HOUR_1) / sizeof(MidiEvent),
    480,  // ticks per quarter note
    60    // default tempo (BPM) - 2 second intervals
  },
  {
    "Hour 2",
    SONG_HOUR_2,
    sizeof(SONG_HOUR_2) / sizeof(MidiEvent),
    480,  // ticks per quarter note
    60
  },
  {
    "Hour 3",
    SONG_HOUR_3,
    sizeof(SONG_HOUR_3) / sizeof(MidiEvent),
    480,  // ticks per quarter note
    60
  },
  {
    "Hour 4",
    SONG_HOUR_4,
    sizeof(SONG_HOUR_4) / sizeof(MidiEvent),
    480,  // ticks per quarter note
    60
  },
  {
    "Hour 5",
    SONG_HOUR_5,
    sizeof(SONG_HOUR_5) / sizeof(MidiEvent),
    480,  // ticks per quarter note
    60
  },
  {
    "Hour 6",
    SONG_HOUR_6,
    sizeof(SONG_HOUR_6) / sizeof(MidiEvent),
    480,  // ticks per quarter note
    60
  },
  {
    "Hour 7",
    SONG_HOUR_7,
    sizeof(SONG_HOUR_7) / sizeof(MidiEvent),
    480,  // ticks per quarter note
    60
  },
  {
    "Hour 8",
    SONG_HOUR_8,
    sizeof(SONG_HOUR_8) / sizeof(MidiEvent),
    480,  // ticks per quarter note
    60
  },
  {
    "Hour 9",
    SONG_HOUR_9,
    sizeof(SONG_HOUR_9) / sizeof(MidiEvent),
    480,  // ticks per quarter note
    60
  },
  {
    "Hour 10",
    SONG_HOUR_10,
    sizeof(SONG_HOUR_10) / sizeof(MidiEvent),
    480,  // ticks per quarter note
    60
  },
  {
    "Hour 11",
    SONG_HOUR_11,
    sizeof(SONG_HOUR_11) / sizeof(MidiEvent),
    480,  // ticks per quarter note
    60
  },
  {
    "Hour 12",
    SONG_HOUR_12,
    sizeof(SONG_HOUR_12) / sizeof(MidiEvent),
    480,  // ticks per quarter note
    60
  },
};

#define NUM_SONGS (sizeof(SONGS) / sizeof(Song))

#endif // SONGS_H
