dkhorn/organ/windchest_controller/src/keyboard.h

#ifndef KEYBOARD_H
#define KEYBOARD_H

#ifdef __cplusplus
extern "C" {
#endif

// Get the HTML content for the keyboard interface
const char* get_keyboard_html();

#ifdef __cplusplus
}
#endif

#endif // KEYBOARD_H
