dkhorn/organ/(commit log)

2025-11-19 Initial commit of chimes esp32 project
    [partitions_ota.csv]
2025-11-23 Adding circuit projects
    [LEDsAndTestpoints.kicad_sch, Mosfet8ChannelSlice.kicad_sch, MosfetChannel.kicad_sch, OrganEsp32ParallelOut.kicad_pcb, OrganEsp32ParallelOut.kicad_sch, OrganLEDArray.kicad_pcb, OrganLEDArray.kicad_sch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]
2025-11-26 Adding hardware test program
    [partitions_ota.csv]
2025-12-11 Revert "Refactoring workspaces"
    This reverts commit a825f6877cdec550308f1665d89193b6d4ae9f92.
    [main.cpp, pins.h]
2025-12-15 Adding kicad stuff for MCU board
    [BoardToBoardComms.kicad_sch, MIDI.kicad_sch, OrganUniversalMCUboard.kicad_pcb, OrganUniversalMCUboard.kicad_sch, power.kicad_sch]
2025-12-16 Finishing MCU board and lots of chimes updates
    [BoardToBoardComms.kicad_sch, MIDI.kicad_sch, OrganUniversalMCUboard.kicad_pcb, OrganUniversalMCUboard.kicad_sch, power.kicad_sch]
2025-12-22 Adding keyswitch breakout and inventory list
    [OrganKeyswitchBreakout.kicad_pcb, OrganKeyswitchBreakout.kicad_sch]
2026-01-07 Finalized v001 of MCU board for production
    [MIDI.kicad_sch, OrganKeyswitchBreakout.kicad_sch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]
2026-01-11 Finishing keyswitch breakout board
    [CAN.kicad_sch, Controller.kicad_sch, MIDI.kicad_sch, OrganKeyswitchBreakout.kicad_pcb, OrganKeyswitchBreakout.kicad_sch, breakout_chip.kicad_sch]
2026-02-09 Adding keyswitch breakout system, and some tools
    [Controller.kicad_sch, IDC26Comb.FCStd, KeyBushingCauls_1475-Double.stl, KeyBushingCauls_1475-Single.stl, KeyBushingCauls_1475.FCStd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]
2026-02-09 Adding unified soundboard schematic - unfinished
    [BoardToBoardComms.kicad_sch, Controller.kicad_sch, MIDI.kicad_sch, OrganUnifiedSoundboard.kicad_pcb, OrganUnifiedSoundboard.kicad_sch, power.kicad_sch]
2026-02-11 Adding some custom components that some of the kicad things depend on
    [16_channel_mosfet_output.kicad_sch, 16_channel_output_block.kicad_sch, BoardToBoardComms.kicad_sch, Controller.kicad_sch, MIDI.kicad_sch, OrganUnifiedSoundboard.kicad_pcb, OrganUnifiedSoundboard.kicad_sch, mosfet_channel.kicad_sch]
2026-02-16 Updating hardwaretest to be windchest really, adding some 3d models for things
    [double_valve_pin_guides-ValveStemGuide38.stl, double_valve_pin_guides-ValveStemGuide45.stl, double_valve_pin_guides.FCStd, partitions_ota.csv]
2026-03-05 Adding punch
    [UniversalTransferPunch.FCStd]
2026-03-05 Adding a bunch of documentation, etc
    [PipeDimensions.xlsx, pipe_trays.FCStd]
2026-03-05 Finalized unified soundboard driver for production, adding some models
    [16_channel_mosfet_output.kicad_sch, 16_channel_output_block.kicad_sch, BoardToBoardComms.kicad_sch, Controller.kicad_sch, MIDI.kicad_sch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]
2026-03-09 Updating 3d models
    [PipeDimensions.xlsx, organ_layout.FCStd, pipe_blocks.FCStd, pipe_trays.FCStd, ranks.FCStd]
2026-03-09 layout changes
    [organ_layout.FCStd]
2026-03-09 Adding images of casavant in place, and updating 3d models
    [organ_layout-printable.stl, organ_layout.FCStd]
2026-03-10 Adding printable scale model
    [organ_layout-printable-1.5scale.3mf]
2026-03-10 Updating layouts
    [organ_layout.FCStd, organ_layout_2.FCStd, windchests.FCStd]
2026-03-16 Updating ranks, stops, 3d models
    [organ_layout.FCStd, organ_layout_2.FCStd, windchests.FCStd]
2026-03-17 Adding a bunch of new firmware
    [partitions_ota.csv]
2026-03-19 Updating models
    [PipeDimensions.xlsx, VanPacking.FCStd, pipe_trays.FCStd, ranks.FCStd]
2026-03-23 Adding valve count spreadsheet
    [valve_counts.xlsx]
2026-03-23 Adding another packing option
    [ranks_bigvan.FCStd]
2026-03-26 Adding new models and detailed dimensions
    [BourdonPedal.FCStd, PipeDetailedDimensions.xlsx, StoppedFluteWoodBase.FCStd, pipe_trays.FCStd, ranks_bigvan.FCStd]
2026-03-27 Refining pipes modeling
    [BourdonPedalPipes.FCStd, PipeDetailedDimensions.xlsx, StoppedFluteWoodBase.FCStd]
2026-03-30 Updating bourdon layout
    [BourdonPedalPipes.FCStd, PipeDetailedDimensions.xlsx, StoppedFluteWoodBase.FCStd]
2026-04-03 Adding keyswitch shims for printing
    [PedalKeyswitchShims-Body.stl, PedalKeyswitchShims.FCStd]
